HuiLucas/LugDesign/README.md

# LugDesign
Repository To Optimize a Lug Design

Readme is tbc
