HuiLucas/LugDesign/D03_WP4.pdf

# Cutting-Edge Solar Array

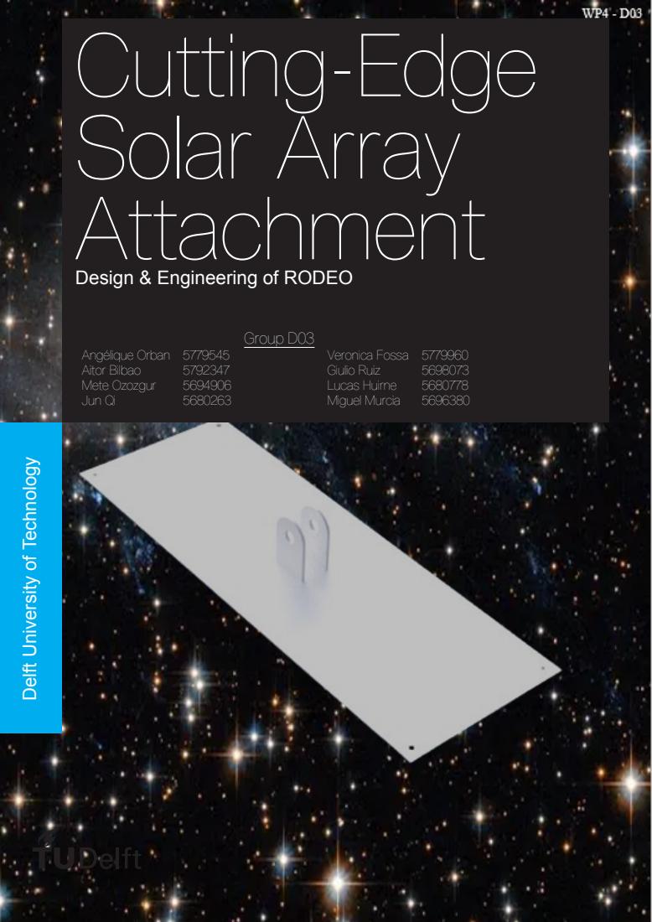
[picture p1: page 1]
Attachment; Group D03; Angélique Orban 5779545; Veronica Fossa 5779960; Aitor Bilbao; Giulio Ruiz; Mete Ozozgur; Lucas Huirne; Jun Qi; Miguel Murcia

Design & Engineering of RODEO

Delft University of Technology

This page is intentionally left blank.

# Cutting-Edge Solar Array

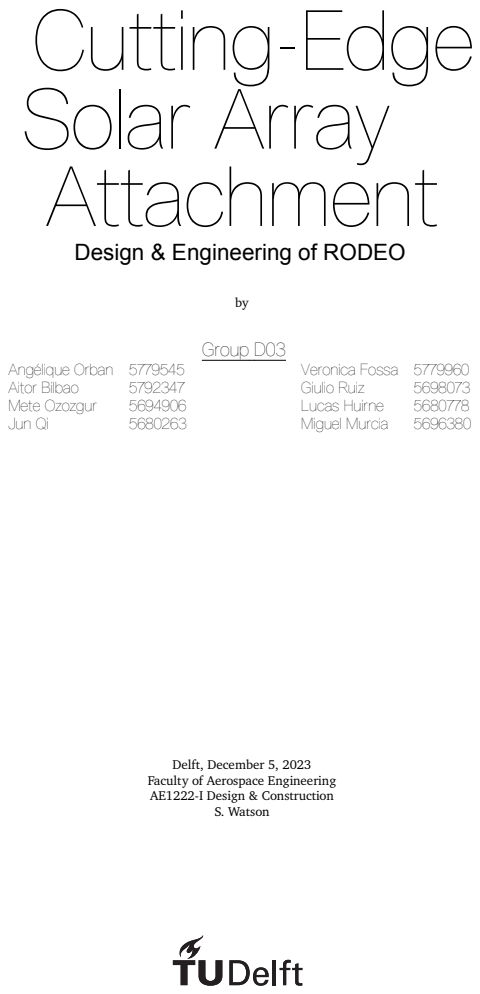
[picture p2: page 3]
Attachment; Group D03; Angélique Orban 5779545; Veronica Fossa 5779960; Aitor Bilbao; Giulio Ruiz; Mete Ozozgur; Lucas Huirne; Jun Qi; Miguel Murcia; S. Watson

Design & Engineering of RODEO

Delft, December 5, 2023
Faculty of Aerospace Engineering
AE1222-I Design & Construction

# Preface

## For tribal man space was the uncontrollable mystery. For technological

man it is time that occupies the same role.

## Marshall McLuhan

This report is the result of the collaborative efforts of eight second-year Aerospace Engineering students at Delft University of Technology. The aim of this report is to document and showcase the scientific rationale and design approach for an Earth-observing satellite under the name of RODEO. RODEO is short for Remote Observer of Data for an Earth Overview. This satellite will bridge a gap in the knowledge of mankind, in a world where precise modeling and prediction of natural phenomena remain elusive. The satellite, equipped with state-of-the-art instruments, will acquire data for weather models, climate models, and seismology.

## RODEO will carry various instruments, that will perform the following functions:

- High-resolution imaging of the Earth’s surface for various ends;
- Measuring of weather and climate variables, as well as volcanic activity with a multi-spectral scanner;
- Atmospheric sounding to measure weather and climate variables at multiple altitudes above land and water.
- Imaging of the earth surface with a radar, to observe the earth in high resolution in the night and

## during cloudy periods

Several constraints on the final design of RODEO have been set by the tender, such as mass, power, size, temperature, reliability, and cost constraints. The mission has to be operational in a Low Earth Orbit for a minimum of five years and needs to be launched in 2025.

The authors would like to thank their TA Calvin Grootenboer for his help during the design process.

## Delft, December 5, 2023 Faculty of Aerospace Engineering | AE2111-I Systems Design (Q2)

Sincerely,

## Miguel Murcia Lucas Huirne Veronica Fossa Angelique Orban Aitor Bilbao Giulio Ruiz de Cardenas Mete Özözgür Jun Qi

i

# Summary

This report analyses the attachment system of the solar panel for the RODEO spacecraft. It shows step by step the design of the lugs, the fasteners and flanges, together with the choice of materials. In the previous work package, the solar energy has been selected as the primary source of energy, with an area

## of 7.54 m²

in order to meet the power requirements and a mass of 17.68 kg. From these values the operational loads together with the launch loads have been studied in chapter 2, caused from the acceleration of the rocket in order to achieve the required orbit. The calculated launch loads can be found in table 2.1.

In chapter 3, the lug configuration have been discussed between one or two lugs and the final decision have been found once the optimization results have been obtained. Moreover, the constrains of the design parameters and the loads that could cause the failure of the lug have been found and put into code using Python, in section 3.2.

In chapter 4, constrains have been added to the fastener for the backup plate and the bearing check have been performed, from identifying the center of mass, to deriving the moment arm, the moment and finally finding the resultant force. The maximum stress has been then compared with the yield strength of the selected material for the back-plate of the lug. Subsequently, the force acting on each fastener has been found, as well as the shear stress caused by it and then compared with the shear yield strength of the material. In section 4.4 the selection of fasteners has been done, observing that the exact dimensions of the fastener depend on the diameter of the hole and the length of the fastener depends on the thickness of the back-plate of the lug.

In chapter 6, the optimization process is explained, which depends on the material, its yield strength and density. Once the optimization is run for each material, a trade-off is established in section 7.1to select the most appropriate one. The final design, described in section 7.3. Two lugs, two flanges and four fasteners have been found to be the best configuration; the material selected for the lug is 2024-T4 and Titanium for fasteners. The total mass is 79.05 kg. More specific information has been summarized in ??. It can be visualized in figure 6.1.

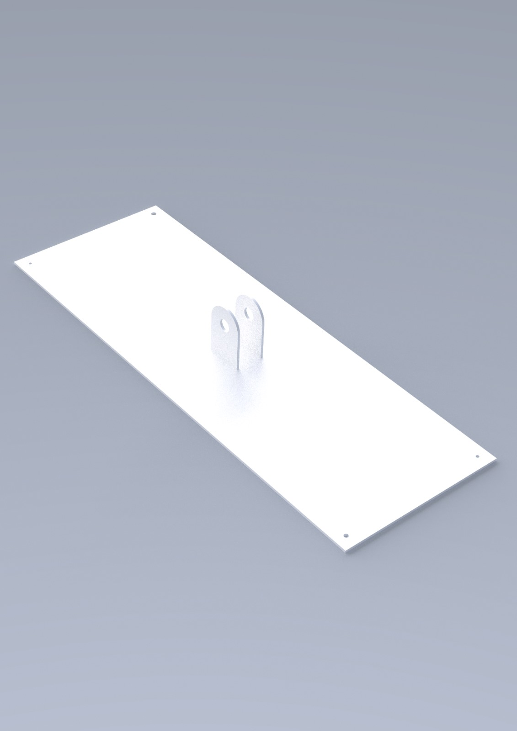
[picture p3: figure]

### Figure 1: Final attachment design

ii

# Contents

Preface | i
Summary | ii
List of Symbols | iv
List of Tables | vi
List of Figures | vi
1 Introduction | 1
2 Load Analysis | 2
3 Lug Configuration and Flange Design | 4
4 Fasteners Configuration | 9
5 Thermal Stresses | 15
6 Optimization Process | 16
7 Material Selection | 20
8 Post Processing and Visualization | 24
9 Conclusion | 25
References | 27
Appendices | 28
A Appendix Code | 29
B Appendix CAD Drawings | 56
C Appendix Task Distribution | 58

## iii

# List of Symbols

## Symbols

WSA | Weight solar array | N
Ra | Ratio of applied axial loads | -
Rtr | Ratio of applied transverse loads | -
M.S. | Margin of safety | W
Kt | Stress concentration factor | -
Ftu | Ultimate tensile force lug | N
At | Net tension area lug | mm²
Kbry | shear-bearing efficiency factor | -
Abr | Bearing area | mm²
FLy | Load along y-axis | N
xcg | x-coordinate of center of gravity | mm
zcg | z-coordinate of center of gravity | mm
Ai | Area of the i-th fastener hole | mm²
xi | x-coordinate of i-th fastener hole | mm
zi | z-coordinate of i-th fastener hole | mm
nf | Number of fasteners | -
Fcgx | Force acting at the center of gravity of the fasteners in the x-direction | N
Fcgz | Force acting at the center of gravity of the fasteners in the z-direction | N
ri | distance of the i-th fastener hole to the center of gravity of the holes | mm
t2 | Thickness of back-plate | mm
t3 | thickness of spacecraft wall | mm
Dfo | Outer fastener diameter | mm
Dfi | Inner fastener diameter | mm
E | Youlgs Modulus | GPa

## Greek Symbols

σ | Normal stress | MPa
σyield | Material yield stress | MPa
τ | Shear stress | MPa
π | Ratio of circumference and diameter | -
φ | Force ratio | -
δ | Compliance/material deflection | mm

## Lug Abbreviations

ℎ | Distance between flanges | mm
t1 | Thickness of flange | mm
w | Width of flange | mm
D2 | Diameter of fastener hole | mm
t2 | Thickness of the back-plate | mm
t3 | Thickness of the satellite skin | mm
D1 | Diameter of the flange hole | mm

iv

v

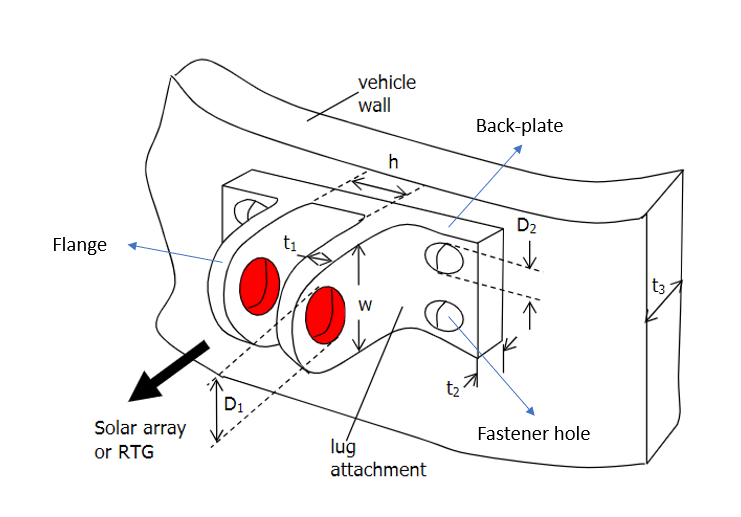
[picture p4: figure]

### Figure 2: Lug Abbreviation Modified [1]

# List of Tables

## 2.1 Summary of launch loads acting on the lug | 3

## 4.1 Fastener Final Choice | 14

## 7.1 Material options that can be used for the fasteners and their properties | 20 7.2 Trade-off table of the materials that can be used for the fasteners | 20

7.3 Properties of available materials for the lug design and resultant mass of chosen lug con-

## figuration | 21 7.4 Trade-off system displaying average weights | 21 7.5 Trade-off table displaying the score | 22 7.6 Final Configuration | 23

## C.1 Task Distribution | 58

# List of Figures

1 | Final attachment design | | ii
2 | Lug Abbreviation Modified [1] | | v
2.1 Launch loads experienced by the lug | | 3
3.1 Stress Concentration factor for axially loaded lug [3] | | 5
3.2 Materials corresponding to the graphs in figure 3.1 [3] | | 6
3.3 Values of shear-bearing factors for lugs [3] | | 7

## 4.1 Coordinate system to determine the centroid | 10 4.2 Stresses produced by the fastener [1] | 12 4.3 Typical fastener with a shank[5] | 14 4.4 Typical substitution length[5] | 14

## 6.1 Flowchart of the MainOptimizer | 19

## 7.1 Final Design | 23

## 9.1 Topology Optimization | 26

vi

1

# Introduction

The RODEO mission is an ambitious Earth Spectral Orbiter endeavor that revolves around a satellite located in a Sun-synchronous low Earth orbit, approximately 700 kilometers above Earth’s surface. The main objective of the mission is to gather information about the Earth’s surface for the purpose of mapping and studying the seismic activity of tectonic plates. Due to the orbit around Earth it is possible to use solar energy as the primary source of energy for the satellite. A fully operational and orientation of the solar array is of big importance in order to accomplish the mission. This includes a good attachment system of the solar array to the spacecraft, which is going to be designed in this report, including a fitting that connects the system to the vehicle and some fasteners.

The aim of this report is to design the attachment lug for the solar panel of the RODEO satellite. The detailed structural design of an attachment lug will initially be performed, by analysing the forces and stresses acting on it, and then the design will be iterated and a trade-off based on the outcomes is going to be necessary to identify the best configuration. Assumption will be done and explained throughout the report, and this will lead to a low-fidelity model.

The report will be presented in the following structure. In chapter 2 a detailed load analysis will be performed, including the operational loads and the launch loads. In chapter 3 different lug configurations will be investigated and successively, the flanges will be designed and analyzed in section 3.2. The fasteners are going to be discussed in chapter 4, with the final selection after checking the different forces acting on them, bearing and pull-through. The effect of thermal fluctuation will then be discussed in ?? and in chapter 6 the optimization process of all the previous analysis performed on Python will explained. The final material selection for the lugs and fasteners will be performed in section 7.1. Finally, insection 7.3 the final design of the attachment system will be presented and in chapter 8 visualisations and post processing will be discussed. The entire code in Python can be found in appendix A, together with the drawings of the final design, in appendix B.

During this project over almost 1750 lines of code were written. This code can be found in the repository ”HuiLucas/LugDesign” on GitHub ¹. To run the code it is possible to clone the code from there. It is also possible to pull a whole container of code from Docker Hub, in the repository ”lhuirne/lug_design3” ². The code was also uploaded to a Microsoft Azure Container Instance and to AWS EC2 using free computing/storage for students, but those are not publicly visible.

¹See: https://github.com/HuiLucas/LugDesign.git ²see: https://hub.docker.com/r/lhuirne/lug_design3

1

2

# Load Analysis

The design of a lug requires an exploration of the several loads and moments that the component will experience during its lifetime. This chapter contains a detailed load analysis describing the launch loads and the operational loads.

# 2.1. Launch Loads

Launch loads occur due to the acceleration of the rocket as it approaches the required orbit. The lug(s) must support the weight of the solar panel in the stowed configuration as it reaches these maximum loads. The stowed configuration assumes that panels are folded in the longitudinal direction of the spacecraft for it to fit inside the payload fairing.

The launch loads that will act on the spacecraft have been given by Space X when describing the Falcon 9 launch rocket. The axial load equals 6g, which is six times the gravitational constant, it is assumed that this constant takes into account 1g of the gravitational pull on the solar array. This acceleration has to be multiplied by the mass of the solar panel to find the force acting on the hinge, which will give a reaction force. The mass of the solar panel is 17.68 kg, thus the total axial force is 1040.64 N using equation 2.1. Knowing that the maximum lateral acceleration of the spacecraft during launch is 2g, the maximum lateral load required to be supported by the lug(s) can be calculated to be 346.88 N using equation 2.2. It can be assumed that this acceleration applies to both x- and y-direction, as the launch vehicle is free to rotate. These lateral accelerations during launch will also cause a moment about the y- and x-axes respectively. To calculate these moments, the distance between the centre of mass of the panel and the reference point of the lug, shown in figure 2.1, where all forces and moments are applied, must be multiplied by the force experienced laterally. Given that the panel has a length of 3.77 meters, and assuming an even distribution of mass along the panel, such a distance equals 1.85 meters, which leads to a maximal moment of 653 Nm about both the y- and x-axes. The moment around the z-axis would only be caused by a spinning of the rocket along its axis, which is negligible, as the Falcon 9 has a very slow spin rate. This moment direction will be non-negligible later on in the analysis, as the forces being introduced at the shaft location, will cause a moment in the z-direction for the back plate and fasteners, which will be discussed further on in the report.

FA = mSAaA | (2.1)
FL = mSAaL | (2.2)

Considering a safety factor of 1.25 [2], the loads summarised in table 2.1 can be obtained. The decomposition of forces and moments generated on the lug(s) due to the launch loads and their reaction can be observed in figure 2.1. The decomposition of forces and moments on the flange(s) and fasteners will be explained throughout the report.
Note that the forces and moments in blue are the reaction loads if the lug is set to be an isolated system.

# 2.2. Operational Loads

RODEO will also suffer external disturbances during its lifetime and will require internal torques to ensure its correct operation. Such internal torques will be generated by an electrical motor that will rotate the solar panel during operation. However, the structure containing the motor will not be load-carrying, instead, the lug will carry all loads and moments. As calculated in WP3, the internal torque required

2

2.2. Operational Loads | 3

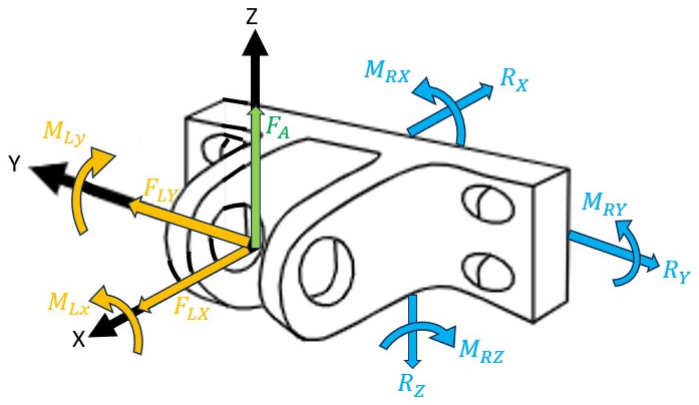
[picture p5: figure]

### Figure 2.1: Launch loads experienced by the lug

### Table 2.1: Summary of launch loads acting on the lug

Force | Value (Magnitude) [N] | Value (SF=1.25) [N]
FA | 1040.7 | 1300.8
FLx | 346.9 | 433.6
FLy | 346.9 | 433.6
Moment | Value (Magnitude) [Nm] | Value (SF=1.25) [Nm]
MLx | 653.9 | 817.4
MLy | 653.9 | 817.4

for changing the orientation of the spacecraft for Night Mode Operation, which is essentially rotating the spacecraft during the eclipse for imaging, equals 3.03 [Nm]. Also, during the eclipse, the spacecraft will suffer a sinusoidal torque of 9.38 [Nm] that will enable accurate imaging of the UMBRA-SAR. The first torque addressed will be applied twice in each orbit. It will be applied during 45 [s], which leads to a slow rotation. For the design of the lug, this torque can be considered negligible.

During Night Mode Operation, the sinusoidal torque will lead to fatigue. However, the value of such a torque leads to a smaller loading than the moments calculated in section 2.1, and will therefore not be considered during the design of the lug. It will be addressed in section 7.1 when selecting the final material.

The goal of determining the load is to obtain the limiting case. It can be observed that the resultant operational loads, derived from these torques, are negligible, or insignificant when compared to the launch loads. Thus, it can be assumed that the moments caused by the operation of the spacecraft won’t limit the design, and only the launch loads should be taken into account.

3

# Lug Configuration and Flange Design

In this chapter, the different lug configurations will be investigated and a choice will be made between the single or double lug setup based on the loading and solar panel attachment. The second part of this section consists of a description of the process behind the design of the flanges.

# 3.1. Selection of lug configuration

## 3.1.1. Comparison between single and double configuration

Two configurations that are investigated are single and double lug configurations. Such a design choice would influence the loading distribution described in figure 2.1, the forces would be halved making the overall dimensions smaller in a two-lugs configuration and the moment acting along the x-axis would be translated into two forces acting on each lug, and would be therefore dependent on the distance between the two lugs, limited to two meters, the width of the spacecraft. The choice of the configuration influences a lot of parameters besides the loading such as the attachment of the solar panel. In a single-lug configuration, the solar panel would have to be attached on the side of the lug resulting in a large moment along the x-axis whereas in a two-lug configuration the solar panel can be attached in between the two lugs, potentially reducing the amount of torque on each lug. One last parameter that the lug configuration would influence is the weight of each lug. Even though not limiting the design, the mass of the lugs should be taken into consideration since selecting a more lightweight design with comparable performances is preferred.
The choice of the final configuration has been taken once the optimization results were obtained in subsection 3.2.2.

## 3.1.2. Locking mechanism for the shaft

Regardless of the configuration chosen, the solar panel shall be attached to the spacecraft by the means of one/two shaft(s) going though the lug(s). The locking mechanism opted for that would stabilize or rotate the solar panel when deploying consists of one or two motors depending on the configuration. In the single-lug configuration, a single shaft connected to one motor would lock the solar panel in place. Whereas in a double lug configuration, given the distance between the lugs came out to be 1.4 meters as a result of the optimization in subsection 3.2.2, the solar panel would be attached with two shafts, each going through one lug. Therefore, each one of the two shafts would be connected to their own motor.

# 3.2. Design of the flanges

## 3.2.1. Constraints on the design parameters

## The design of the lug is based on three considerations:

- The lug shall withstand the limiting loads and moments applied to it, and described in figure 2.1;
- The mass of the lug shall be minimised.

The design of the flange will consider a list of parameters containing the width and thickness of the flange; the diameter of the hole in the flange; and the distance between the two flanges of each of the lugs. These will be determined based on the loading case described under chapter 2.
The calculations made to design the lugs take the limiting stress to be the yield stress with a safety factor of 1.1 [2], in order to prevent catastrophic events due to yielding. Efficiency factors for yield will indeed be used rather than for ultimate tension or stresses. No design constraints were imposed on the maximum deflection of the flange or other elastic behaviour.

4

3.2. Design of the flanges | 5

According to the method described in section D1 of the book ”the Analysis and Design of Flight Vehicle Structures” by Bruhn [3] the lug can fail due to different type of loading. The loading types investigated and analysed for the sizing of the flange are: failure due to tension across the net section, failure due to transverse loads and failure due to shear. To check that whether the lugs will break under the loads applied equation 3.1.
R

1.6

a + R¹.6
tr = 1 | (3.1)
In equation 3.1 the term Ra stands for the axial component of the applied ultimate load divided by the smaller of the two values obtained by calculating the tension across the net section and the shear-out bearing strength [3]. Rtr is the transverse component of the applied ultimate load divided by the yield strength [3].

However not considering a margin of safety would be equivalent to design for the lug to yield during launch, therefore equation 3.1 must be formulated to account for that margin of safety.

M.S. =

1
(R¹.3

a + R¹.6
tr )
0.625 − 1 | (3.2)

The margin of safety given by equation 3.2 can be estimated to be 0.375 and stems from the product of the safety factor of 1.1 on the material properties by the safety factor of 1.25 on the loads and moments.

Then, the allowable axial and transverse forces can be estimated by equation 3.3 and equation 3.4 from the same section D1 mentioned earlier [3].

## Pu = Kt

⋅ Ftu ⋅ At | (3.3)

The axial load Pu is therefore dependent on the ultimate tensile force Ftu or in this case the force FA

## as can be seen in figure 2.1, the net tension area At

## , which is dependent on the dimensions designed for, and the stress concentration factor Kt

## . The latter can be determined depending on the material in

figure 3.1 with the curves corresponding to the material given in figure 3.2.

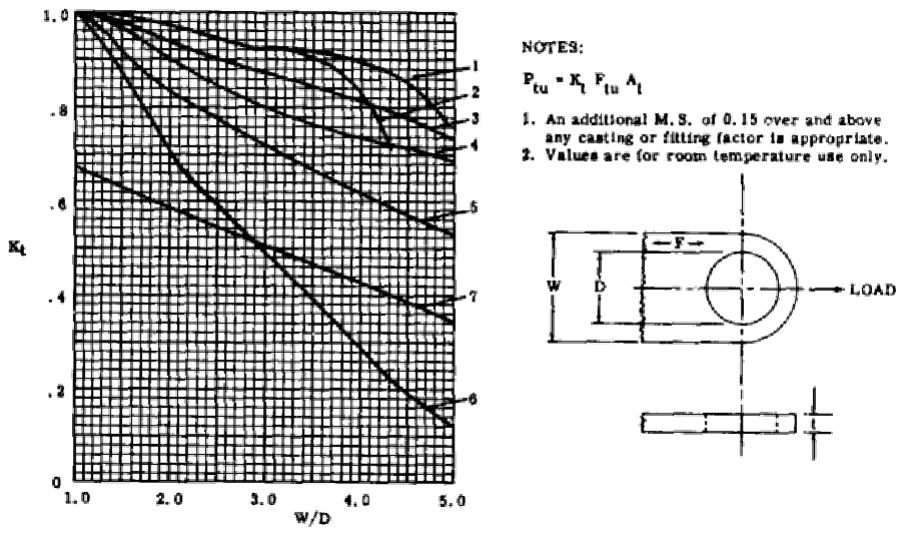
[picture p6: figure]

### Figure 3.1: Stress Concentration factor for axially loaded lug [3]

For the transverse loads, they consists of the forces along the y- and z-axis in figure 2.1 and they will cause the lug to shear if not accounted for. The transverse loads can be computed thanks to equation 3.4. They are therefore dependent on the bearing area, applied forces and shear-bearing yield efficiency factor Kbry, dependent on the thickness-to-diameter ratio (diameter or the hole) of the flange as can be seen in figure 3.3.
Pbr = Kbry ⋅ Ftu ⋅ Abr | (3.4)

In order to make use of Python to iterate through the different possible materials and dimensions, the graphs in figure 3.1 and figure 3.3 were digitized to extract a polynomial relation thanks to the online

3.2. Design of the flanges | 6

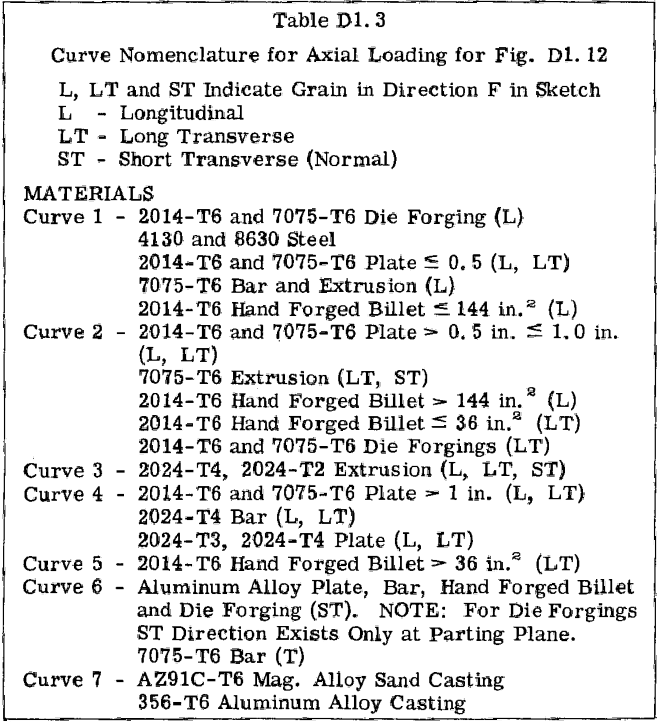
[picture p7: figure]

### Figure 3.2: Materials corresponding to the graphs in figure 3.1 [3]

software automeris.io ¹.

Beside the launch loads, moments are also acting on the lug in the x- and y-directions. As detailed in section 3.1, within a single lug configuration, the moment along the x-axis can be converted into two forces constituting a couple moment that acts on the flanges. Additionally, this force would be combined with the force along the z-axis. When opting for a two lug configuration, the moment along the x-axis creates two equal but opposite in direction forces (couple moment) on the two lugs and, considering the inter-flange distance negligible, the additional force acting on one flange due to this moment would be half the one acting on the lug.

The equation 3.2 can now be adapted given the loading and returns equation 3.5, with d being the distance between the lugs.

M.S. = ((

FLx
Kt

## ⋅ σ ⋅ 1.1 ⋅ At

)

1.6 + (

FA +

My

d⋅NFlanges

## Kty ⋅ Abr ⋅ σ ⋅ 1.1)

1.6)

−0.625 − 1 | (3.5)

Lastly, because of the offset of the load acting along the y-axis, FLy, an extra moment is applied and should also be taken into consideration. Such a moment causes pure bending of the lug and restrict the possible heights of the flange, denoted h. By solving equation 3.6 for the height of the flange, taking the moment of inertia along the z-axis, as it is the axis with smallest moment of inertia, it ensures that the lug will withstand the load.

σyield ⋅ 1.1 =

FLy ⋅ ℎeigℎtflange
I

(3.6)

## 3.2.2. Optimization of the design of the flange

Now that the design constraints regarding the loading have been established, the design process can start. All the lines of code regarding the flange design optimization, digitization of the graphs, etc. can be found in the appendices under Listing A.4.

The function used to generate an optimized lug design is part of the module scipy.optimize, and is called minimize. This function provides a common interface to unconstrained and constrained minimization algorithms for multi-variable functions. In this case, the objective function that is minimized for each material is the mass of a specific part of the flange while constraining the design variables to optimize: the outer radius of the flange e, the thickness t, the diameter of the inner hole to fit in the shaft D and

### ¹https://apps.automeris.io/wpd/

3.2. Design of the flanges | 7

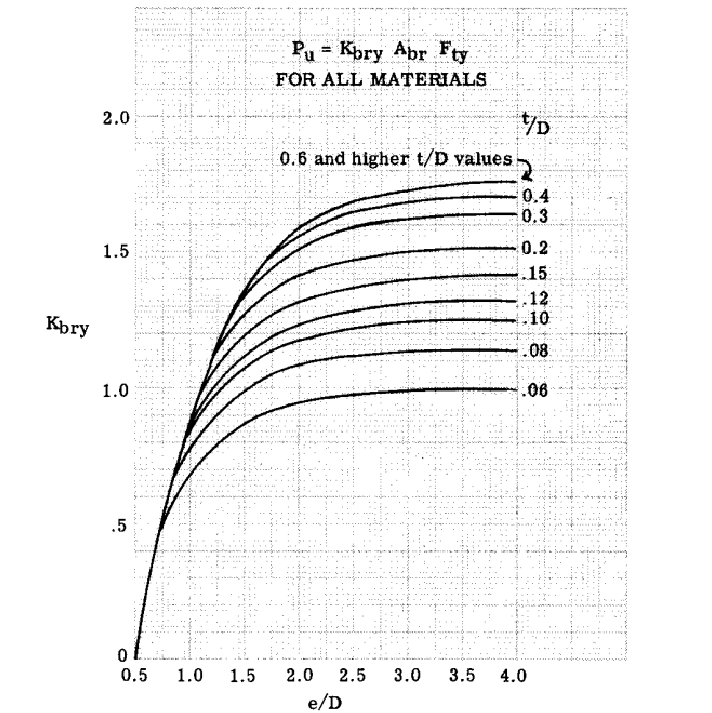
[picture p8: figure]

### Figure 3.3: Values of shear-bearing factors for lugs [3]

the inter-flange distance h.

As mentioned above, the function aims to minimized the the mass of a certain part of the flange, that is the hollow cylinder delimited by the hole and the outer-diameter of the flange. To do so, the algorithm chosen is SLSQP, it minimize a function of one or more variables using Sequential Least Squares Programming. That method was opted for as it allows to constraint the variables given a set of inequalities or equalities. For example, in order to not fail under the launch loads, the design variables should satisfy equation 3.5. Another relevant constraint that was added is that the volume, the design variables and the mass shall be positive. Sometimes to further limit the outcomes to plausible design, constraints such as the inner radius shall be at least 10 times bigger than the thickness are added. All of those constraints are listed in a dictionary, and passed as an argument in the minimized function.

The subtlety lies in the fact that the optimization takes as input initial guesses and, given their accuracy, the function might converge or not. However, from experience, the optimization is very sensible, therefore intricated for-loops are used to iterate through every possible initial e, t, D and h configuration and append every plausible outcomes in an array from which the best configuration was selected. But a major problem arises from this approach: the computation time. At first to overcome this problem, tolerance was introduced. Indeed by adding a tolerance, the optimization converges more easily and less initial guesses have to be provided, implying therefore to find a fine balance between a tolerance low enough to give accurate results and an acceptable amount of iterations. But since that was not enough to speeding up the computation time, Numba is used. It consists of a Just-In-Time (JIT) compiler for Python code which is meant to have it automatically optimized for execution speed.

As investigated in section 3.1, several lug configurations can be selected: a single or double lug configuration. The optimization was made with consideration for both scenarios, allowing for the evaluation of which configuration to choose. When comparing the 3D models automatically generated with numpy.stl, it appeared that when using a single lug, the thickness of the flanges is quite large and the inter-flange

3.2. Design of the flanges | 8

distance quite small whereas when opting for a two lugs at a distance from 50cm to 1m, the thickness of the flanges reduces drastically. Therefore, the two lugs configuration was selected not only for the reason mentioned above but also since it would allow the solar panel to be placed in between the lugs, reducing the moment acting along the x-axis and reducing the magnitude of the loads on the lugs by two.
As mentioned earlier, the optimization is dependent on the material, its yield strength and density. The list of materials considered was taken from the different materials referenced for the graphs under figure 3.2: 2014-T6(DF-L), 2014-T6(DF-LT), 2014-T6(P), 7075-T6(P), 7075-T6(DF-L), 7075-T6(DF-LT), 4130 Steel, 8630 Steel, 2024-T4, 356-T6 Aluminium and 2024-T3. Subsequently, once the optimization is run for each material, a trade-off is established in section 7.2 to select the most appropriate one.

4

# Fasteners Configuration

This chapter discusses the fastener configuration with a detail focus on bearing check and pull through check.

# 4.1. Select fastener pattern for the backup plate

For a given configuration of fastener positions and hole diameters, two constraints are given by the reader. Namely, the distance from the hole position should be at least 1.5 times the diameter of the hole itself. This constraint is chosen to ensure that the stress can distribute itself evenly around the hole preventing stress concentrations that could lead to premature failure. For the same reason, a lower limit is placed on the center-to-center distance between the holes. The magnitude of this distance depends on the material selection for the back plate. In case it was a composite the magnitude of a distance of 4 times the diameter of the hole was chosen.On the other hand it were a metal a distance of 3 times the diameter of the holes was chosen.

To implement these constraints in Python a function was created that takes a list of coordinates of the hole positions and a list of hole diameters to return True if the design complies with requirements. If the design does not comply the function returns False and specifies the index of which hole is causing the issue. This will be useful for the final optimization as it allows us to identify exactly what is wrong in the design such that it can be changed. All the code is present in Listing A.8.

# 4.2. Bearing check for fasteners in back-up plate

To inspect the bearings of the fasteners on the back-plate, start by identifying the center of mass for the fasteners within the back-plate. Utilize the coordinate system outlined in figure 4.1, where the x and z prime axes align with the forces projected onto the plate. This alignment proves particularly beneficial for subsequent analysis of in-plane forces. The centroid’s coordinates can be computed using

## equation 4.1 and equation 4.2, where Ai

## represents the area of the i-th fastener hole. It is noteworthy

that the chosen coordinate system ensures that both xi and zi are consistently positive.

xcg =

## ∑ Aixi

∑ Ai

(4.1)

zcg =

## ∑ Aizi

∑ Ai

(4.2)

Proceeding further, the in-plane forces can be calculated employing equation 4.3, equation 4.4, and

## equation 4.5. In these equations, nf denotes the total count of fasteners, Ai

## signifies the cross-sectional area of the i-th fastener, and ri

## represents the radial distance from the center of the i-th fastener to the

previously determined center of gravity of the fasteners.

Fin−plane−x =

Fcgx
nf

(4.3)

Fin−plane−z =

Fcgz
nf

(4.4)

Fin−plane−My =

## MyAiri ∑ Air

2
i

(4.5)

9

4.2. Bearing check for fasteners in back-up plate | 10

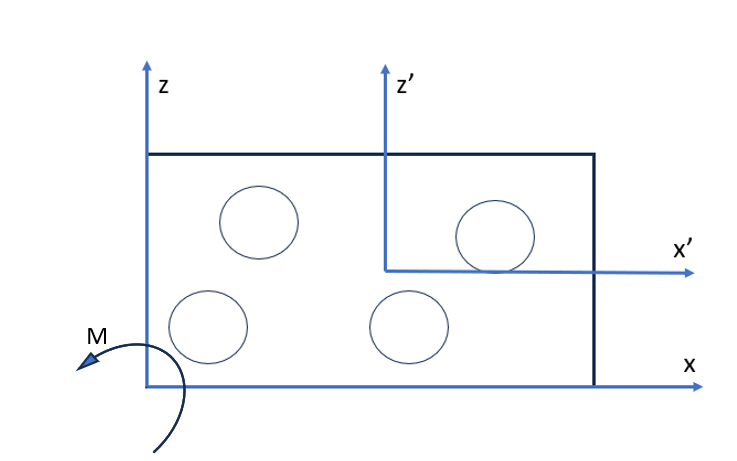
[picture p9: figure]

### Figure 4.1: Coordinate system to determine the centroid

Following that, it is crucial to shift the loads onto the back-plate of the lug. The forces involved are FL and FA − WSA, as indicated in figure 2.1 during the launch phase, acknowledged as the more demanding aspect of lug design. However, these forces will give rise to a moment on the back-plate, contingent upon the predetermined location of the centroid of the holes. In total, there are nine situations concerning the x’-z’ coordinate system, as illustrated in figure 4.1.

1. The centroid lies on the origin, then the resultant moment is zero.
2. The centroid lies on the positive x’ axis, then there is a negative resultant moment caused by Fz

3. The centroid lies on the negative x’ axis, then there is a positive resultant moment caused by Fz

4. The centroid lies on the negative z’ axis, then there is a positive resultant moment caused by Fx.
5. The centroid lies on the positive z’ axis, then there is a negative resultant moment caused by Fx.
6. The centroid lies on the first quadrant, then there is a negative resultant moment caused by Fx and Fz

7. The centroid lies on the second quadrant, then there is a negative resultant moment caused by Fx

## and a positive resultant moment caused by Fz

8. The centroid lies on the third quadrant, then there is a positive resultant moment caused by Fx and Fz

9. The centroid lies on the fourth quadrant, then there is a positive resultant moment caused by Fx

## and a negative resultant moment caused by Fz

The subsequent step involves determining the moment arm on which the resultant moments are generated. This entails calculating the perpendicular distance from the centroid of the holes to the forces acting on the origin of the x’-z’ coordinate system. Consequently, My is derived. Subsequently, it is necessary to determine the distance from each hole to the centroid of the holes, denoted as ri

## . Utiliz-

ing this information, the in-plane force caused by My can be readily computed. The resultant force is

4.3. Pull-through check | 11

then determined by considering only their magnitudes, as they do not act along the same axis, using equation 4.6.

Fresultant = √F
2

in−plane−x + F²

in−plane−z + F²
in−plane−My

(4.6)

It’s important to note that the thermal force can be incorporated into equation 4.6. This addition will lead to a larger resultant force, subsequently causing an increase in stress. To assess the potential yield of the material, a comparison is made between the stress and the yield stress of the selected material for the plate. The stress is determined using equation 4.7.

σ =

Fresultant
D ⋅ t2

(4.7)

Here, D represents the diameter of the holes, and t2 is the thickness of the back-plate of the lug. It’s crucial to recognize that if the holes have varying diameters, the stress on the holes will differ. In such instances, the maximum stress should be compared with the material yield stress, and this maximum stress occurs at the holes with the smallest diameter.

To translate the aforementioned theories into Python code, several functions have been defined. These functions calculate the centroid, the corresponding in-plane forces, and the stress induced by the resultant forces. In the final step, the maximum stress is compared with the yield strength of the selected material for the back-plate of the lug. The main loop returns one of two messages: either ”The bearing stress check passed” or ”The bearing stress check failed, increase the thickness of the back-plate.” It’s important to note that no recommendation is provided to alter the configuration of the fastener hole. This is because the size and configuration of the fastener holes significantly impact the final calculation, and adjusting these parameters for fine-tuning is not advisable.

# 4.3. Pull-through check

Once the force acting on each fastener has been determined, it is necessary to check that this force will not cause failure in the fasteners.

The axial force on each fastener, defined as Fyi, produces a normal stress on the area in between the outer diameter of the fastener and the hole, visible in figure 4.2, and a shear stress. The shear stress acts on the vertical plane of the plate at the outer diameter of the fastener, causing pull-through. It is necessary to compare the shear stress with the yield shear stress of the material of the lug and check that the yield shear stress is bigger.

In order to determine the stress on each fastener, the axial loading of each fastener must be known. This can be calculated by considering two components. Firstly, the normal force which they must bear, which is defined as Fpi, and is simply the total force in the y-direction Fy divided by the number of fasteners nf, as is seen in equation 4.9.

Fpi =

Fy
nf

(4.8)

There is another component that must be considered for the axial load on each fastener, which is the contribution from the moments. In this loading case, there will be a moment in the x-direction to be carried by the fasteners, which is the result of the Mx moment presented in chapter 2, added with the Fz multiplied by the height of the flange, as this will also create a moment in the x direction. In the z-direction, there will also be a moment, which is due only to the Fx force, multiplied by the flange height. These two moments will lead to each quadrant of the back plate being loaded differently. This means some of the fasteners will have much more force on them, and under certain loading cases, they might be loaded in compression instead of tension. The contribution to Fyi from the moments can be calculated using equation 4.9, where A represents the area of each fastener hole and r represents the distance from the hole center to the location of the load application, in the relevant direction.

Fp−M−i =

Mz

⋅ Ai

⋅ ri

## ΣAi

⋅ r²
i

(4.9)

4.4. Selection of fasteners | 12

Summing the total of Fpi and Fp−M−i gives the Fyi, or the axial force on each fastener. In the code, it was observed that the contribution from the moments to the load on each fastener was much larger than the Fy contribution, therefore, the most effective change to make would be to increase the distance from the fastener to the location of load application.
This check will lead to modification of the position of the fasteners. If the shear stress produced by the vertical force is bigger than the shear yield stress, failure would occur and this leads to the need for a modification. On the other hand, if failure does not occur, it is possible to still reduce the distance of the fasteners, saving mass. This optimization of the fastener locations is performed in chapter 6.

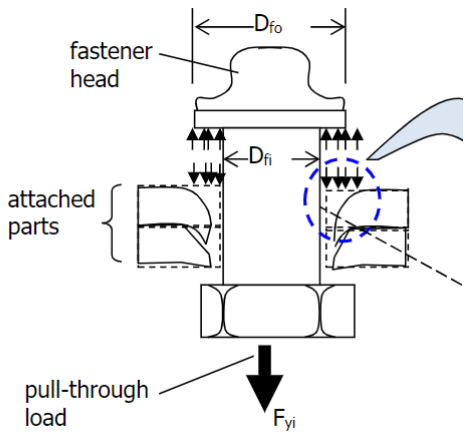
[picture p10: figure]

### Figure 4.2: Stresses produced by the fastener [1]

The calculation needs to be performed separately for each fastener since the force acting on it is different, as well as the inner diameter. Moreover, the material has not been selected yet so it going to be computed as a variable in the code, but the yield stress and the shear yield stress are going to be known parameters for each material. The shear yield stress of the materials is known and it is going to be compared with the shear stress produced by vertical force Fy.

The value of the normal stress σz can be calculated using equation 4.10, and it depends on the diameter of the fastener, called Dfi, previously calculated, and the outer diameter of the faster, Dfo, which has been assumed to be 1.8 times the inner diameter after analysing different bolts from [4]. This assumption was used just for the check function to simplify the calculation. In the final design, given the inner diameter already existing bolts with precise dimensions have been found and used.
The shear stress generated by the vertical force Fy can be found with equation 4.11 and it is the one to be compare with the shear yield stress of the material.

σ =

Fy

## π ∗ 1/4 ∗ (D²

fo − D²
fi)

(4.10)

τ =

Fy
π ∗ Dfo ∗ (t2 + t3)) | (4.11)

All of these equations have been put into a check function in Python, where the output is going to tell if it is necessary to increase the thickness or not. In the optimization code, explained in chapter 6, the thickness will be optimized using this function that checks if the lug can withstand the force without failure.

# 4.4. Selection of fasteners

The decision has been made to opt for an off-the-shelf fastener rather than designing a state-of-the-art fastener. This choice is based on two primary considerations. Firstly, off-the-shelf fasteners undergo rigorous testing and extensive applications, demonstrating reliability within certain limits. Secondly, the

4.4. Selection of fasteners | 13

customization and design of components, such as fasteners and bearings, tend to significantly extend both the development time and budget of the mission. Furthermore, the outcomes of such customization efforts may not consistently align with the expended effort. In the selection of the fastener, three key

## criteria are considered:

## 1. Material Distinction:

- Stakeholder Requirement: The material of the fastener must differ from the material of the back plate.

## 2. Shank Length Requirement:

- Design Constraint: The length of the shank of the fastener should equal the sum of the thickness of the lug plate and the satellite skin, with an appropriate margin.

## 3. Shank Diameter Requirement:

- Design Constraint: The diameter of the shank of the fastener is to be equal to the diameter of the respective holes, considering manufacturing margins.

A trade-off table is made as table 7.1. With the known material and section characteristics of the fastener, the force ratio could be determined as equation 4.12.

φ =

δa

## δa + δb

| (4.12)

Where δa is the compliance of the attached parts and δb is the compliance of the fastener. To find δa and δb, use equation 4.13 and equation 4.14.

δa =

4t

## Eaπ(D²

fo − D²
fi)
| (4.13)

Where t is the thickness of the back-plate or the vehicle wall, Ea is the young’s modulus of the back-plate or the vehicle wall, Dfo and Dfi are the outer and inner diameter of the fastener as defined in figure 4.2

δb =

1
Eb

∑

Li
Ai
| (4.14)

Where Eb is the Young’s modulus of the fastener material, Ai and Li are the local cross-section of the segment and the corresponding length.

The equation 4.13 illustrates the computation of two force ratios, crucial for thermal stress assessment, concerning the back-plate of the lug and the satellite’s skin. The smaller force ratio, identified as the more restrictive scenario, is denoted as δb. Determining δb necessitates pinpointing the fastener segment. figure 4.3 displays potential segments of a fastener. First, we identify substitution lengths (Lℎ,sub, Leng,sub, and Ln,sub) for deformations in the head, fastener’s engaged region, and nut’s engaged region, respectively (refer to figure 4.3). Statistical methods, as shown in figure 4.4, guide the dimension determination of these parameters.

When selecting the fastener/joint configuration, a preference for a smaller substitution length is advisable to enhance the force ratio and reduce thermal stress. However, choosing a nut-tightened engaged shank is favoured over a threaded hole due to the impracticality of threading the thin (3 mm) satellite skin. The dimensions of L1,2,3 are overlooked since fasteners are typically chosen off-the-shelf, and no evident constraints guide the selection of these dimensions. It is assumed that the shank has a constant diameter, covering the entire distance between the back-plate of the lug and the satellite skin.

In conclusion, the fastener’s exact dimensions depend on the hole diameter (equivalent to the shank diameter) and the back-plate thickness. Notably, if the fastener length exceeds the combined thickness of the back-plate and skin (denoted as ”t”), considerations arise regarding the threading location on the fastener. If threads are solely outside the shank, the shank length should be smaller than ”t” to ensure

4.4. Selection of fasteners | 14

secure tightening. Although an exact match is ideal, manufacturing variations are common. Alternatively, if the shank length surpasses ”t,” the entire bolt length must be threaded or at least until the nut contacts the satellite wall. This design choice relies on market availability, as precision machining may be impractical.

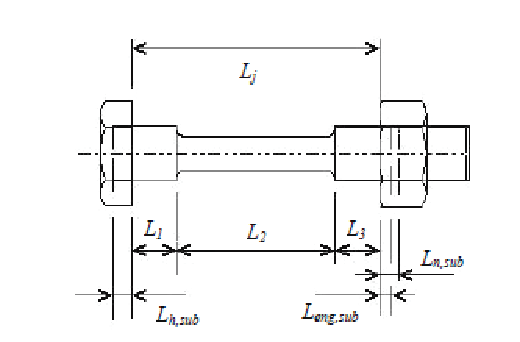
[picture p11: figure]

### Figure 4.3: Typical fastener with a shank[5]

### Figure 4.4: Typical substitution length[5]

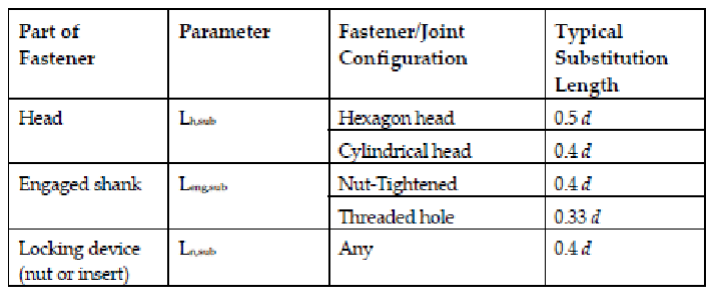
[picture p12: figure]

To implement the fastener type in the Python project a new class was created to combine all of the variables that need to be selected for the fastener like the material, its Young’s Modulus, and the type of bolt used. The creation of such a class is useful to keep the code organized and to facilitate the creation and readability of many functions that have to do with the fastener selection. For example, the force ratio calculations were performed often using this class. The functions follow mainly the equations equation 4.13 , equation 4.14 , equation 4.12. All the equations are to be applied iteratively on all of the holes present in the back plate. For equation 4.13 in particular, two sets of values for compliance can be calculated because both the back-plate and the vehicle will have to be considered. The code calculates both and then checks which set is limiting to find the smallest possible force ratios. All of the code is found in Listing A.9.

### Table 4.1: Fastener Final Choice

Nr. | Diameter [mm] | Insert Length [mm] | Chosen fastener diameter [mm] | Chosen fastener length [mm] | Material | Manufacturer
1 | 1.3 | 3 | 1.2 | 8 (Margin + Nut) | Titanium Ti-6AI-4V | Extreme Bolt & Fastener
2 | 1.7 | 3 | 1.6 | 8 | Titanium Ti-6AI-4V | Extreme Bolt & Fastener
3 | 2.2 | 3 | 2 | 8 | Titanium Ti-6AI-4V | Extreme Bolt & Fastener
4 | 1.3 | 3 | 1.2 | 8 | Titanium Ti-6AI-4V | Extreme Bolt & Fastener

The table 4.1 lists the final design of the fasteners and the corresponding selected market-available fasteners. Note that 8 mm is chosen as the length to allow for a margin (threaded length) and nut. The inserted length 3 mm on the other hand is the summation of the optimised thickness for the back-plate and the satellite skin, see chapter 6. For material, see table 7.1.

5

# Thermal Stresses

In this chapter, the analysis of thermal stresses will be performed, by checking if the current design will withstand the thermal fluctuations, in section 5.1.

# 5.1. Thermal stress check

The RODEO satellite will experience a wide range of temperatures. The solar panel of RODEO will experience temperatures up to 83 degrees when facing the Sun and temperatures as low as -70 degrees when in eclipse, which are values calculated in WP2. The temperature of the lug is assumed to vary in the same way as the solar panels as it is essentially an unshielded attachment of the solar panel. These thermal fluctuations cause thermal stresses, assumed to be constrained to each hole in the back plate. The induced loads due to thermal fluctuations can be calculated through the following formula from the reader [6].

FT = (αb − αp)(1 − φ)EbArefΔT | (5.1)

Here α refers to the thermal expansion coefficient, φ refers to the force ratio calculated in ??, Aref is the cross-sectional area of fastener which will be assumed to be equal to the area of the hole and Eb which is the material stiffness of the bolt.

This formula starts to break down for low-temperature ranges, this is because for lower temperatures metals often start becoming brittle, and the behavior of deformations can no longer be modeled through the linear expansion coefficient. However, for all aerospace applications, metals with specific crystal structures are selected to limit the ductile to brittle transition [7]. Therefore for this mission, it will be assumed that the expansion coefficient will remain constant even at low temperature ranges. Another assumption is that the temperature differences are to be calculated from a reference temperature of 15° [6] denoted as ΔT+ and ΔT− for an increase and decrease in temperature respectively. To make the calculations as limiting as possible the maximal temperatures mentioned earlier were used to calculate the temperature differentials. Once this force is calculated the in-plane forces defined for the bearing check must be summed to see whether the design can withstand such a thermal load. This calculation also depends on the magnitude of the expansion coefficients α. For example, assume that αb > αp for a temperature contraction ΔT− equation 5.2 will yield a positive value of force. This however makes no physical sense since the bolt is shrinking at a faster rate than the plate there is no contact between the two surfaces and therefore no force can be applied. To deal with this problem equation 5.2 can be split into two different calculations.

FT = (αb − αp)(1 − φ)EbArefΔT+ | (5.2)

## and

FT = −(αb − αp)(1 − φ)EbArefΔT− | (5.3)

For the same example now equation 5.3 can be used now yielding a negative value of force which can be properly disregarded.

These equations were implemented in Python for each hole from a list to return individual forces that will vary due to the dependence of equation 5.2 on the area of the hole.

15

6

# Optimization Process

As can be seen in the flowchart in figure 6.1, the optimization process is very long and complicated. The process is controlled by MainOptimizer.py. The file starts with an initial guess, which acts as a base design, from which things are changed to make the variables converge to an optimal design. The parameters from this initial design can be found in Listing A.3 in appendix A. The program can run in a High_Accuracy mode with small step sizes, and a Low_Accuracy mode with large step sizes. The default is to run in Low_Accuracy mode. Generally speaking, the starts with a list of materials, and for every material it makes a ’best’ design using the optimizer with low accuracy. Then, the best designs of all the materials are compared with each other, and the lightest ’best’ design is chosen. This design is put into the optimization algorithm again, this time with high accuracy. The resulting optimal design is the output of the program.

# 6.1. Optimization: Flanges

Within the LocalLoadCalculatorAndLugDesignerAndLugConfigurator.py file, the first parameters that are optimized for each material are w (defined as 2e from [1]), t1, D1, and ℎ. These meaning of these variables can be found in figure 2. This optimization happens with the Minimize function from the Python package SciPy, using the ’SLSQP’ optimization algorithm. The goals for this optimization is to reduce mass, so there is function that can calculate the mass given a combination of parameters. There are also constraints, to make sure the optimizer does not produce unreasonable designs. More about this process can be found in subsection 3.2.2.

Once the w, t1, D1 and ℎ parameters were chosen, a flange length needed to be calculated. The calculation for this can be found in subsection 3.2.2.

The result from the LocalLoadCalculatorAndLugDesignerAndLugConfigurator.py file is an array of designs. Every entry in this array is an object from the class DesignInstance (see Listing A.1 in appendix A). These objects are called ’Designs’, and every Design object contains its parameters. Every entry in the aforementioned array contains the Design Object that is optimal for the given material. So if the program starts with 6 different materials under consideration, then the LocalLoadCalculatorAndLugDesignerAnd-LugConfigurator.py generates an array with 6 different Designs. The first design will be optimal for the first material under consideration, the second design will be optimal for the second material under consideration, etc.

# 6.2. Optimization : Back-plate and fasteners

The second optimization happens in the MainOptimizer.py file itself. The following text will describe the optimization process starting with a design object for one material. This process will happen multiple times, once for every material, so the output will again be an array of design objects.

The optimization first applies the bearing check as described in section 4.2, and if the design fails this check, that means that the thickness of the backplate needs to increase. If it passes this check, it can go on to the next check, which is the Pull Through Check, as described in section 4.3. If it fails this check it changes the coordinates of the holes as described in section 4.3, or it can also increase the thicknesses of the backplate and the vehicle wall. If it does pass the Pull Through Check, then goes into a new loop. This loop repeats the following cycle: Calculating the fastener size, calculating the thermal loads, using the thermal loads to redo the Bearing Check, and finally redo the Pull Through check. The loop stops once both the Bearing Check and the Pull Through Check are passed with the thermal loads taken into

16

6.2. Optimization : Back-plate and fasteners | 17

account. The selection of the fasteners is explained in section 4.4. Once the fasteners are selected, the bolt sizes are used to calculate the thermal loads as described in section 5.1. The resulting Thermal Loads are then used by the Bearing Check function to see whether the designs also passes the Bearing Check with the Thermal Loads applied. This is also explained in section 4.2. If the Bearing Check with the thermal loads fails, then the thickness of the backplate neecs to increase, and if it passes, the Pull Through Check is applied again. The Pull Through Check changes the hole coordinates again, if necessary.

Once both the Bearing Check with thermal loads and the Pull Through Check are passed, the thicknesses of the backplate, the vehicle wall, and the coordinates of the holes are known. It should be noted that the t3 cannot be changed in the design of the RODEO spacecraft, because that design is already done. However, the optimizer will still recommend increasing t3 anyway, if it is certain that t3 will fail because of Pull Through Failure.

Because the hole coordinates are chosen by the Pull Through Check function in such a way that the fastener under the most stringent loads does not fail, that means that the other holes are under a lower load than their limiting failure load. This also means that these fasteners could become smaller. This is done by the function SelectFastener.check_size_red uction_possibility.

At this point in the process, the coordinates and sizes of the holes are known, but the size of the bottomplate is not known. Therefore, the function SelectFastenerConfiguration.O ptimize_holes calculates the required length and width for the bottomplate such that the holes have enough clearance from the edge as explained in section 4.1.

The next step would be to calculate the Margins of Safety as required in WP4.12. This was not done, because nowhere in the process it is known what the maximum allowable loads would be. This does not mean that our Margin of Safety is zero: safety factors of 1.1 were applied for all material properties, and safety factors of 1.25 were applied for all forces and moments.

Now, the Post Processor calculates the volume of the design with a package called CadQuery, as explained in chapter 8. This volume is multiplied by the density of the material to calculate the mass. The Post Processor also provides a visualization of the design in MatPlotLib, and exports the design to stl, step, and dxf files.

After this whole process, the array with design objects is the result. These objects are compared on the basis of there mass. All properties of all designs are printed to the console. The design with the lowest mass will be optimized again in higher accuracy. Finally, the the parameters of this high accuracy design are printed, and the design is exported to stl, step and dxf files. When this is done, the program stops.

6.2. Optimization : Back-plate and fasteners | 18

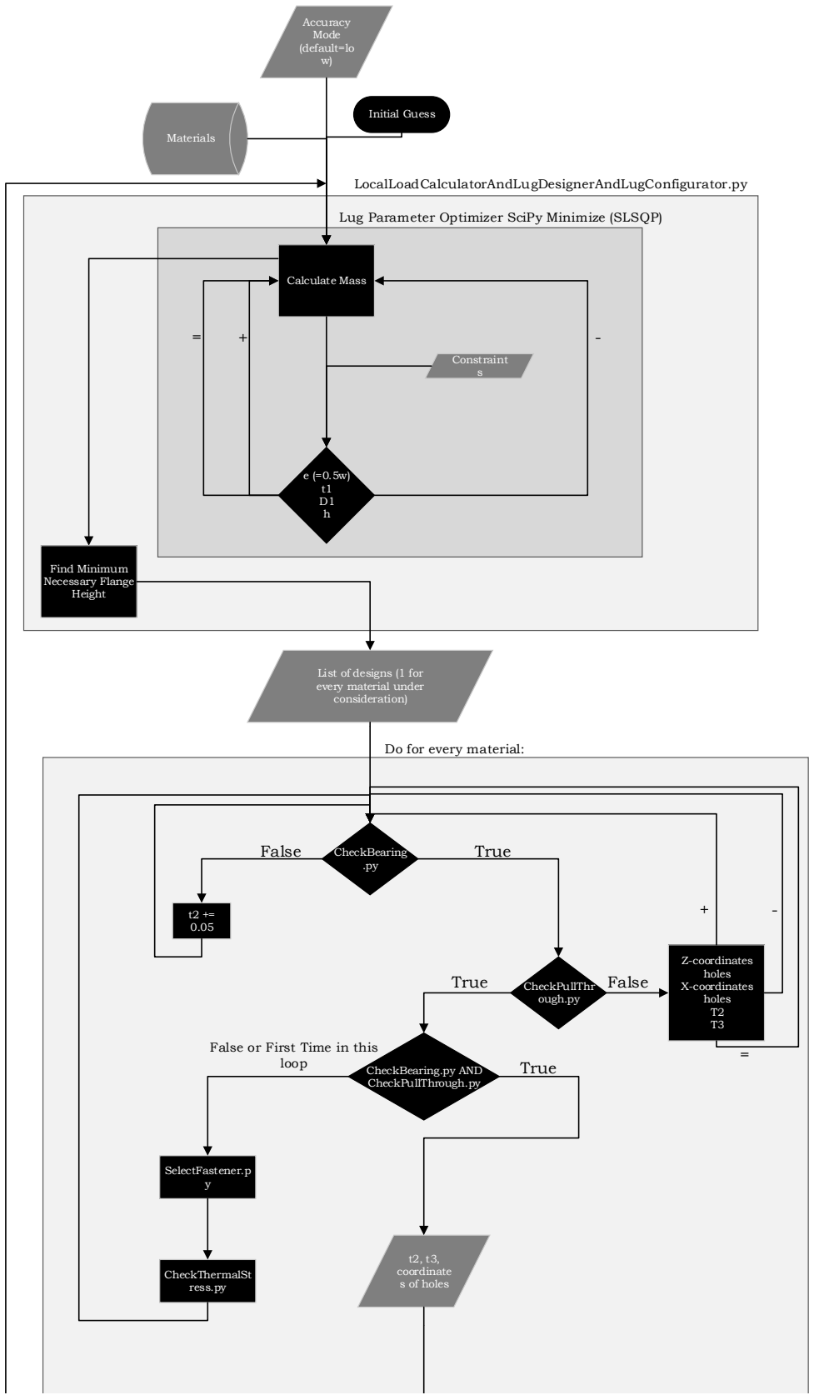
[picture p13: figure]
Initial Guess; Materials; Calculate Mass; Constraint s; Find Minimum Necessary Flange Height; List of designs (1 for every material under consideration); LocalLoadCalculatorAndLugDesignerAndLugConfigurator.py; CheckBearing .py; Do for every material:; False; CheckPullThr ough.py; True; Z-coordinates holes X-coordinates holes T2 T3; CheckBearing.py AND CheckPullThrough.py; SelectFastener.p y; CheckThermalSt ress.py; False or First Time in this loop; t2, t3, coordinate s of holes; Accuracy Mode (default=lo w)

Lug Parameter Optimizer SciPy Minimize (SLSQP)

6.2. Optimization : Back-plate and fasteners | 19

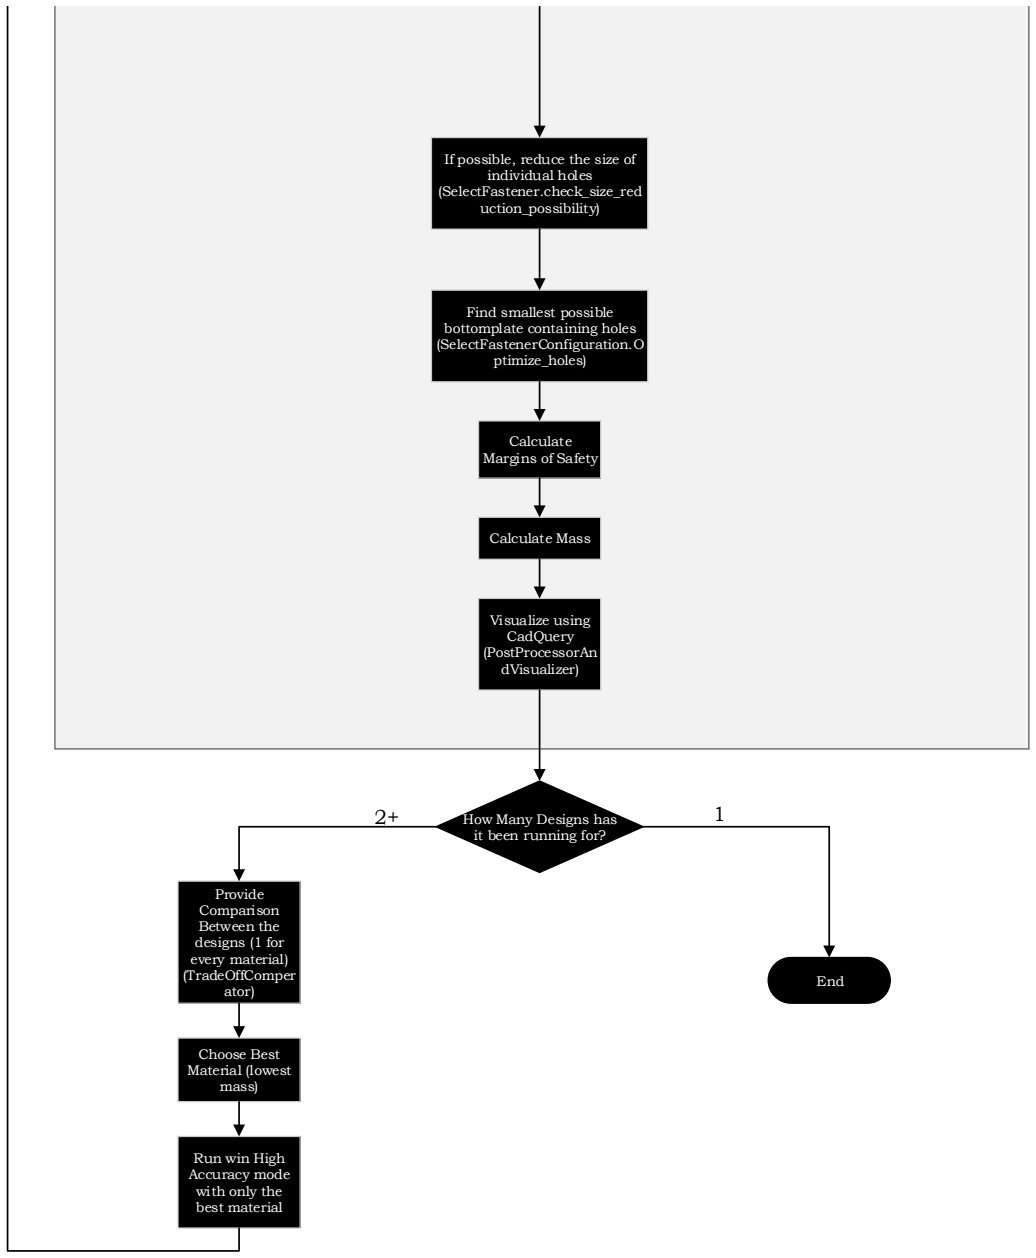
[picture p14: figure]
If possible, reduce the size of individual holes (SelectFastener.check_size_red uction_possibility); Find smallest possible bottomplate containing holes (SelectFastenerConfiguration.O ptimize_holes); Calculate Margins of Safety; Calculate Mass; Visualize using CadQuery (PostProcessorAn dVisualizer); Provide Comparison Between the designs (1 for every material) (TradeOffComper ator); Choose Best Material (lowest mass); Run win High Accuracy mode with only the best material; How Many Designs has it been running for?; End

### Figure 6.1: Flowchart of the MainOptimizer

7

# Material Selection

The material for the fastener and the lugs will be selected after a comparison between all the suitable

## materials found, in section 7.1

# 7.1. Material Selection: Fasteners

The list of materials suitable to be used in the fasteners is generated by an inspection process. Initially, the companies manufacturing aerospace-grade fasteners are sourced using the industrial sourcing platform Thomasnet.com (‘https://www.thomasnet.com/catalogs/keyword/aerospace-fasteners/‘). Then, the list of the materials that these companies use for producing fasteners is noted and a trade-off is conducted. This method is used because, essentially, an off-the-shelf fastener is decided to be used and these materials are restricting. An off-the-shelf fastener is decided to be used instead of going through a detailed design process of the fasteners. This decision is made due to time constraints and because there are many proven and documented fasteners with different configurations in the market that can be chosen. The selected materials for the fasteners are 18-8 Stainless Steel, 316 Stainless Steel, Yellow Brass, Grade 5 Titanium , and Aluminum 7075. The properties of the selected materials can be seen in table 7.1.

Table 7.1: Material options that can be used for the fasteners and their properties.

Material | Youngs Modulus (GPa) | Density (kg/m³) | Thermal Expansion Coefficient (10⁻⁶/K) | Ultimate Tensile Strength (MPa) | Elastic Limit (Mpa) | Resistance Factors
316 Stainless Steel[8] | 190-205 | 7870-8070 | 15-18 | 480-620 | 170-310 | Excellent
18-8 SS [9] | 193 | 7930 | 17.2-17.8 | 515-620 | 205-310 | Respectable but not for salty environments
Carbon Steel[10] | 200 | 7870 | 11.5 at 20 °C /12.2 at 250 °C | 540 | 415 | Excellent
Titanium (Grade 5) [11] | 113.8 | 4430 | 8.6 at 20 °C/ 9.2 at 250 °C | 950 | 880 | Excellent for corrosion but poor with wear
Brass (Yellow) [12] | 76 | 8470 | 21 in the 20-100 °C range | 260 | 90 | Good corrosion resistance
Aluminium 7075 [13] | 71.7 | 2810 | 25.2 in the 20-300 °C range | 572 | 503 | Moderate

Table 7.2: Trade-off table of the materials that can be used for the fasteners.

Material | Youngs Modulus | Density, (Weightage 2) | Thermal Expansion (Weightage 2) | Ultimate Tensile Strength | Elastic Limit | Resistance Factors | SCORE
316 Stainless Steel | 1 | 10 | 6 | 3 | 5 | 1 | 26
18-8 SS | 3 | 8 | 8 | 2 | 4 | 2 | 27
Carbon Steel | 2 | 6 | 4 | 5 | 3 | 1 | 21
Titanium (Grade 5) | 4 | 4 | 2 | 1 | 1 | 3 | 15
Brass (Yellow) | 5 | 12 | 10 | 6 | 6 | 3 | 42
Aluminium 7075 | 6 | 2 | 12 | 4 | 2 | 4 | 30

The trade-off is performed in table 7.2. In the trade-off a score from one to six is given to each material depending on how good are the material‘s properties with respect to the other materials‘ in that class. A score of 1 is the best score a material can get for a property and 6 is the worst. This means that ultimately, the material with the lowest score is going to be selected. Regarding density and the thermal expansion coefficient, a weightage of two is used after the scoring was done, and the final score for that category is shown in the table. A different weightage was used because weight and the thermal expansion coefficient are more critical aspects of the design due to the design objectives. Regarding the density, low density scores lower as lightweight structure is desired to reduce cost. High Young’s modulus scores lower as this will result in lower compliance in the parts. High elastic limit scores lower

20

7.2. Material Selection: Lug | 21

as high elastic limit means the material will deform elastically under a greater range of stresses. High ultimate tensile stress will score lower because higher the ultimate tensile stress higher the required stress for fracture. Therefore, even if the elastic limit is surpassed, the fastener will need to be subjected to greater stresses to fracture with a higher ultimate tensile stress. Lower thermal expansion coefficient scores lower. The operational temperature range is given in section 5.1 as -70 to 83°C. If the fasteners are assumed to be attached in standard temperature of 25 °C. The thermal stresses created will be higher with a high thermal expansion coefficient when the temperature of the fastener increases to 83°C. This is to be avoided so a material with a lower thermal expansion coefficient is desired.

For the resistance aspects; Stainless steel 316 and carbon steel have excellent corrosion and wear resistance; 18-8 SS has excellent wear resistance but corrodes in saline environments, but for space missions, the lug will not be in a saline environment except for possibly a very short period during the launch phase so it scores almost excellent. Brass has lower resistance to corrosion than titanium but better wear resistance. Titanium scores excellent with corrosion but poor with wear so it requires treatment to increase resistance to wear. In order to increase the wear resistance of titanium, the naturally occurring thin oxide layer of the metal will be enhanced by anodising in acid electrolyte[14]. This technique will be used as it is relatively cheap to apply, it is carried out at room temperature and so does not result in any distortion of the component being treated, and it does not have any adverse effect on the fatigue resistance of the titanium [14].

# 7.2. Material Selection: Lug

The selection of the material for the lug depends on the procedure described in chapter 3 and chapter 4. Here, the flanges and backplate were designed based on the limiting loads and resulted in a set of configurations for the different materials. Based on the mass of each configuration and the characteristics of the material extracted from Ansys Granta [15], the optimal material(s) can be selected through a trade-off analysis.

As specified during chapter 6, the optimizer aims to find a design that fits the requirements while minimizing mass. Table 7.3 contains the material properties and the total mass of the lug configuration calculated in low accuracy. As explained in previous chapters, using low accuracy restricts the optimizer and reduces the time required to obtain results.

Table 7.3: Properties of available materials for the lug design and resultant mass of chosen lug configuration.

Material | Mass [g] | Density [kg/m³] | Young’s Modulus [GPa] | Ultimate Tensile Strength [MPa] | Tensile Yield Strength [MPa] | Thermal Expansion Coefficient [10⁻⁶/K]
2014-T6 | 99.29 | 2800 | 73 | 483 | 414 | 24.4
7075-T6 | 96.17 | 2810 | 71.7 | 572 | 503 | 25.2
4130 Steel | 139.78 | 7850 | 200-215 | 670 | 435 | 13.7
8630 Steel | 165.72 | 7850 | 190-210 | 620 | 550 | 11.2
2024-T4 | 85.20 | 2780 | 73 | 469 | 324 | 24.7
2024-T3 | 91.33 | 2780 | 73.1 | 483 | 345 | 24.7
356-T6 Aluminium | 197.32 | 2670 | 72.4 | 234 | 165 | 23.2

From table 7.3, several designs are obtained. Taking into account the safety factors, it can be safely assumed that these meet the requirements. The trade-off shall be performed based primarily on the mass of the component, so only the aluminium alloys of series 2000 and 7000 will be assessed, since the remaining exhibit high masses. Table 7.4 displays the trade-off system that will be followed.

### Table 7.4: Trade-off system displaying average weights

Material | Mass [3] | Specific Stiffness [3] | Thermal Expansion Coefficient [1] | Fatigue Strength (10⁷ Cycles) [2] | Cost [1]
2014-T6 | 99.29 | 25.7-27.5 | 24.4 | 119-133 | 2.98-4
7075-T6 | 96.17 | 24.6-27.2 | 25.2 | 152-168 | 5.54-7.48
2024-T4 | 85.20 | 26-27.8 | 24.7 | 133-147 | 3.01-4.03
2024-T3 | 91.33 | 26-27.4 | 24.7 | 118-168 | 3.01-4.03

The average weights have been decided based on the importance of each of the parameters. The mass of the component and specific stiffness of the material, which equals the ratio of Young’s Modulus and

7.3. Final Design | 22

density, shall have an average weight of 3. Also, the lug is to withstand loads for the entirety of the mission duration and will be affected by fatigue due to thermal and mechanical stress, therefore the
fatigue strength after 10⁷ | cycles will be considered with an average weight of 2. Thermal expansion has
already been considered for the design and therefore poses the lowest priority for the trade-off. Table 7.5 contains the score system.

### Table 7.5: Trade-off table displaying the score

Material | Mass [3] | Specific Stiffness [3] | Thermal Expansion Coefficient [1] | Fatigue Strength (10^7 Cycles) [2] | Cost [1] Total
2014-T6 | 4 | 4 | 1 | 4 | 1 | 34
7075-T6 | 3 | 3 | 4 | 1 | 4 | 28
2024-T4 | 1 | 1 | 3 | 3 | 3 | 18
2024-T3 | 2 | 2 | 3 | 2 | 3 | 22

The trade-off table in table 7.5 displays the amount of points scored by each material for the different features. The scoring system works as in section 7.1, the material with the best performance for the given property scores the lowest, a one, while the one performing poorly scores a four. The total amount of points is calculated by summing up the amount of points multiplied by a factor representing the importance of the feature compared to the others. The material scoring the lowest is the aluminium alloy 2024-T4. Therefore, this material is selected to manufacture the lug.

# 7.3. Final Design

Having chosen the material for the lug, the mass and configuration can be recalculated in high accuracy mode, which produces more detailed parameters and mass. The parameters for the final configuration are shown in table 7.6.

7.3. Final Design | 23

### Table 7.6: Final Configuration

Material | 2024-T4
Mass [g] | 79.050
Number of Lug(s) | 2
Number of Flange(s) | 2
Number of Fasteners | 4
h [mm] | 10.000
t1 [mm] | 1.001
t2 [mm] | 1.050
t3 [mm] | 2.000
D1 [mm] | 5.000
w [mm] | 15.000
Flange Height [mm] | 22.500
Plate Length [mm] | 68.000
Plate Width [mm] | 191.000
Distance between lugs [mm] | 1400.000
Hole Coordinates [mm] | (4.443, 4.570)
(4.443, 186.430)
(63.557, 4.570)
(63.557, 186.430)

## D2 (holes) [mm]

1.300
1.700
2.200
1.300
Nut type | Hexagonal
Hole Type | Nut-Tightened
Material | Titanium (Grade 5)
Bolt Length [mm] | 8
Bolt Manufacturer | Extreme B&F
Bolt Type | M1.2
M1.6
M2
M1.2

### Figure 7.1: Final Design

The high-accuracy optimisation leads to a lightweight component that should withstand the loads. It is important to consider that some of the parameters look unreasonable. The distance between flanges or their width could be considered too low, which should be assessed in future iterations.

Despite having considered several safety factors, the design is based on yield. This means that the lug will not break during its lifetime, but it is very inclined to deform or bend as design parameters such as maximum deformation angles were not considered. To obtain an optimal design, it is recommended to subject the component to testing and further iterate the design if required. Including more design parameters into the constraints of the optimiser would improve the design.

8

# Post Processing and Visualization

When a new configuration was outputted by the optimization software, a 3D model of this configuration was generated by the CadQuery package. This package also exported the 3D model to stl, which could be opened in visualization software such as STL viewer. The necessity of this software was threefold:

- Firstly due to the large amount of parameters a visual representation of the lug was more useful than the value of the geometric parameters. This was especially useful in the debugging of the optimizer as a ”sanity” check for the lug’s calculated parameters.
- The software allows the calculation of the volume of the part which can then be used to calculate its mass very quickly, and nonsensical values for the mass also aided the debugging of the optimizer.
- The CadQuery package also exports the 3D model as a step file, which was imported into CATIA to make the technical drawings.

The CadQuery package provides a way to turn the parameters into a 3D model. CadQuery works a bit different than an normal parametric modelling CAD program, because all 3D modelling steps (such as extrude, make a hole, etc.) were done by code. The advantage of this is that this code can automatically use the parameters as outputted from the optimization process, and it would not be necessary to manually make a 3D model in a normal CAD program each time a new design is made. The code that generates the 3D model can be found in Listing A.10 in appendix A.

24

9

# Conclusion

This project aimed to determine the design for the attachment of the solar panels for the RODEO mission to the main spacecraft body. To understand the problem better the limiting load cases that the attachment should withstand were first analyzed in chapter 2. It was concluded that the loads experienced due to the launch phase of the mission were limiting and this load case would drive the design. Next in chapter 3, the configuration and the design of the lugs were selected through the optimization of the dimensions to withstand the loads whilst minimizing the mass. The next chapter focuses on the design of the fasteners and the dimensions of the back plate of the lug. Functions in Python were created to verify each of the individual constraints, ensuring a comprehensive assessment of the bearing stress, pull-through forces, and stress concentrations. An iterative process of updating an initial design based on the output of these functions is described in chapter 6. After this initial optimization, the thermal effects of the temperature changes experienced by RODEO were also added to the fastener checks. The same optimization was then performed again to identify the optimal material for the back plate and the fasteners. This eventually led to the final design described in section 7.2 that involved Titanium fasteners and bolts and an aluminum 2024-T4 lug.

Several steps that could be taken to improve the code. One of these is to use the Python package NUMBA, which would convert the slow Python code to a faster species of code. NUMBA also has the possibility to use CUDA technology, which would run the code on the GPU instead of the CPU, which would be faster for some kinds of calculations. This would not improve the speed of the code on our laptops, as our laptops are not compatible with CUDA, but it would massively reduce the time needed to run the code on a Microsoft Azure server or AWS EC2 server. Another way that the code could be improved would be to provide more data during the optimization process, rather then only after. This way you can diagnose problems, and stop the optimization process earlier to change things. An example of data that could be shared during the process could be margins of safety, which could be tracked over time.

Besides using packages to speed up running the code, the code itself could also be improved to make it more efficient. In the LocalLoadCalculatorAndLugDesignerAndLugConfigurator.py there are many for-loops that go through every possibility to find the best combination of variables. The range of possibilities it goes through can be reduced in size, because it also includes some combinations of variables that are obviously not optimal (very large lengths/widths, very small lengths/widths, etc.). Another way to make the code more efficient would be to use dynamic step sizes, that first optimizes the variables roughly (with large step sizes), and then the best combination of variables is used to run the optimizer again, with a finer step size. This way it would not be necessary to go through all possibilities with the fine step size, and would speed up the code.

25

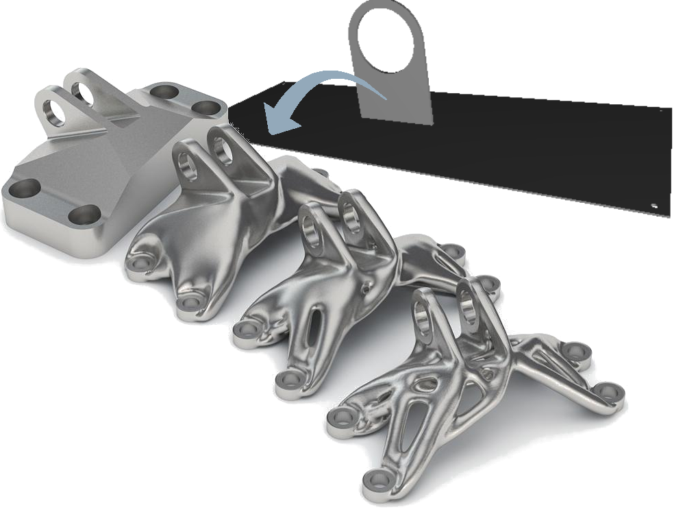
[picture p15: figure]

### Figure 9.1: Topology Optimization

One whole other way to do the optimization would be to use the technology Topology Optimization. This technology strategically adds and removes material in certain places, as to reduce the mass as much as possible, given the loads. The results from Topology Optimization look very different than what is normally designed by engineers: the designs are very organic. This can be seen in figure 9.1.

# References

[1] Kassapoglou, C., “AE2111-I Aerospace System Design Spacecraft WP4: A solar array or an RTG attachment”, Delft University of Technology, Faculty of Aerospace Engineering, 2023.
[2] European Cooperation for Space Standardization, “ECSS-E-ST-32-10C Rev.2 Corr.1 – Structural factors of safety for spaceflight hardware”, European Cooperation for Space Standardization, 2019.

### https://ecss.nl/standard/ecss-e-st-32-10c-rev-2-corr-1-structural-fac

tors-of-safety-for-spaceflight-hardware-1-august-2019/. (https://ecss.nl/standard/ecss-e-st-32-10c-rev-2-corr-1-structural-factors-of-safety-for-spaceflight-hardware-1-august-2019/)

[3] “Analysis and Design of Flight Vehicle Structures by E F Bruhn PDF | PDF”,

### https://www.scribd.com/doc/220947115/Analysis-and-Design-of-Flight-Veh

icle-Structures-by-E-F-Bruhn-pdf. (https://www.scribd.com/doc/220947115/Analysis-and-Design-of-Flight-Vehicle-Structures-by-E-F-Bruhn-pdf)

[4] “Hex Bolt Dimensions”, Corp., B. S. . B.
https://www.badensteel.com/bolt-dimensions.
[5] ECSS-E-HB-32-23A: Threaded fasteners handbook (16 April 2010), .
https://ecss.nl/hbstms/ecss-e-hb-32-23a-threaded-fasteners-handbook/.
[6] Akay, I., and Vanhamel, J., “AE2111-I Aerospace System Design Spacecraft WP1-3”, Delft University of Technology, Faculty of Aerospace Engineering, 2023.
[7] Ashby, M. F., and Jones, D. R. H., Materials: Engineering, Science, Processing, and Design, Butterworth-Heinemann, 2019.
[8] “Stainless Steel - Grade 316 (UNS S31600)”, Azomaterials.
https://www.azom.com/article.aspx?ArticleID=863.
[9] “18/8 Stainless Steel, Grade 18-8 SS Properties & Meaning”,
18/8StainlessSteel,Grade18-8SSProperties&Meaning.
[10] “Carbon Steel Mechanical Properties”, Ezlokltd.
https://www.ezlok.com/carbon-steel-properties.
[11] Boyer, R., Welsch, G., and Collings, E. W., Materials Properties Handbook: Titanium Alloys, ASM International, 1994.
[12] “Yellow Brass (UNS C26800)”, Azonetwork.
https://www.azom.com/article.aspx?ArticleID=6360.
[13] ASMInternational, Metals Handbook, Vol.2 - Properties and Selection: Nonferrous Alloys and Special-Purpose Materials, 10th ed., 1990.
https://asm.matweb.com/search/SpecificMaterial.asp?bassnum=ma7075t6.
[14] “Titanium Alloys - Wear Resistance”, Azomaterials.
https://www.azom.com/article.aspx?ArticleID=1219.
[15] “Ansys Granta EduPack software”, ANSYS, Inc., www.ansys.com/materials.

27

# Appendices

28

A

# Code

The code used in the project is listed below in multiple code blocks. To run the code, execute MainOptimzer.py after installing all the packages in Requirements.txt. The code can also be cloned from the GitHub Repo ”HuiLucas/LugDesign” ¹. If you just want to run the code without an IDE, you can pull the Docker Repo ”lhuirne/lug_design3” ².

1 | from InputVariables import materials_fasteners
2 | class DesignInstance:
3 | def __init__(self, h, t1, t2, t3, D1, w, material, n_fast, length, offset, flange_height,
| hole_coordinate_list, \
4 | D2_list, yieldstrength, N_lugs, N_Flanges, Dist_between_lugs=0,
| bottomplatewidth=100, shearstrength=550):
5 | self.h = h
6 | self.t1 = t1
7 | self.t2 = t2
8 | self.t3 = t3
9 | self.D1 = D1
10 | #self.l = l #length of backplate
11 | self.w = w
12 | self.material = material
13 | self.n_fast = n_fast
14 | self.length = length
15 | self.offset = offset
16 | self.flange_height = flange_height
17 | self.hole_coordinate_list = hole_coordinate_list
18 | self.n_fast = len(hole_coordinate_list)
19 | self.D2_list=D2_list
20 | self.yieldstrength=yieldstrength
21 | self.N_lugs = N_lugs
22 | self.N_Flanges = N_Flanges
23 | self.Dist_between_lugs = Dist_between_lugs
24 | self.bottomplatewidth = bottomplatewidth
25 | self.shearstrength = shearstrength
26 | self.MS = None
27 | class Load:
28 | def __init__(self, F_x, F_y, F_z, M_x, M_y, M_z):
29 | self.F_x = F_x
30 | self.F_y = F_y
31 | self.F_z = F_z
32 | self.M_x = M_x
33 | self.M_y = M_y
34 | self.M_z = M_z

35
36 Launch_loads = Load(346.9,346.9,1040.7,653.9,653.9,0)

37
38 # Your main file

39
40 | # Nut type can either be ”Hexagonal” , ”Cylindrical” and hole type can either be ”Nut-
| Tightened” or ”Threaded hole”

41
42 | class FastenerType:
43 | def __init__(self, material_name, nut_type=None, hole_type=None):
44 | self.material = None
45 | self.youngs_modulus = None
46 | self.thermal_coeff = None
47 | self.yield_stress = None
| ¹https://github.com/HuiLucas/LugDesign.git
| ²https://hub.docker.com/repository/docker/lhuirne/lug_design3/general

29

48 | self.nut_type = nut_type
49 | self.hole_type = hole_type
50 | self.type_bolt = ”unknown”

51
52 | if nut_type not in [”Hexagonal”, ”Cylindrical”]:
53 | print(”Nut type can either be 'Hexagonal' or 'Cylindrical'”)
54 | else:
55 | self.nut_type = nut_type

56
57 | if hole_type not in [”Nut-Tightened”, ”Threaded hole”]:
58 | print(”Hole type can either be 'Nut-Tightened' or 'Threaded hole'”)
59 | else:
60 | self.hole_type = hole_type

61
62 | if material_name:
63 | self.set_material(material_name)

64
65 | def set_material(self, material_name):
66 | for material in materials_fasteners:
67 | if material[”Material”] == material_name:
68 | self.material = material_name
69 | self.youngs_modulus = material[”Youngs Modulus (GPa)”]
70 | self.thermal_coeff = material[”Thermal Expansion (10^-6)/K”]
71 | self.yield_stress = material[”Ultimate Tensile Strength (MPa)”]
72 | return
73 | print(”Material is not in InputVariables/materials_fastener”)

### Listing A.1: DesignClass.py code

1 # This File is going to contain the input variables for the whole program, like material properties of the material
2 | # under consideration.
3 | #hello

4
5 Material = ['2014-T6(DF-L)', '2014-T6(DF-LT)', '2014-T6(P)', '7075-T6(P)', '7075-T6(DF-L)', ' 7075-T6(DF-LT)',
6 | '4130 Steel', '8630 Steel', '2024-T4', '356-T6 Aluminium', '2024-T3']
7 | sigma_yield = [414, 414, 414, 503, 503, 503, 435, 550, 324, 165, 345]
8 | shear_strength = [290, 290, 290, 331, 331,331, 345, 345, 283, 143, 283] #MPa
9 | Density = [2800, 2800, 2800, 2810, 2810, 2810, 7850, 7850, 2780, 2670, 2780]

10
11 | materials_fasteners = [
12 | {”Material”: ”316 Stainless Steel”, ”Youngs Modulus (GPa)”: 190, ”Density (kg/m^3)”:
8070,
13 | ”Thermal Expansion (10^-6)/K”: 18, ”Ultimate Tensile Strength (MPa)”: 620,
14 | ”Elastic Limit(Mpa)”: 170, ”Resistance Factors”: ”Excellent”},

15
16 | {”Material”: ”18-8 SS”, ”Youngs Modulus (GPa)”: 193, ”Density (kg/m^3)”: 7930,
17 | ”Thermal Expansion (10^-6)/K”: 17.8, ”Ultimate Tensile Strength (MPa)”: | 620,
18 | ”Elastic Limit(Mpa)”: | 310, ”Resistance Factors”: ”Respectable but not for salty
environments”},

19
20 | {”Material”: ”Carbon Steel”, ”Youngs Modulus (GPa)”: 200, ”Density (kg/m^3)”: 7870,
21 | ”Thermal Expansion (10^-6)/K”: 11.5, ”Ultimate Tensile Strength (MPa)”: 540, ”Elastic
Limit(Mpa)”: 415,
22 | ”Resistance Factors”: ”Excellent”},

23
24 | {”Material”: ”Titanium (Grade 5)”, ”Youngs Modulus (GPa)”: 113.8, ”Density (kg/m^3)”:
4430,
25 | ”Thermal Expansion (10^-6)/K”: 8.6, ”Ultimate Tensile Strength (MPa)”: 950, ”Elastic
Limit(Mpa)”: 880,
26 | ”Resistance Factors”: ”Excellent for corrosion but poor with wear”},

27
28 | {”Material”: ”Brass (Yellow)”, ”Youngs Modulus (GPa)”: 76, ”Density (kg/m^3)”: 8740,
29 | ”Thermal Expansion (10^-6)/K”: 21, ”Ultimate Tensile Strength (MPa)”: 260, ”Elastic
Limit(Mpa)”: 90,
30 | ”Resistance Factors”: ”Good corrosion resistance”},

31
32 | {”Material”: ”Aluminium 7075”, ”Youngs Modulus (GPa)”: 71.7, ”Density (kg/m^3)”: 2810,
33 | ”Thermal Expansion (10^-6)/K”: 25.2, ”Ultimate Tensile Strength (MPa)”: 572, ”Elastic
Limit(Mpa)”: 503,

34 | ”Resistance Factors”: ”Moderate”}
35 | ]

36
37 | materials_lug = [
38 | {'material': '2014-T6(DF-L)', 'thermal_expansion_coefficient': 23 ,'elastic module': 73.1
| },
39 | {'material': '2014-T6(DF-LT)', 'thermal_expansion_coefficient': 23,'elastic module':
| 73.1},
40 | {'material': '2014-T6(P)', 'thermal_expansion_coefficient': 23,'elastic module': 73.1},
41 | {'material': '7075-T6(P)', 'thermal_expansion_coefficient': 23.4,'elastic module': 71.7},
42 | {'material': '7075-T6(DF-L)', 'thermal_expansion_coefficient': 23.4,'elastic module':
| 71.7},
43 | {'material': '7075-T6(DF-LT)', 'thermal_expansion_coefficient': 23.4,'elastic module':
| 71.7},
44 | {'material': '4130 Steel', 'thermal_expansion_coefficient': 11.1,'elastic module': 205},
45 | {'material': '8630 Steel', 'thermal_expansion_coefficient': 11.3,'elastic module': 200},
46 | {'material': '2024-T4', 'thermal_expansion_coefficient': 23.2,'elastic module': 73.1},
47 | {'material': '356-T6 Aluminium', 'thermal_expansion_coefficient': 23.8,'elastic module':
| 72.4},
48 | {'material': '2024-T3', 'thermal_expansion_coefficient': 21.6,'elastic module': 73.1}
49 | ]

### Listing A.2: InputVariables.py code

1 # This file will change the design based on the part checks. It will start from an initial design, then perform all
2 # the checks as written in the other software components, and improve the design if possible with iterations.
3 import copy

4
5 | import CheckBearing, CheckThermalStress, CheckPullThrough, GlobalLoadsCalculator,
| InputVariables, \
6 | PostProcessorAndVisualizer, SelectFastener, TradeOffComperator, \
7 | DesignClass, LocalLoadCalculatorAndLugDesignerAndLugConfigurator
8 | import numpy as np
9 | import SelectFastenerConfiguration

10
11 | # !!!!!!!!!!!! TBD:
12 | # Done !!!!!!!!!!!! For CheckPullThrough: shearstrength is now set for one material, but
needs to be done for other materials as well
13 # Done !!!!!!!!!!!! optimize/calculate dist_between_lugs (is now set at the beginning, and never changed). Maybe set equal to upper limit of what fits on the satellite?
14 # Done !!!!!!!!!!!! Optimize (?) D2_holes. Is now set at the beginning, and does not change troughout the process. However, it was
15 # chosen to change the thickness t2 instead of the diameters of the holes, but maybe it is still possible to do both? I was thinking, maybe we could make a function that looks whether it is possible to reduce the size of a given hole (in
16 | # discrete steps that correspond to | bolt diameters), given an existing design. Then this
function could be applied all the way at the end
17 # to reduce the size of the the holes that are not limiting. Such a function would need to find out if the design with a smaller reduced hole
18 # would still pass the Bearing Check (incl. updated fastener design & thermal loads) and Pull Through Check, and if that is the case, then the size of that hole would actually be
| decreased.
19 | # !!!!!!!!!!!! Check EVERYTHING, make sure no mistakes in calculations. Look for mistakes in
the code. Confirm results by performing checks on the resulting designs by hand.
20 | # !!!!!!!!!!!! Run with high_accuracy = True (once) to find out if there's strange behaviour
21 | # !!!!!!!!!!!! Finish comparison between materials (WP4.13)
22 | # Done !!!!!!!!!!!! Set constraint that h >= 0 if N_lugs == 2
23 | # Done !!!!!!!!!!!! Provide list of Margins of Safety, as in WP4.11

24

25
26 #
27 | # Do not change:
28 | initial_design = DesignClass.DesignInstance(h=30, t1=5, t2=0.05, t3=2, D1=10, w=80, material=
| ”metal”, n_fast=4, \
29 | | length=10, offset=20,flange_height=80, \
30 | | hole_coordinate_list=[(3, 35), (3, 65), (7, 35),
| (7, 65)], \

31 | D2_list=[2.2, 2.2, 2.2, 2.2], yieldstrength=83,
| N_lugs=2,N_Flanges=2, bottomplatewidth=100)
32 | if initial_design.N_lugs ==1:
33 | initial_design.D2_list = [2.2,2.2,2.2,2.2]
34 | #

35
36 | if initial_design.N_Flanges ==2:
37 | initial_design.offset = (initial_design.length - initial_design.t1 - initial_design.h)/2
38 | else:
39 | initial_design.offset = (initial_design.length - initial_design.t1)/2
40 | loads_with_SF = DesignClass.Load(433.6,433.6,1300.81,817.34,817.34,0)

41
42 | fastener_array =[]
43 | design_array2 = []
44 | design_array = LocalLoadCalculatorAndLugDesignerAndLugConfigurator.Optimize_Lug(
| InputVariables.Material, \
45 | InputVariables.sigma_yield,
| InputVariables.Density,\
46 | initial_design,
| loads_with_SF, False)

47
48 | for designindex in range(len(design_array)):
49 | out1 = copy.deepcopy(design_array[designindex])
50 | print(out1.h, out1.t1, out1.t2, out1.t3, out1.D1, out1.w, out1.length, out1.offset, out1.
| flange_height, out1.yieldstrength, out1.material, out1.Dist_between_lugs, out1.N_lugs)

51

52
53 | #check1 = checkbearing without thermal loads, follow advice from result

54
55 | check1 = False
56 | if not CheckBearing.check_bearing_stress(out1, loads_with_SF, [0, 0, 0,
57 | 0]) == ”Bearing Stress
| Check Failed, increase the thickness of the backplate ”:
58 | check1 = True
59 | counter1 = 0
60 | print(check1, counter1, out1.t2)
61 | while check1 == False and counter1 < 1000:
62 | out1.t2 += 0.05
63 | if not CheckBearing.check_bearing_stress(out1, loads_with_SF,[0,0,0,0]) == ”Bearing
| Stress Check Failed, increase the thickness of the backplate ”:
64 | check1=True
65 | counter1 +=1
66 | print(check1, counter1, out1.t2)
67 | #check2 = checkpullthrough, follow advice from result

68
69 | check2 = False
70 | counter2 = 0
71 | print(check2, counter2, out1.t2)
72 | if CheckPullThrough.check_pullthrough(out1, loads_with_SF)[0] == True:
73 | check2 = True
74 | print(check2, counter2, out1.t2)
75 | print(”here2”, out1.hole_coordinate_list)
76 | while check2 == False and counter2 < 1000:
77 | #print(out1.hole_coordinate_list)
78 | print(CheckPullThrough.check_pullthrough(out1, loads_with_SF)[1])
79 | if CheckPullThrough.check_pullthrough(out1, loads_with_SF)[1] == ”decrease z”:
80 | for ix in range(len(out1.hole_coordinate_list)):
81 | out1.hole_coordinate_list[ix] = (
82 | out1.hole_coordinate_list[ix][0],
83 | 0.5 * out1.bottomplatewidth + (out1.hole_coordinate_list[ix][1] - 0.5 *
| out1.bottomplatewidth) * 0.98)
84 | elif CheckPullThrough.check_pullthrough(out1, loads_with_SF)[1] == ”increase z”:
85 | for ix in range(len(out1.hole_coordinate_list)):
86 | out1.hole_coordinate_list[ix] = (
87 | out1.hole_coordinate_list[ix][0],
88 | 0.5 * out1.bottomplatewidth + (out1.hole_coordinate_list[ix][1] - 0.5 *
| out1.bottomplatewidth) * 1.02)
89 | elif CheckPullThrough.check_pullthrough(out1, loads_with_SF)[1] == ”increase x”:
90 | for ix in range(len(out1.hole_coordinate_list)):

91 | out1.hole_coordinate_list[ix] = (
92 | 0.5 * out1.length + (out1.hole_coordinate_list[ix][0] - 0.5 * out1.length
| ) * 1.02,
93 | out1.hole_coordinate_list[ix][1])
94 | elif CheckPullThrough.check_pullthrough(out1, loads_with_SF)[1] == ”decrease x”:
95 | for ix in range(len(out1.hole_coordinate_list)):
96 | out1.hole_coordinate_list[ix] = (
97 | 0.5 * out1.length + (out1.hole_coordinate_list[ix][0] - 0.5 * out1.length
| ) * 0.98,
98 | out1.hole_coordinate_list[ix][1])
99 | elif CheckPullThrough.check_pullthrough(out1, loads_with_SF)[1] == ”increase t2”:
100 | out1.t2 += 0.05
101 | elif CheckPullThrough.check_pullthrough(out1, loads_with_SF)[1] == ”increase t3”:
102 | out1.t3 += 0.1
103 | else:
104 | check2 = True

105
106 | counter2 += 1
107 | print(check2, counter2, out1.t2)

108

109

110

111
112 | checklist = [False, False]

113
114 | # checklist = [check1, check2]
115 | counter3 = 0
116 | firsttime = True
117 | while not checklist == [True, True] and counter3<100:
118 | out1.fasteners = DesignClass.FastenerType(”Titanium (Grade 5)”,”Hexagonal”,”Nut-
| Tightened”)
119 | philist = SelectFastener.calculate_force_ratio(out1.fasteners, out1,out1.material,”
| 7075-T6(DF-LT)”)[0]
120 | thermal_loads = CheckThermalStress.thermal_stress_calculation(out1, 150, -90, 15,
| philist
121 | ,material_fastener=out1
| .fasteners.material,
122 | material_plate=out1.
| material)[0]
123 | check1 = False
124 | if not CheckBearing.check_bearing_stress(out1, loads_with_SF, thermal_loads) == ”
| Bearing Stress Check Failed, increase the thickness of the backplate ”:
125 | check1 = True
126 | counter1 = 0
127 | counter4 = 0
128 | print(check1, counter1, out1.t2)
129 | while check1 == False and counter1 < 1000:
130 | if firsttime == False:
131 | out1.t2 += 0.05
132 | print(”please work”,out1.t2)
133 | counter4 +=1
134 | if not CheckBearing.check_bearing_stress(out1, loads_with_SF, thermal_loads) == ”
| Bearing Stress Check Failed, increase the thickness of the backplate ”:
135 | check1 = True
136 | counter1 += 1
137 | print(check1, counter1, out1.t2)
138 | print(”here”, out1.hole_coordinate_list)

139
140 | firsttime=False
141 | # check2 = checkpullthrough, follow advice from result
142 | check2 = False
143 | counter2 = 0
144 | counter5 = 0
145 | print(”point1”,check2, counter2, out1.t2, out1.hole_coordinate_list)
146 | if CheckPullThrough.check_pullthrough(out1, loads_with_SF)[0] == True:
147 | check2 = True
148 | print(”point2”,check2, counter2, out1.t2, out1.hole_coordinate_list)
149 | while check2 == False and counter2 < 1000:
150 | if CheckPullThrough.check_pullthrough(out1, loads_with_SF)[1] == ”decrease z”:
151 | counter5 +=1
152 | for ix in range(len(out1.hole_coordinate_list)):

153 | out1.hole_coordinate_list[ix] = (
154 | out1.hole_coordinate_list[ix][0], 0.5*out1.bottomplatewidth+(out1.
hole_coordinate_list[ix][1] -0.5*out1.bottomplatewidth)* 0.98)
155 | elif CheckPullThrough.check_pullthrough(out1, loads_with_SF)[1] == ”increase z”:
156 | counter5 +=1
157 | for ix in range(len(out1.hole_coordinate_list)):
158 | out1.hole_coordinate_list[ix] = (
159 | out1.hole_coordinate_list[ix][0],0.5*out1.bottomplatewidth+(out1.
hole_coordinate_list[ix][1] -0.5*out1.bottomplatewidth)* 1.02)
160 | elif CheckPullThrough.check_pullthrough(out1, loads_with_SF)[1] == ”increase x”:
161 | counter5 += 1
162 | for ix in range(len(out1.hole_coordinate_list)):
163 | out1.hole_coordinate_list[ix] = (
164 | 0.5*out1.length + (out1.hole_coordinate_list[ix][0]-0.5*out1.length) *
| 1.02, out1.hole_coordinate_list[ix][1])
165 | elif CheckPullThrough.check_pullthrough(out1, loads_with_SF)[1] == ”decrease x”:
166 | counter5 += 1
167 | for ix in range(len(out1.hole_coordinate_list)):
168 | out1.hole_coordinate_list[ix] = (
169 | 0.5*out1.length + (out1.hole_coordinate_list[ix][0]-0.5*out1.length) *
| 0.98, out1.hole_coordinate_list[ix][1])
170 | elif CheckPullThrough.check_pullthrough(out1, loads_with_SF)[1] == ”increase t2”:
171 | counter5 += 1
172 | out1.t2 += 0.05
173 | elif CheckPullThrough.check_pullthrough(out1, loads_with_SF)[1] == ”increase t3”:
174 | counter5 += 1
175 | out1.t3 += 0.1
176 | else:
177 | check2 = True

178
179 | counter2 += 1
180 | print(check2, counter2, out1.t2)
181 | checklist = [check1, check2]
182 | counter3 += 1
183 | print(”counters”, counter1, counter2,counter3, | counter4, counter5)

184

185

186
187 | print(out1.h, out1.t1, out1.t2, out1.t3, out1.D1, out1.w, out1.length, out1.offset, out1.
flange_height, out1.yieldstrength, out1.material, out1.Dist_between_lugs, out1.N_lugs,
| out1.bottomplatewidth)
188 | print(out1.hole_coordinate_list)
189 | #PostProcessorAndVisualizer.Visualize2(out1)
190 | if out1.h > out1.length and out1.N_Flanges == 2:
191 | changex = out1.h - out1.length
192 | out1.length = out1.h
193 | for j in range(len(out1.hole_coordinate_list)):
194 | deltaX = changex*0.5
195 | out1.hole_coordinate_list[j] = (out1.hole_coordinate_list[j][0] + deltaX, out1.
| hole_coordinate_list[j][1])
196 | changez = out1.bottomplatewidth - out1.w
197 | out1.bottomplatewidth = out1.w
198 | for j in range(len(out1.hole_coordinate_list)):
199 | deltaZ = changez*0.5
200 | out1.hole_coordinate_list[j] = (out1.hole_coordinate_list[j][0], out1.
| hole_coordinate_list[j][1]-deltaZ)
201 | #PostProcessorAndVisualizer.Visualize2(out1)
202 | print(out1.h, out1.t1, out1.t2, out1.t3, out1.D1, out1.w, out1.length, out1.offset, out1.
flange_height, out1.yieldstrength, out1.material, out1.Dist_between_lugs, out1.N_lugs,
| out1.bottomplatewidth)
203 | print(”this”, out1.hole_coordinate_list)

204
205 | for m in range(len(out1.D2_list)):
206 | SelectFastener.check_size_reduction_possibility(out1,m,loads_with_SF)
207 | print(”why is this:”, CheckPullThrough.check_pullthrough(out1,loads_with_SF))

208
209 | out1 = SelectFastenerConfiguration.Optimize_holes(out1, False)

210
211 | MS_lug_Appendix_A = LocalLoadCalculatorAndLugDesignerAndLugConfigurator.M_S
212 | MS_lug_breaking_flange = 0
213 | MS_backupwallbearing = ”allowable stress is unknown because different method is used”

214 | MS_backupwallbearinginclthermal = ”allowable stress is unknown because different method
| is used”
215 | MS_backupwallpullthrough = ”allowable stress is unknown because different method is used”
216 | MS_VehicleWallBearinginclThermal = ”allowable stress is unknown because different method
| is used”
217 | MS_VehicleWallPullthrough = ”allowable stress is unknown because different method is used
| ”

218
219 | out1.MS =[]
220 | out1.MS.append(MS_lug_Appendix_A)
221 | out1.MS.append(MS_lug_breaking_flange)
222 | out1.MS.append(MS_backupwallbearing)
223 | out1.MS.append(MS_backupwallbearinginclthermal)
224 | out1.MS.append(MS_backupwallpullthrough)
225 | out1.MS.append(MS_VehicleWallBearinginclThermal)
226 | out1.MS.append(MS_VehicleWallPullthrough)

227
228 | #PostProcessorAndVisualizer.Visualize(initial_design)
229 | print(out1.hole_coordinate_list)
230 | #PostProcessorAndVisualizer.Visualize2(out1, designindex)

231
232 | print(out1.h, out1.t1, out1.t2, out1.t3, out1.D1, out1.w, out1.length, out1.offset, out1.
| flange_height, out1.yieldstrength, out1.material, out1.Dist_between_lugs, out1.N_lugs)
233 | out1.checklist = checklist
234 | print(checklist)
235 | design_array2.append(out1)
236 | print(designindex)
237 | print(out1.hole_coordinate_list)

238

239
240 | for designindex in range(len(design_array2)):
241 | design_array2[designindex].volume = 0
242 | PostProcessorAndVisualizer.Visualize2(design_array2[designindex], designindex)
243 | # print(design_array2[designindex].material)
244 | # print(InputVariables.Material.index(design_array2[designindex].material))
245 | # print(InputVariables.Density[InputVariables.Material.index(design_array2[designindex].
| material)], design_array2[designindex].volume)
246 | # print(InputVariables.Density[InputVariables.Material.index(design_array2[designindex].
| material)]*design_array2[designindex].volume)
247 | design_array2[designindex].mass = InputVariables.Density[InputVariables.Material.index(
| design_array2[designindex].material)]*design_array2[designindex].volume
248 | # trade-off stuff
249 | TradeOffComperator.TradeOff(design_array2)

### Listing A.3: MainOptimizer.py code

1
2 | # This software component will calculate the local loads on a parametric model of the lug
| based on the given global
3 | # loads, and then choose values for the variables of the lug such that the lug can sustain
| these loads (see WP4.3).
4 | # This Software Component will also decide between a 1-lug or 2-lug configuration.

5
6 | import numpy as np
7 | from scipy.optimize import minimize
8 | import math
9 | import DesignClass
10 | import InputVariables
11 | from numba import jit

12
13 | debug_design3 = DesignClass.DesignInstance(h=30, t1=5, t2=10, t3=2, D1=10, w=80, material=”
| metal”, n_fast=4, \
14 | length=200, offset=20,flange_height=80, \
15 | hole_coordinate_list=[(20, 10), (180, 30), (160,
| 20), (30, 30)], \
16 | D2_list=[10, 5, 9, 8], yieldstrength=83,N_lugs=1,
| N_Flanges=2)

17
18 | debug_loads = DesignClass.Load(433.6,433.6,1300.81,817.34,817.34,0)
19 | @jit(nopython=True)
20 | def calculate_ci(i, x):

21 | if i ==1:
22 | return 0.8534 + 0.2891 * x - 0.1511 * x ** 2 - 0.0035 * x ** 3 + 0.0174 * x ** 4 -
| 0.0038 * x ** 5 + 0.0002 * x ** 6
23 | elif i==2:
24 | return 1.5030 - 1.5054 * x + 1.7453 * x ** 2 - 0.9890 * x ** 3 + 0.2838 * x ** 4 -
| 0.0390 * x ** 5 + 0.0020 * x ** 6
25 | elif i ==3:
26 | return 0.6270 + 0.9428 * x - 0.8837 * x ** 2 + 0.3900 * x ** 3 - 0.0928 * x ** 4 +
| 0.0115 * x ** 5 - 0.0005 * x ** 6
27 | elif i ==4:
28 | return 0.9083 + 0.3195 * x - 0.2985 * x ** 2 + 0.0912 * x ** 3 - 0.0121 * x ** 4 +
| 0.0006 * x ** 5
29 | elif i==5:
30 | return 0.6115 + 1.4003 * x - 1.6563 * x ** 2 + 0.8517 * x ** 3 - 0.2273 * x ** 4 +
| 0.0306 * x ** 5 - 0.0016 * x ** 6
31 | elif i==6:
32 | return 0.7625 + 1.1900 * x - 1.5365 * x ** 2 + 0.7699 * x ** 3 - 0.1987 * x ** 4 +
| 0.0258 * x ** 5 - 0.0013 * x ** 6
33 | elif i ==7:
34 | return 1.0065 - 0.7188 * x + 0.6110 * x ** 2 - 0.3044 * x ** 3 + 0.0813 * x ** 4 -
| 0.0109 * x ** 5 + 0.0006 * x ** 6
35 | else:
36 | return 0

37
38 | # Material Functions Lists (Kt)
39 | def calculate_kt(e, D, M, t, Material_In):
40 | W = 2 * e
41 | x = W / D
42 | Mat = M
43 | #c1 = 0.8534 + 0.2891 * x - 0.1511 * x ** 2 - 0.0035 * x ** 3 + 0.0174 * x ** 4 - 0.0038
| * x ** 5 + 0.0002 * x ** 6
44 | #c2 = 1.5030 - 1.5054 * x + 1.7453 * x ** 2 - 0.9890 * x ** 3 + 0.2838 * x ** 4 - 0.0390
| * x ** 5 + 0.0020 * x ** 6
45 | #c3 = 0.6270 + 0.9428 * x - 0.8837 * x ** 2 + 0.3900 * x ** 3 - 0.0928 * x ** 4 + 0.0115
| * x ** 5 - 0.0005 * x ** 6
46 | #c4 = 0.9083 + 0.3195 * x - 0.2985 * x ** 2 + 0.0912 * x ** 3 - 0.0121 * x ** 4 + 0.0006
| * x ** 5
47 | #c5 = 0.6115 + 1.4003 * x - 1.6563 * x ** 2 + 0.8517 * x ** 3 - 0.2273 * x ** 4 + 0.0306
| * x ** 5 - 0.0016 * x ** 6
48 | #c6 = 0.7625 + 1.1900 * x - 1.5365 * x ** 2 + 0.7699 * x ** 3 - 0.1987 * x ** 4 + 0.0258
| * x ** 5 - 0.0013 * x ** 6
49 | #c7 = 1.0065 - 0.7188 * x + 0.6110 * x ** 2 - 0.3044 * x ** 3 + 0.0813 * x ** 4 - 0.0109
| * x ** 5 + 0.0006 * x ** 6

50
51 | if Mat == Material_In[0] or Mat == Material_In[4] or Mat == Material_In[6] or Mat ==
| Material_In[7]:
52 | kt = calculate_ci(1,x)
53 | elif (Mat == Material_In[2] or Mat == Material_In[3]) and t <= 1.27:
54 | kt = calculate_ci(2,x)
55 | elif Mat == Material_In[1] or Mat == Material_In[5]:
56 | kt = calculate_ci(2,x)
57 | elif (Mat == Material_In[2] or Mat == Material_In[3]) and t >= 1.27:
58 | kt = calculate_ci(4,x)
59 | elif Mat == Material_In[8] or Mat == Material_In[10]:
60 | kt = calculate_ci(4,x)
61 | elif Mat == Material_In[9]:
62 | kt = calculate_ci(7,x)
63 | else:
64 | kt = 0
65 | pass
66 | return kt

67
68 | @jit(nopython=True)
69 | def calculate_kty(w, D, t):
70 | x = (6 / ((4 / (0.5 * (w - D) + D / (2 * 2 ** 0.5))*t) + 2 / (0.5 * (w - D))*t)) / (D * t
| )
71 | curve = -0.0074 + 1.384 * x - 0.5613 * x ** 2 + 1.46159 * x ** 3 - 2.6979 * x ** 4 +
| 1.912 * x ** 5 - 0.4626 * x ** 6
72 | return curve

73
74 @jit(nopython=True)

75 | def calculate_vol(t, e, D):
76 | volume = math.pi * (e** 2 - (D / 2) ** 2) * t
77 | return volume

78
79 | @jit(nopython=True)
80 | def calculate_tension_area(t, e, D):
81 | W = 2 * e
82 | A_t = t * (W - D)
83 | return A_t

84
85 | @jit(nopython=True)
86 | def calculate_bearing_area(t, D):
87 | A_br = D * t
88 | return A_br

89
90 | @jit(nopython=True)
91 | def choose_kby(t, D, e):
92 | x = e / D
93 | if t / D > 0.4:
94 | kby = -1.4512 + 4.006 * x - 2.4375 * (x ** 2) + 1.04689 * (x ** 3) - 0.3279 * (x **
4) + 0.0612 * (
95 | x ** 5) - 0.0047 * (x ** 6)
96 | if 0.3 < t / D <= 0.4:
97 | kby = -1.4512 + 4.006 * x - 2.4375 * (x ** 2) + 1.04689 * (x ** 3) - 0.32799 * (x **
4) + 0.0612 * (
98 | x ** 5) - 0.0047 * (x ** 6)
99 | if 0.2 < t / D <= 0.3:
100 | kby = -1.0836 + 2.43934 * x + 0.09407 * (x ** 2) - 0.9348 * (x ** 3) + 0.45635 * (x
| ** 4) - 0.0908 * (
101 | x ** 5) + 0.00671 * (x ** 6)
102 | if 0.15 < t / D <= 0.2:
103 | kby = -1.4092 + 3.62945 * x - 1.3188 * (x ** 2) - 0.219 * (x ** 3) + 0.27892 * (x **
4) - 0.07 * (
104 | x ** 5) + 0.00582 * (x ** 6)
105 | if 0.12 < t / D <= 0.15:
106 | kby = -1.7669 + 5.01225 * x - 3.2457 * (x ** 2) + 0.9993 * (x ** 3) - 0.119 * (x **
4) - 0.0044 * (
107 | x ** 5) + 0.00149 * (x ** 6)
108 | if 0.1 < t / D <= 0.12:
109 | kby = -3.0275 + 9.93272 * x - 10.321 * (x ** 2) + 5.8327 * (x ** 3) - 1.8303 * (x **
4) + 0.29884 * (
110 | x ** 5) - 0.0197 * (x ** 6)
111 | if 0.08 < t / D <= 0.1:
112 | kby = -2.7484 + 8.61564 * x - 8.1903 * (x ** 2) + 4.174 * (x ** 3) - 1.1742 * (x **
4) + 0.17149 * (
113 | x ** 5) - 0.0101 * (x ** 6)
114 | if 0.06 < t / D <= 0.08:
115 | kby = -2.4114 + 7.7648 * x - 7.6285 * (x ** 2) + 4.0767 * (x ** 3) - 1.2130 * (x **
4) + 0.1882 * (
116 | x ** 5) - 0.0118 * (x ** 6)
117 | if 0 < t / D <= 0.06:
118 | kby = -2.6227 + 8.91273 * x - 0.8543 * (x ** 2) + 5.8749 * (x ** 3) - 1.9336 * (x **
4) + 0.3295 * (
119 | x ** 5) - 0.0226 * (x ** 6)

120
121 | return kby
122 | M_S =0 # 1.25 * 1.1 - 1 | The safety factors are already applied at the locations where the
material properties are used (x1.1) and for the forces (x1.25)
123 | def Optimize_Lug(Material_In2,Sigma_In,Density_In,design_object, design_loads, high_accuracy)
| :
124 | # to be changed

125
126 | N_lugs = design_object.N_lugs
127 | N_Flanges = design_object.N_Flanges
128 | if high_accuracy == True:
129 | [i_step, j_step, k_step,l_step, Material_List, tolerance] = [20, 5, 20, 50,
| Material_In2, 0.001]
130 | else:
131 | [i_step, j_step, k_step, l_step, Material_List, tolerance] = [40, 10, 40, 100,
| Material_In2,0.01]
132 | # calculate Dist_between_lugs here:

133 | design_object.Dist_between_lugs = 1.4
134 | # design_object.Dist_between_lugs = calculated_Dist_between_lugs
135 | if design_object.Dist_between_lugs == 0:
136 | design_object.Dist_between_lugs = 0.8
137 | distance = design_object.Dist_between_lugs
138 | else:
139 | distance = design_object.Dist_between_lugs
140 | # FORCES with safety factor of 1.25
141 | Fx = design_loads.F_x / (N_Flanges * N_lugs)
142 | Fy = design_loads.F_y / (N_Flanges * N_lugs)
143 | Fz = design_loads.F_z / (N_Flanges * N_lugs)
144 | Mx = design_loads.M_x
145 | My = design_loads.M_y
146 | Mz = design_loads.M_z | # to be changed
147 | material_best_configuration_dictionnary = []
148 | design_array = []
149 | # Optimisation for each material and compare the options
150 | # intial guesses for '2014-T6(DF-L)':
151 | dictionnary = []
152 | for material in Material_List:
153 | for i in Material_In2:
154 | if i == material:
155 | sigma_y = Sigma_In[Material_In2.index(i)]
156 | for i in range(10, 500, i_step):
157 | e = i * 10 ** (-3)
158 | for j in range(1, 50, j_step):
159 | t = j * 10 ** (-3)
160 | print(f”Progress: {round((i/500+j/(50*j_step))*100/1.062,1)}% of Material: {
material}”, flush=True)
161 | for k in range(10, 500, k_step):
162 | D = k * 10 ** (-3)
163 | for l in range(10, 900, l_step):
164 | h = l * 10 ** (-3)
165 | initial_guess = [e, t, D, h]
166 | # e=radius outer flange, t=thickness, D=diameter of the inner circle,
| material

167
168 | K_t = calculate_kt(initial_guess[0], initial_guess[1], material,
initial_guess[2], Material_In2)
169 | K_ty = choose_kby(initial_guess[2], initial_guess[1], initial_guess
| [0])
170 | def objective_function(variables, material=material):
171 | | e, t, D, h= variables
172 | | volume = calculate_vol(t, e, D)
173 | | for i in Material_In2:
174 | | if i == material:
175 | | rho = Density_In[Material_In2.index(i)]
176 | | m = rho * volume
177 | | return m

178
179 | def volume_constraint(variables):
180 | | e, t, D, h = variables
181 | | return calculate_vol(t, e, D)

182
183 | def principal_constraint(variables):
184 | | e, t, D, h = variables
185 | | # K_t = calculate_kt(e,D,material,t)
186 | | # K_ty = choose_kby(t,D,e)
187 | | A_t = calculate_tension_area(t, e, D)
188 | | A_br = calculate_bearing_area(t, D)
189 | | for i in Material_In2:
190 | | if i == material:
191 | | sigma_y = Sigma_In[Material_In2.index(i)]*1.1 #SF for
| material porperties
192 | | if N_lugs == 2:
193 | | force_couple_y = My/(distance*N_Flanges)
194 | | else:
195 | | force_couple_y = My/h
196 | | return ((Fx / (K_t * sigma_y* A_t)) ** 1.6 + ((Fz +
force_couple_y)/ (K_ty * A_br * sigma_y)) ** 1.6)**(-0.625) - 1 - M_S
197 | def constraint_thickness(variables):

198 | e,t,D,h =variables
199 | return -t + 0.05
200 | def constraint_thickness_bigger_zero(variables):
201 | e,t,D,h =variables
202 | return t-0.0001
203 | def constraint_outer_radius(variables):
204 | e,t,D,h=variables
205 | return -e+0.2
206 | def constraint_outer_radius_bigger_zero(variables):
207 | e,t,D,h =variables
208 | return e-0.0001
209 | def constraint_inner_diameter(variables):
210 | e,t,D,h= variables
211 | return | -D+0.39
212 | def constraint_inner_diameter_bigger_zero(variables):
213 | e,t,D,h= variables
214 | return | D-0.005
215 | def constraint_dimension(variables):
216 | e, t, D, h = variables
217 | return e-D/2 -0.005

218
219 | def constraint_inter_flange_distance(variables):
220 | e, t, D, h = variables
221 | return h-0.0001

222
223 | def constraint_inter_flange_distance_max(variables):
224 | e, t, D, h = variables
225 | return -h+1
226 | if N_Flanges == 2:
227 | def constraint_zero_h(variables):
228 | e, t, D, h = variables
229 | return h
230 | def moment_x_constraint(variables):
231 | e,t,D,h = variables
232 | sigma = (Mx*e)/((t*(2*e)**3)/12)-sigma_y*1.1
233 | return sigma

234
235 | def thickness_over_diameter_lower_limit(variables):
236 | e,t,D,h = variables
237 | return - e/t + 10
238 | if design_object.N_Flanges ==2:
239 | constraints = [
240 | {'type': 'ineq', 'fun': volume_constraint},
241 | {'type': 'eq', 'fun': principal_constraint},
242 | {'type': 'ineq', 'fun': constraint_thickness},
243 | {'type': 'ineq', 'fun': constraint_thickness_bigger_zero},
244 | {'type': 'ineq', 'fun': constraint_outer_radius},
245 | {'type': 'ineq', 'fun': constraint_outer_radius_bigger_zero},
246 | {'type': 'ineq', 'fun': constraint_inner_diameter},
247 | {'type': 'ineq', 'fun': constraint_inner_diameter_bigger_zero
},
248 | {'type': 'ineq', 'fun': constraint_dimension},
249 | {'type': 'ineq', 'fun': constraint_inter_flange_distance},
250 | {'type': 'ineq', 'fun': constraint_inter_flange_distance_max
},
251 | {'type': 'ineq', 'fun': moment_x_constraint},
252 | {'type': 'ineq', 'fun': thickness_over_diameter_lower_limit},
253 | {'type': 'ineq', 'fun': constraint_zero_h}
254 | ]
255 | else:
256 | constraints = [
257 | {'type': 'ineq', 'fun': volume_constraint},
258 | {'type': 'eq', 'fun': principal_constraint},
259 | {'type': 'ineq', 'fun': constraint_thickness},
260 | {'type': 'ineq', 'fun': constraint_thickness_bigger_zero},
261 | {'type': 'ineq', 'fun': constraint_outer_radius},
262 | {'type': 'ineq', 'fun': constraint_outer_radius_bigger_zero},
263 | {'type': 'ineq', 'fun': constraint_inner_diameter},
264 | {'type': 'ineq', 'fun': constraint_inner_diameter_bigger_zero
},
265 | {'type': 'ineq', 'fun': constraint_dimension},

266 | {'type': 'ineq', 'fun': constraint_inter_flange_distance},
267 | {'type': 'ineq', 'fun': constraint_inter_flange_distance_max
| },
268 | {'type': 'ineq', 'fun': moment_x_constraint},
269 | {'type': 'ineq', 'fun': thickness_over_diameter_lower_limit},
270 | #{'type': 'ineq', 'fun': constraint_zero_h}
271 | ]

272
273 | # Choose an optimization method
274 | method = 'SLSQP'
275 | # Call the minimize function (Turning of display makes it WAY faster
| as printing takes a lot of memory)
276 | result = minimize(objective_function, initial_guess, method=method,
| constraints=constraints,
277 | options={'disp': False}, tol=tolerance)

278
279 | if result.success == True and 0.01 <= result.fun <= 0.9:
280 | dictionnary.append([result.x, result.fun])
281 | else:
282 | pass
283 | best_configuration = None
284 | min_mass = float('inf')
285 | # Iterate through the configurations
286 | for config in dictionnary:
287 | dimensions, mass = config
288 | if mass < min_mass:
289 | min_mass = mass
290 | best_configuration = config
291 | material_best_configuration_dictionnary.append((material,best_configuration))

292
293 | #Check of the height of the flange limited by the Fy = 433:
294 | # if stress is exceeding the yield stress = fail
295 | MMOI = ((2*best_configuration[0][0]) *(best_configuration[0][1])**3)/12
296 | if MMOI == 0:
297 | MMOI = 0.0001

298
299 | height_flange = best_configuration[0][0] + 2*sigma_y*MMOI/(best_configuration[0][1]*
| Fy) #np.sqrt((MMOI*sigma_y*1.1)/Fy)
300 | if height_flange <= 3*best_configuration[0][0]:
301 | height_flange = 3*best_configuration[0][0]
302 | #required_MMOI = (Fy * (height_flange - best_configuration[0][0])**2)/(sigma_y
| *1.1)
303 | #best_configuration[0][1] = required_MMOI*12/(2*(best_configuration[0][0])**(1/3)
| )
304 | best_configuration[0][1] = np.sqrt(3*Fx/(sigma_y * 10**6))
305 | design_array.append(DesignClass.DesignInstance(h=1000*best_configuration[0][3], t1
| =1000*best_configuration[0][1], t2=design_object.t2, t3=design_object.t3, D1=1000*
| best_configuration[0][2], \
306 | w=2*1000*best_configuration[0][0],
| material=material, n_fast=design_object.n_fast, length=design_object.length, \
307 | offset=0.5*(design_object.length
| -1000*best_configuration[0][1]-1000*best_configuration[0][3]*(design_object.N_Flanges-1))
| ,flange_height=1000*height_flange,hole_coordinate_list=design_object.hole_coordinate_list
| , \
308 | D2_list=design_object.D2_list,
| yieldstrength=sigma_y,N_lugs=design_object.N_lugs,N_Flanges=design_object.N_Flanges,
| Dist_between_lugs=design_object.Dist_between_lugs*1000)) #convert meters to millimeters

309
310 | print(material_best_configuration_dictionnary)
311 | return design_array

### Listing A.4: LocalLoadCalculatorAndLugDesignerAndLugConfigurator.py code

1
2 | # Please add the following: as output return True/False for whether the input design passes
| the bearingcheck, and if it does not, add an additional output
3 | # that says one of the following: ”x needs to increase”, ”y needs to increase”, ”x needs to
| decrease”, ”y needs to decrease”, ”Diameter needs to increase”, ”Diameter can decrease”
4 | # as well as the index i that corresponds to the hole that this advice applies to. Only one
| advice about one hole needs to be returned
5 | # at a time; the function can be run again to get advices for the other holes.

6

7
8 | import DesignClass as dc
9 | import numpy as np
10 | debug_design_2 = dc.DesignInstance(h=10, t1=0.8862884667966812, t2=2.6499999999999986, t3=2,
D1=5, w=19.580136993010818, material=”metal”, n_fast=4, \
11 | length=47, offset=-0.44314423339834086,
flange_height=29.370205489516227, \
12 | hole_coordinate_list=[(4.756555492274806,
4.626310958321483), (4.756555492274806, 119.95382603468913), (42.24344450772523, 4.626310958321483), (42.24344450772523, 119.95382603468913)], \
13 | D2_list=[2.4,2.4,2.4, 2.4], yieldstrength=414,
N_lugs=2,N_Flanges=2, Dist_between_lugs=1400, bottomplatewidth=124.58013699301083)
14 | # debug_design_2.minimum_diameter = 3
15 | # debug_design_2.maximum_diameter = 5
16 | # debug_design_2.fastener_rows = 2
17 | # debug_design_2.n_fast = 4
18 | #debug_design_2.l = 6
19 | #hole_coordinate_list = [(-30, -80), (20, 80), (-20, 60), (20, -70)]
20 | #D2_list = [10, 5, 9, 8]
21 | # Fx = 400
22 | # Fz = 1200

23
24 debug_loads = dc.Load(433.6,433.6,1300.81,817.34,817.34,0)

25
26 | def calculate_centroid(design_object):
27 | holes_area = np.pi * np.array(design_object.D2_list) ** 2 / 4
28 | weighted_sum_z = np.sum(np.array(design_object.hole_coordinate_list)[:, 1] * holes_area)
29 | weighted_sum_x = np.sum(np.array(design_object.hole_coordinate_list)[:, 0] * holes_area)
30 | centroid_x = weighted_sum_x / np.sum(holes_area)
31 | centroid_z = weighted_sum_z / np.sum(holes_area)

32
33 | return (centroid_x,centroid_z)

34
35 | centroid_x, centroid_z = calculate_centroid(debug_design_2)
36 | def get_in_plane_loads(design_object, load_object):
37 | f_in_planex = load_object.F_x / len(design_object.D2_list)
38 | f_in_planez = load_object.F_z / len(design_object.D2_list)
39 | r_to_cg = np.sqrt((centroid_x - design_object.length/2)**2 + (centroid_z - design_object.
bottomplatewidth/2)**2)/1000

40
41 | M_y=0
42 | if centroid_x == design_object.length/2 and centroid_z == design_object.bottomplatewidth
/2:
43 | M_y = 0
44 | elif centroid_x == design_object.length/2 and centroid_z > design_object.bottomplatewidth
/2:
45 | M_y = - load_object.F_x * r_to_cg
46 | elif centroid_x == design_object.length/2 and centroid_z < design_object.bottomplatewidth
/2:
47 | M_y = | load_object.F_x * r_to_cg
48 | elif centroid_x > design_object.length / 2 and centroid_z == design_object.
bottomplatewidth / 2:
49 | M_y = - load_object.F_z * r_to_cg
50 | elif centroid_x < design_object.length / 2 and centroid_z == design_object.
bottomplatewidth / 2:
51 | M_y = | load_object.F_z * r_to_cg
52 | elif centroid_x < design_object.length / 2 and centroid_z < design_object.
bottomplatewidth / 2:
53 | theta = np.arctan(np.absolute((centroid_z - design_object.bottomplatewidth / 2) / (
centroid_x - design_object.length / 2)))
54 | M_y = | (load_object.F_z * np.cos(theta) + load_object.F_x * np.sin(theta)) * r_to_cg

55
56 | elif centroid_x < design_object.length / 2 and centroid_z > design_object.
bottomplatewidth / 2:
57 | theta = np.arctan(np.absolute((centroid_z - design_object.bottomplatewidth / 2) / (
centroid_x - design_object.length / 2)))
58 | M_y = | (load_object.F_z * np.cos(theta) | - load_object.F_x * np.sin(theta)) * r_to_cg

59
60 | elif centroid_x > design_object.length / 2 and centroid_z > design_object.
bottomplatewidth / 2:

61 | theta = np.arctan(np.absolute((centroid_z - design_object.bottomplatewidth / 2) / (
centroid_x - design_object.length / 2)))
62 | M_y = | - (load_object.F_z * np.cos(theta) | + load_object.F_x * np.sin(theta)) *
| r_to_cg

63
64 | elif centroid_x > design_object.length / 2 and centroid_z < design_object.
bottomplatewidth / 2:
65 | theta = np.arctan(np.absolute((centroid_z - design_object.bottomplatewidth / 2) / (
centroid_x - design_object.length / 2)))
66 | M_y = | (-load_object.F_z * np.cos(theta) | + load_object.F_x * np.sin(theta)) *
| r_to_cg

67
68 | return f_in_planex , f_in_planez, M_y

69
70 | def get_F_in_plane_My(design_object, load_object3):
71 | S = np.sum(((np.array(design_object.hole_coordinate_list)[:, 0] - centroid_x) ** 2 + (np.
array(design_object.hole_coordinate_list)[:, 1] - centroid_z) ** 2) *np.pi * np.array( design_object.D2_list) ** 2 / 4) / (1000 ** 2)
72 | M_y = get_in_plane_loads(design_object, load_object3)[2]

73
74 | F_in_plane_My = []

75
76 | for i in range(len(design_object.D2_list)):
77 | distance_x_1 = design_object.hole_coordinate_list[i][0] - centroid_x
78 | distance_z_1 = design_object.hole_coordinate_list[i][1] - centroid_z
79 | r = np.sqrt(distance_x_1 ** 2 + distance_z_1 ** 2)/1000
80 | A = (np.pi * design_object.D2_list[i] ** 2 / 4)
81 | F_in_plane_My_value = M_y * A * r / S
82 | F_in_plane_My.append(F_in_plane_My_value)
83 | return F_in_plane_My

84

85

86

87

88
89 | #print(get_in_plane_loads(debug_design_2, debug_loads))
90 | #print(calculate_centroid(debug_design_2))
91 | #print(get_F_in_plane_My(debug_design_2, debug_loads))

92
93 def check_bearing_stress(design_object, load_object2,thermal_force):

94
95 | M_y = get_in_plane_loads(design_object, load_object2)[2]
96 | S = np.sum(((np.array(design_object.hole_coordinate_list)[:, 0] - centroid_x) ** 2 + (np.
array(design_object.hole_coordinate_list)[:, 1] - centroid_z) ** 2) * np.pi * np.array( design_object.D2_list) ** 2 / 4) / (1000 ** 4)

97
98 | sigma0 = []
99 | for i in range(len(design_object.D2_list)):
100 | distance_x_1 = design_object.hole_coordinate_list[i][0] - centroid_x
101 | distance_z_1 = design_object.hole_coordinate_list[i][1] - centroid_z
102 | r = np.sqrt(distance_x_1 ** 2 + distance_z_1 ** 2)/1000
103 | A = (np.pi * design_object.D2_list[i] ** 2 / 4)/(1000**2)
104 | P = np.sqrt(get_in_plane_loads(design_object, load_object2)[0]**2 +
get_in_plane_loads(design_object, load_object2)[1]**2 + (M_y * A * r / S)**2 + thermal_force[i]**2)
105 | sigma = (P / (design_object.D2_list[i] * design_object.t2))
106 | sigma0.append(sigma)

107
108 | if np.max(sigma0) < design_object.yieldstrength:
109 | return ”Bearing Stress Check Pass”
110 | else:
111 | return ”Bearing Stress Check Failed, increase the thickness of the backplate ”

112
113 | print(check_bearing_stress(debug_design_2, debug_loads,[1533.2328, | 383.3082,
1241.918568, | 981.268992]))
114 | #
115 | # print(debug_design_2.t2)
116 | # check1 = False
117 | # print(check_bearing_stress(debug_design_2, debug_loads, [0, 0, 0,
118 | # | 0]))
119 | # if not check_bearing_stress(debug_design_2, debug_loads, [0, 0, 0,

120 | # | 0]) == ”Bearing Stress Check
| | Failed, increase the thickness of the backplate ”:
121 | # | check1 = True
122 | # counter1 = 0
123 | # print(check1)
124 | # while check1 == False and counter1 < 50:
125 | # | debug_design_2.t2 += 0.2
126 | # | if not check_bearing_stress(debug_design_2, debug_loads,[0,0,0,0]) == ”Bearing Stress
| | Check Failed, increase the thickness of the backplate ”:
127 | # | check1=True
128 | # | else:
129 | # | print(”gonna increase”)
130 | # | counter1 += 1
131 | #
132 | # print(debug_design_2.t2, counter1)
133 | #
134 | #

### Listing A.5: CheckBearing.py code

1 # Please add the following: as output return True/False for whether the input design passes the pull through check, and if it does not, add an additional output
2 # that says one of the following: ”x needs to increase”, ”y needs to increase”, ”x needs to decrease”, ”y needs to decrease”, ”Diameter needs to increase”, ”Diameter can decrease” 3 # as well as the index i that corresponds to the hole that this advice applies to. Only one advice about one hole needs to be returned
4 # at a time; the function can be run again to get advices for the other holes.

5
6 | # This software component will check the given input design for Pull Through Failure.
7 | import DesignClass
8 | import numpy as np

9
10 import InputVariables

11
12 debug_design_2 = DesignClass.DesignInstance(h=30, t1=5, t2=0.1, t3=2, D1=10, w=80, material=” 2014-T6(P)”, n_fast=4, \
13 | length=10, offset=20,flange_height=80, \
14 | hole_coordinate_list=[(3, 35), (3, 65), (7, 35),
| (7, 65)], \
15 | D2_list=[10.5, 10.5, 10.5, 10.5], yieldstrength
=83,N_lugs=2,N_Flanges=2, bottomplatewidth=100)
16 debug_design_1 = DesignClass.DesignInstance(h=30, t1=5, t2=0.2, t3=0.2, D1=10, w=50, material =”2014-T6(P)”, n_fast=4,
17 | length=100, offset=20, flange_height=60,
| bottomplatewidth=100,
18 | hole_coordinate_list=[(10, 10), (10, 90), (90,
| 10), (90, 90)],
19 | D2_list=[5, 5, 5, 5], yieldstrength=83,
shearstrength=550,N_lugs=1,N_Flanges=2)
20 debug_loads = DesignClass.Load(433.6,433.6,1300.81,817.34,817.34,0)

21

22
23 def check_pullthrough(design_object, load_object): #checks pullout shear, if smaller than max we can decrease thickness,
24 | index = InputVariables.Material.index(design_object.material)
25 | design_object.shearstrength = InputVariables.shear_strength[index]
26 | n_fast = len(design_object.D2_list)
27 | F_x = load_object.F_x
28 | F_y = load_object.F_y | # 433.60
29 | F_z = load_object.F_z
30 | M_x = load_object.M_x + F_z * 0.001 * (design_object.flange_height - design_object.w / 2)
# M_x(817.34) plus moment from F_z

31 | M_z = F_x * 0.001 * (design_object.flange_height - design_object.w / 2)
32 | Sum_A_rz2 = 0
33 | Sum_A_rx2 = 0
34 | F_yi = []
35 | F_y_Mx = []
36 | F_y_Mz = []
37 | F_y_load = F_y / n_fast
38 | # just direct load F_y:
39 | for i in range(len(design_object.D2_list)):

40 | F_yi.append(F_y_load)
41 | # contribution from M_x:
42 | for i in range(len(design_object.D2_list)):
43 | rz_i = design_object.hole_coordinate_list[i][1] - design_object.bottomplatewidth/2
44 | Sum_A_rz2 += (np.pi * 0.25 * design_object.D2_list[i] ** 2) * (rz_i ** 2) | # in mm^4
45 | for i in range(len(design_object.D2_list)):
46 | rz_i = design_object.hole_coordinate_list[i][1] - design_object.bottomplatewidth/2
47 | F_y_Mx.append((M_x * 1000 * rz_i * np.pi * 0.25 * design_object.D2_list[i] ** 2) /
Sum_A_rz2)
48 | # contribution from M_z:
49 | for i in range(len(design_object.D2_list)):
50 | rx_i = design_object.hole_coordinate_list[i][0] - design_object.length/2
51 | Sum_A_rx2 += (np.pi * 0.25 * design_object.D2_list[i] ** 2) * (rx_i ** 2) | # in mm^4
52 | for i in range(len(design_object.D2_list)):
53 | rx_i = design_object.hole_coordinate_list[i][0] - design_object.length/2
54 | F_y_Mz.append((M_z * 1000 * rx_i * np.pi * 0.25 * design_object.D2_list[i] ** 2) /
Sum_A_rx2)
55 | # adding all three components:
56 | for i in range(len(design_object.D2_list)):
57 | F_yi[i] += F_y_Mx[i] + F_y_Mz[i]

58
59 | # checking for failure:
60 | for i in range(len(design_object.D2_list)):
61 | Dfi = design_object.D2_list[i]
62 | Dfo = 1.8 * Dfi
63 | #print(”Dfo”,Dfo)
64 | shear = F_yi[i] / (np.pi * (Dfo/1000) * (design_object.t2/1000))
65 | shear2 = F_yi[i] / (np.pi * (Dfo / 1000) * (design_object.t3 / 1000))
66 | print(”shears”,shear2, shear)
67 | sigma_y = F_yi[i]/(np.pi / 4 * ((Dfo/1000)**2-(Dfi/1000)**2))
68 | shearmax = design_object.shearstrength*10**6 #np.sqrt((design_object.yieldstrength**2
- sigma_y**2)/3)
69 | print(”shearmax”, shearmax)

70
71 | if not abs(shear) < abs(shearmax):
72 | xmax = 0
73 | xmin = design_object.length
74 | for hole in design_object.hole_coordinate_list:
75 | if hole[0] > xmax:
76 | xmax = hole[0]
77 | if hole[0] < xmin:
78 | xmin = hole[0]
79 | DeltaX = xmax-xmin
80 | zmax = 0
81 | zmin = design_object.bottomplatewidth
82 | for hole in design_object.hole_coordinate_list:
83 | if hole[1] > zmax:
84 | zmax = hole[1]
85 | if hole[1] < zmin:
86 | zmin = hole[1]
87 | DeltaZ = zmax - zmin
88 | if abs(design_object.hole_coordinate_list[i][0]-0.5*design_object.length) < 0.5*
design_object.h*(design_object.N_Flanges-1) * design_object.t1*design_object.N_Flanges *0.5:
89 | return [False, ”increase x”, i]
90 | if (F_x*design_object.flange_height/(M_x+F_z*design_object.flange_height)) <
| DeltaX/DeltaZ:
91 | # if design_object.hole_coordinate_list[i][0] < design_object.
bottomplatewidth/2:
92 | # | if | design_object.hole_coordinate_list[i][1] - 2 * design_object.
| D2_list[i] > 0:
93 | # | | return [False, ”decrease x”, i]
94 | # if design_object.hole_coordinate_list[i][1] > design_object.
bottomplatewidth/2:
95 | return [False, ”increase z”, i]
96 | else:
97 | return [False, ”increase x”, i]
98 | # elif abs(F_y_Mx[i]) < abs(F_y_Mz[i]):
99 | # | return [False, ”increase t2”]
100 | # else:
101 | # | if design_object.hole_coordinate_list[i][0] > design_object.length / 2:

102 | # | return [False, ”increase x”, i]
103 | # | if design_object.hole_coordinate_list[i][0] < design_object.length / 2:
104 | # | if (design_object.hole_coordinate_list[i][0] + design_object.D2_list[i]
/ 2) < design_object.length/2 - design_object.h/2:
105 | # | if design_object.hole_coordinate_list[i][0] - 2 * design_object.
D2_list[i] > 0:
106 | # | return [False, ”decrease x”, i]
107 | if not shear2 < shearmax:
108 | return [False, ”increase t3”]
109 | return [True, ”do nothing”]

110
111 print(check_pullthrough(debug_design_1, debug_loads))

112
113 | # diameter head and shank diameter ratio is 1.8
114 | #print(calculate_centroid(debug_design_1),check_pull_through(debug_design_1) )
115 | print(”here”,check_pullthrough(debug_design_2,debug_loads))
116 | print(debug_design_2.shearstrength)

### Listing A.6: CheckPullThrough.py code

1 | # This software component will check the given input design for Thermal Stress Failure.
2 | import numpy as np
3 | import InputVariables
4 | import DesignClass

5
6 | # assumption is that for the temperature the coefficient remains linear . mention limitation
7 | # aluminum https://ntrs.nasa.gov/api/citations/19720023885/downloads/19720023885.pdf
8 | # 7075-T6 https://www.matweb.com/search/datasheet_print.aspx?matguid=4
| f19a42be94546b686bbf43f79c51b7d
9 | # 4130 steel https://industeel.arcelormittal.com/fichier/ds-mold-4130/
10 | #8630 steel https://dl.asminternational.org/handbooks/edited-volume/9/chapter/113443/Thermal-
| Properties-of-Carbon-and-Low-Alloy-Steels
11 | # 2024-T4 https://www.gabrian.com/2024-aluminum-properties/
12 | # 356-T6 Aluminium https://metalitec.zriha.com/eng/raw-materials/a356-t6
13 | # 2024-T3 2024-T3 https://www.gabrian.com/2024-aluminum-properties

14
15 | #sources for elastic module
16 | # aluminum 2014-T6 https://asm.matweb.com/search/SpecificMaterial.asp?bassnum=MA2014T6
17 | # 7075-T6 https://asm.matweb.com/search/SpecificMaterial.asp?bassnum=ma7075t6
18 | # 4130 steel https://asm.matweb.com/search/SpecificMaterial.asp?bassnum=m4130r
19 | #8630 steel https://www.efunda.com/materials/alloys/alloy_steels/show_alloy.cfm?ID=AISI_8630&
| show_prop=all&Page_Title=AISI%208630
20 | # 2024-T4 https://asm.matweb.com/search/SpecificMaterial.asp?bassnum=ma2024t4
21 | # 356-T6 Aluminium https://www.matweb.com/search/datasheet_print.aspx?matguid=
| d524d6bf305c4ce99414cabd1c7ed070
22 | # 2024-T3 https://asm.matweb.com/search/SpecificMaterial.asp?bassnum=ma2024t3

23
24 | debug_design_2 = DesignClass.DesignInstance(h=30, t1=5, t2=10, t3=2, D1=10, w=40, material=”
| metal”, n_fast=4, \
25 | length=80, offset=20,flange_height=80, \
26 | hole_coordinate_list=[(20, 10), (20, 30), (60,
| 10), (60, 30)], \
27 | D2_list=[6, 6, 6, 6], yieldstrength=83,N_lugs=1,
| N_Flanges=2)

28
29 | def thermal_stress_calculation(design_object, upper_temp , lower_temp, ref_temp , phi_list ,
| material_fastener , material_plate):
30 | temp_diff_upper = upper_temp - ref_temp
31 | temp_diff_lower = ref_temp - lower_temp
32 | np_d2_list = np.array(design_object.D2_list)
33 | np_phi_list = np.array(phi_list)
34 | for materials in InputVariables.materials_lug:
35 | if materials.get(”material”) == material_plate:
36 | material_wall_coeff = materials.get('thermal_expansion_coefficient')
37 | for materials in InputVariables.materials_fasteners:
38 | if materials.get(”Material”) == material_fastener:
39 | material_fastener_stiffness = float(materials.get(”Youngs Modulus (GPa)”))
40 | material_fastener_coeff = float(materials.get(”Thermal Expansion (10^-6)/K”))
41 | # units of thermal coefficient should be in micro(10^-6) and elasitic modulus in mega
| (10^9)
42 | print(material_fastener_coeff , ”fast”),print(material_wall_coeff , ”wall”)

43 | thermal_force_upper = (np_d2_list/1000) ** 2 / 4 * 3 * temp_diff_upper * (
| material_fastener_coeff - material_wall_coeff) * (1-np_phi_list) *
| material_fastener_stiffness * 1000
44 | thermal_force_lower = (np_d2_list/1000) ** 2 / 4 * 3 * temp_diff_lower * (
| material_fastener_coeff - material_wall_coeff) * (1-np_phi_list) *
| material_fastener_stiffness * 1000 * -1
45 | if np.min(thermal_force_lower) > 0:
46 | return thermal_force_lower , ”temperature decrease”
47 | else:
48 | return thermal_force_upper , ”temperature increase”

49
50 | print(”this”, thermal_stress_calculation(debug_design_2,150,-90,15,[0.04,0.04,0.04,0.04] ,”
| Titanium (Grade 5)”,'2014-T6(DF-L)'))

### Listing A.7: CheckThermalStress.py code

1 | # This software component will select the fastener configuration according to WP4.4.
2 | # this checks if given w allows for the number and size of fastners given constraints
3 | import copy

4
5 | import DesignClass
6 | import math
7 | import numpy as np

8

9
10 | debug_design = DesignClass.DesignInstance(h=30, t1=5, t2=10, t3=2, D1=10, w=80, material=”
| metal”, n_fast=4, \
11 | | length=200, offset=20,flange_height=80, \
12 | | hole_coordinate_list=[(22, 20), (180, 30), (160,
| 20), (25, 25)], \
13 | | D2_list=[10, 5, 9, 8], yieldstrength=83,N_lugs=1,
| N_Flanges=2)

14
15 | #check wether spacing constraints detailed in 4.4 are met, inp
16 | # buts are list of coordinates and list of diameter sizes
17 | def fastener_spacing_check(design_object):
18 | np_D2_list = np.array(design_object.D2_list)
19 | np_hole_coordinate_list = np.array(design_object.hole_coordinate_list)
20 | # these
21 | if True == True: #design_object.material == ”metal”: # for now we only consider metals
22 | lower_limit = 2 * np.max(np_D2_list)
23 | upper_limit = 3 * np.max(np_D2_list)

24
25 | elif design_object.material == ”composite”:
26 | lower_limit = 4 * np.max(np_D2_list)
27 | upper_limit = 5 * np.max(np_D2_list)

28
29 | #for loop checks wether the holes are within the margin of 2 * D2 from edges. For every
| hole
30 | for i in range(len(np_D2_list)):
31 | if np_hole_coordinate_list[i,0] <= 2 * np_D2_list[i] or design_object.length -
np_hole_coordinate_list[i,0] <= 2 * np_D2_list[i]:
32 | #print(”LengthMarginErr”)
33 | if np_hole_coordinate_list[i,0] - 2 * np_D2_list[i] <= 0:
34 | #print(np_hole_coordinate_list[i,0], np_D2_list[i])
35 | #print(”LengthMarginErr1”)
36 | return False , i , np_hole_coordinate_list[i,0] - 2 * np_D2_list[i], ”
| LengthMarginError”
37 | elif design_object.length - np_hole_coordinate_list[i,0] - 2 * np_D2_list[i] <=0:
38 | #print(”LengthMarginErr2”)
39 | return False , i , design_object.length - np_hole_coordinate_list[i,0]- 2 *
| np_D2_list[i] , ”LengthMarginError”
40 | if np_hole_coordinate_list[i,1] | < 2 * np_D2_list[i] or design_object.
bottomplatewidth - np_hole_coordinate_list[i,1] < 2 * np_D2_list[i]:
41 | if np_hole_coordinate_list[i,1] - 2 * np_D2_list[i] <= 0:
42 | return False , i , np_hole_coordinate_list[i,1] - 2 * np_D2_list[i] , ”
| WidthMarginError”
43 | elif design_object.bottomplatewidth - np_hole_coordinate_list[i,1] - 2 *
| np_D2_list[i] <=0:
44 | return False , i , design_object.bottomplatewidth - np_hole_coordinate_list[i
,1] - 2 * np_D2_list[i] , ”WidthMarginError”

45 | #lower limit and upper limit are calculated based on the material and the for loop checks
wether the center to
46 | #center constraint complies...
47 | for i in range(len(np_D2_list)):
48 | for k in range(i + 1, len(np_D2_list)):
49 | distance_x = np_hole_coordinate_list[i][0] - np_hole_coordinate_list[k][0]
50 | distance_y = np_hole_coordinate_list[i][1] - np_hole_coordinate_list[k][1]
51 | distance = math.sqrt(distance_x ** 2 + distance_y ** 2)
52 | if i != k and not distance >= lower_limit:
53 | | # returns the indexs of the hole_list that are causing an issue and wether
the distance betweeen them
54 | | # should be increased or decreased
55 | | return False, i, k, ”HoleDistanceTooSmall”
56 | # elif i != k and not distance <= upper_limit:
57 | # | return False, i , k , ”HoleDistanceTooLarge”
58 | return [True]

59

60
61 | def Optimize_holes(design_object, recursive):
62 | new_object = copy.deepcopy(design_object)
63 | if fastener_spacing_check(new_object)[0] == True:
64 | return new_object
65 | if fastener_spacing_check(new_object)[3] == ”LengthMarginError” and new_object.length <
500:
66 | #print(”LengthMarginError”)
67 | new_object.length += 1
68 | for i in range(len(new_object.hole_coordinate_list)):
69 | new_object.hole_coordinate_list[i] = (new_object.hole_coordinate_list[i][0]+0.5,
new_object.hole_coordinate_list[i][1])
70 | #print(new_object.length)
71 | return Optimize_holes(new_object, True)
72 | elif fastener_spacing_check(new_object)[3] == ”WidthMarginError” and new_object.
bottomplatewidth < 400:
73 | #print(”WidthMarginError”)
74 | new_object.bottomplatewidth += 1
75 | for i in range(len(new_object.hole_coordinate_list)):
76 | new_object.hole_coordinate_list[i] = (new_object.hole_coordinate_list[i][0],
new_object.hole_coordinate_list[i][1]+0.5)
77 | #print(new_object.bottomplatewidth, new_object.hole_coordinate_list[0])
78 | #print(fastener_spacing_check(new_object))
79 | return Optimize_holes(new_object, True)
80 | elif fastener_spacing_check(new_object)[3] == ”HoleDistanceTooSmall”:
81 | index1 = fastener_spacing_check(new_object)[1]
82 | index2 = fastener_spacing_check(new_object)[2]
83 | if abs(new_object.hole_coordinate_list[index1][0] - new_object.hole_coordinate_list[
index2][0]) >= abs(new_object.hole_coordinate_list[index1][1] - new_object. hole_coordinate_list[index2][1]):
84 | if new_object.hole_coordinate_list[index1][0] - new_object.hole_coordinate_list[
index2][0] <= 0:
85 | | new_object.hole_coordinate_list[index1] = (new_object.hole_coordinate_list[
index1][0]-1, new_object.hole_coordinate_list[index1][1])
86 | | new_object.hole_coordinate_list[index2] = (
87 | | new_object.hole_coordinate_list[index2][0] + 1,
88 | | new_object.hole_coordinate_list[index2][1])
89 | if new_object.hole_coordinate_list[index1][0] - new_object.hole_coordinate_list[
index2][0] >= 0:
90 | | new_object.hole_coordinate_list[index1] = (new_object.hole_coordinate_list[
index1][0]+1, new_object.hole_coordinate_list[index1][1])
91 | | new_object.hole_coordinate_list[index2] = (
92 | | new_object.hole_coordinate_list[index2][0] - 1,
93 | | new_object.hole_coordinate_list[index2][1])
94 | else:
95 | if new_object.hole_coordinate_list[index1][1] - new_object.hole_coordinate_list[
index2][1] <= 0:
96 | | new_object.hole_coordinate_list[index1] = (new_object.hole_coordinate_list[
index1][0], new_object.hole_coordinate_list[index1][1]-1)
97 | | new_object.hole_coordinate_list[index2] = (
98 | | new_object.hole_coordinate_list[index2][0],
99 | | new_object.hole_coordinate_list[index2][1]+1)
100 | if new_object.hole_coordinate_list[index1][1] - new_object.hole_coordinate_list[
index2][1] >= 0:

101 | new_object.hole_coordinate_list[index1] = (new_object.hole_coordinate_list[
| index1][0], new_object.hole_coordinate_list[index1][1]+1)
102 | new_object.hole_coordinate_list[index2] = (
103 | new_object.hole_coordinate_list[index2][0],
104 | new_object.hole_coordinate_list[index2][1]-1)
105 | return Optimize_holes(new_object, True)
106 | else:
107 | #print(new_object.length, new_object.bottomplatewidth, ”dit”)
108 | return new_object

### Listing A.8: SelectFastenerConfiguration.py code

1 | # This software component will select the fastener based on WP4.10.
2 | import copy

3
4 | import numpy as np
5 | import DesignClass
6 | debug_design = DesignClass.DesignInstance(h=30, t1=5, t2=2, t3=4, D1=10, w=80, material=”
metal”, n_fast=4,length=200, offset=20, flange_height=80, hole_coordinate_list=[(20, 10), (180, 60), (160, 20), (30, 60)], D2_list=[9, 4, 6, 8], yieldstrength=83, N_lugs=1,
| N_Flanges=1)
7 | import InputVariables
8 | import CheckThermalStress
9 | import CheckBearing
10 | import CheckPullThrough

11

12

13
14 | def get_youngs_modulus_lug(material_name):
15 | for material in InputVariables.materials_lug:
16 | if material[”material”] == material_name:
17 | if isinstance(material[”elastic module”], tuple):
18 | # If the Young's Modulus is given as a range, you can return the average
19 | return sum(material[”elastic module”]) / len(material[”Youngs Modulus (GPa)”
| ])
20 | else:
21 | return material[”elastic module”]
22 | # If the material name is not found
23 | return None

24

25

26

27
28 | # debug_design.Ea = get_youngs_modulus(”Aluminium 7075”) * 10 ** 9
29 | # debug_design.L_h_sub_type = ”Hexagonal”
30 | # debug_design.L_eng_sub_type = ”Nut-Tightened”
31 | # debug_design.Eb = get_youngs_modulus(selected_material_fastener) * 10 ** 9
32 | # debug_design.En = get_youngs_modulus(selected_material_fastener) * 10 ** 9
33 | # debug_design.L = [1, 2,2, 1] | # shank length
34 | # debug_design.D = [10, 5, 9, 8] | # shank diamete

35
36 | ### Im gonna try to redo a bit of the code.
37 | fastener_debug = DesignClass.FastenerType(”Titanium (Grade 5)”,”Hexagonal”,”Nut-Tightened”)

38
39 | def get_fastener_dimensions(FastenerType,DesignInstance):
40 | np_D2list = np.array(DesignInstance.D2_list)
41 | if FastenerType.nut_type == ”Hexagonal”:
42 | height_head = (np_D2list * 0.5)
43 | elif FastenerType.nut_type == ”Cylindrical”:
44 | height_head = (np_D2list * 0.4)

45
46 | if FastenerType.hole_type == ”Threaded hole”:
47 | engaged_shank_length = (np_D2list * 0.33)
48 | elif FastenerType.hole_type == ”Nut-Tightened”:
49 | engaged_shank_length = (np_D2list * 0.4)
50 | #this could be the height of the nut or of the threaded insert thus the general name
| locking device height
51 | locking_device_height = (np_D2list * 0.4)
52 | return [height_head , engaged_shank_length , locking_device_height]

53
54 def calculate_delta_a(DesignInstance, plate_material , wall_material):

55 | Df_I = np.array(DesignInstance.D2_list)
56 | Df_O = 1.8 * Df_I
57 | thickness = [DesignInstance.t2,DesignInstance.t3]
58 | E = [get_youngs_modulus_lug(plate_material), get_youngs_modulus_lug(wall_material)]
59 | delta_a = []
60 | for i in range(2):
61 | delta_a_new = (4 * thickness[i]) / (E[i] * 10 ** 9 * np.pi * (Df_O ** 2 - Df_I ** 2))
62 | delta_a.append(delta_a_new)

63
64 | ”””delta_a_max = []

65
66 | for i in range(len(Df_O)):
67 | if delta_a[0][i] > delta_a[1][i]:
68 | delta_a_max.append(delta_a[0][i])
69 | else:
70 | delta_a_max.append(delta_a[1][i])”””

71
72 | return delta_a

73
74 print(calculate_delta_a(debug_design, ”7075-T6(DF-LT)”,”7075-T6(DF-LT)”))

75
76 | def calculate_deta_b(FastenerType,DesignInstance):
77 | np_D2_list = np.array(DesignInstance.D2_list)
78 | nominal_area = (1.8 * np_D2_list) ** 2 / 4 # maximal area of the fastener (bolt and head
| area --> assumption)
79 | shank_area = (np_D2_list - 1) ** 2 / 4 # minimum area of fastener
80 | head_height = get_fastener_dimensions(FastenerType,DesignInstance)[0]
81 | engaged_shank_length = get_fastener_dimensions(FastenerType, DesignInstance)[1]
82 | bolt_height = get_fastener_dimensions(FastenerType, DesignInstance)[2]
83 | shank_length = DesignInstance.t2 + DesignInstance.t3
84 | E_b = FastenerType.youngs_modulus * 10 ** 9
85 | delta_b = (1/E_b)*((head_height/nominal_area)+((shank_length + engaged_shank_length)/
| shank_area) + bolt_height/nominal_area)
86 | return delta_b

87

88
89 print(calculate_deta_b(fastener_debug,debug_design))

90

91
92 | def calculate_force_ratio(FastenerType, DesignInstance , plate_material , wall_material):
93 | force_ratio = []
94 | delta_a = calculate_delta_a(DesignInstance,plate_material,wall_material)
95 | delta_b = calculate_deta_b(FastenerType, DesignInstance)
96 | for i in range(2):
97 | force_ratio_element = list(delta_a[i]/(delta_a[i]+delta_b))
98 | force_ratio.append(force_ratio_element)
99 | #check which compliance is limiting
100 | if force_ratio[0] > force_ratio[1]:
101 | return force_ratio[1] , ”vehicle wall/fastener compliance is limiting”
102 | else:
103 | return force_ratio[0] , ”back plate/fastener compliance is limiting”

104
105 | return force_ratio[0]

106
107 | print(calculate_force_ratio(fastener_debug,debug_design,”7075-T6(DF-LT)”,”7075-T6(DF-LT)”)
| [0])

108
109 | def print_material_info(material_name):
110 | for material in InputVariables.materials_fasteners:
111 | if material[”Material”] == material_name:
112 | print(f”Material: {material['Material']}”)
113 | print(f”Young's Modulus (GPa): {material['Youngs Modulus (GPa)']}”)
114 | print(f”Density (kg/m^3): {material['Density (kg/m^3)']}”)
115 | print(f”Thermal Expansion (10^-6)/K: {material['Thermal Expansion (10^-6)/K']}”)
116 | print(f”Ultimate Tensile Strength (MPa): {material['Ultimate Tensile Strength (
| MPa)']}”)
117 | print(f”Elastic Limit(Mpa): {material['Elastic Limit(Mpa)']}”)
118 | print(f”Resistance Factors: {material['Resistance Factors']}”)
119 | return
120 | # If the material name is not found
121 | print(f”Material '{material_name}' not found.”)

122 print_material_info(material_name=”Titanium (Grade 5)”)

123
124 | def check_size_reduction_possibility(design_object, i, design_loads):
125 | design_object2 = copy.deepcopy(design_object)
126 | loads2 = copy.deepcopy(design_loads)
127 | loads2.F_y = 3.97 * design_loads.F_y
128 | if design_object2.D2_list[i] == 10.5: #https://amesweb.info/screws/Metric-Clearance-Hole-
| Chart.aspx
129 | design_object2.D2_list[i] = 8.4 | #https://fractory.com/metric-bolt-clearance-hole-
| size-chart/
130 | typer = ”M8”
131 | elif design_object2.D2_list[i] == 8.4:
132 | design_object2.D2_list[i] = 6.4
133 | typer = ”M6”
134 | elif design_object2.D2_list[i] == 6.4:
135 | design_object2.D2_list[i] = 5.3
136 | typer = ”M5”
137 | elif design_object2.D2_list[i] == 5.3:
138 | design_object2.D2_list[i] = 4.3
139 | typer = ”M4”
140 | elif design_object2.D2_list[i] ==4.3:
141 | design_object2.D2_list[i] = 3.2
142 | typer = ”M3”
143 | elif design_object2.D2_list[i] == 3.2:
144 | design_object2.D2_list[i] = 2.2
145 | typer = ”M2”
146 | elif design_object2.D2_list[i] == 2.2:
147 | design_object2.D2_list[i] = 1.7
148 | typer = ”M1.6”
149 | elif design_object2.D2_list[i] == 1.7:
150 | design_object2.D2_list[i] = 1.5
151 | typer = ”M1.4”
152 | elif design_object2.D2_list[i] == 1.5:
153 | design_object2.D2_list[i] = 1.3
154 | typer = ”M1.2”
155 | elif design_object2.D2_list[i] == 1.3:
156 | design_object2.D2_list[i] = 1.1
157 | typer = ”M1”
158 | else:
159 | return
160 | design_object2.fasteners = DesignClass.FastenerType(”Titanium (Grade 5)”,”Hexagonal”,”Nut
| -Tightened”)
161 | design_object2.fasteners.type_bolt = typer
162 | philist = calculate_force_ratio(design_object2.fasteners, design_object2, design_object2.
| material, ”7075-T6(DF-LT)”)[0]
163 | thermal_loads = CheckThermalStress.thermal_stress_calculation(design_object2, 150, -90,
| 15, philist
164 | | , material_fastener=
| design_object2.fasteners.material,
165 | | material_plate=
| design_object2.material)[0]
166 | check1a = False
167 | if CheckBearing.check_bearing_stress(design_object2, loads2,
168 | | thermal_loads) == ”Bearing Stress Check Pass”:
169 | print(”reduce hole acc to check1a, this one SHOULD be limiting”)
170 | check1a = True
171 | check2a = False
172 | if CheckPullThrough.check_pullthrough(design_object2, loads2)[0] == True:
173 | print(”reduce hole acc to check2a”)
174 | check2a = True
175 | if check2a == True and check1a == True:
176 | print(”decrease hole size”)
177 | design_object.D2_list[i] = design_object2.D2_list[i]
178 | design_object.fasteners = design_object2.fasteners
179 | check_size_reduction_possibility(design_object,i,design_loads)

### Listing A.9: SelectFastener.py code

1 | # This software component will return the results and provide a visualization in a graph. (
| maybe use the Inkscape
2 | # package to make a 3-view)

3 | import cadquery as cq
4 | import DesignClass
5 | #import cadquery.cqgi as cqgi

6

7
8 | from stl import mesh
9 | from mpl_toolkits import mplot3d
10 | from matplotlib import pyplot
11 | import copy

12
13 | def Visualize(design_object, index, move_y=0):
14 | design_object.hole_coordinate_list2=copy.deepcopy(design_object.hole_coordinate_list)
15 | for i in range(len(design_object.hole_coordinate_list2)):
16 | | a = design_object.hole_coordinate_list2[i][0]
17 | | design_object.hole_coordinate_list2[i] = (
18 | | design_object.hole_coordinate_list2[i][1] - design_object.bottomplatewidth / 2, a -
design_object.length / 2)
19 | | # make the base
20 | result = (
21 | | cq.Workplane(”XY”)
22 | | .box(design_object.bottomplatewidth, design_object.length, design_object.t2).faces(”>
Z”).workplane().tag(”noholes”)
23 | )

24
25 | for i in range(len(design_object.D2_list)):
26 | | result = result.workplaneFromTagged(”noholes”).pushPoints(design_object.
hole_coordinate_list2[i:i + 1]).hole(
27 | | design_object.D2_list[i])

28
29 | if design_object.w <= design_object.flange_height:
30 | | filletrad = design_object.w / 2
31 | else:
32 | | filletrad = design_object.flange_height / 2
33 | print(filletrad)
34 | result = result.faces(”<Y”).workplane(
35 | | offset=-design_object.offset
36 | ) | # workplane is offset from the object surface
37 | result = result.union(
38 | | cq.Workplane(”XZ”).box(design_object.w, design_object.flange_height + filletrad,
design_object.t1,
39 | | centered=[True, False, True]).edges(
40 | | ”|Y”).fillet(filletrad - 0.01).translate((0, 0, +design_object.t2 / 2 - filletrad
)).center(0,

41
| | -filletrad + design_object.t2 / 2).rect(
42 | | design_object.w, 2 * filletrad).cutThruAll().center(0, design_object.
flange_height).circle(
43 | | design_object.D1/2).cutThruAll().translate(
44 | | (0, (design_object.t1/2+design_object.h/2)*(design_object.N_Flanges-1), 0)))
45 | if design_object.N_Flanges == 2:
46 | | result = result.union(
47 | | cq.Workplane(”XZ”).box(design_object.w, design_object.flange_height + filletrad,
design_object.t1,
48 | | centered=[True, False, True]).edges(
49 | | ”|Y”).fillet(filletrad - 0.01).translate((0, 0, +design_object.t2 / 2 -
filletrad)).center(0,

50
| | -filletrad + design_object.t2 / 2).rect(
51 | | design_object.w, 2 * filletrad).cutThruAll().center(0, design_object.
flange_height).circle(
52 | | design_object.D1/2).cutThruAll().translate(
53 | | (0, -design_object.t1/2-design_object.h/2, 0)))
54 | if design_object.N_lugs == 2:
55 | | result = result.union(result.translate((0,move_y, 0)))
56 | design_object.volume = result.val().Volume()
57 | # Export
58 | if design_object.N_lugs == 2 and design_object.N_Flanges == 2:
59 | | cq.exporters.export(result, f”result{index}.stl”)
60 | | cq.exporters.export(result.section(), f”result{index}.dxf”)
61 | | cq.exporters.export(result, f”result{index}.step”)
62 | elif design_object.N_lugs == 2 and design_object.N_Flanges == 1:

63 | | cq.exporters.export(result, f”result{index}with2lugs1flange.stl”)
64 | | cq.exporters.export(result.section(), f”result{index}with2lugs1flange.dxf”)
65 | | cq.exporters.export(result, f”result{index}with2lugs1flange.step”)
66 | | elif design_object.N_lugs == 1 and design_object.N_Flanges == 2:
67 | | cq.exporters.export(result, f”result{index}with1lug2flanges.stl”)
68 | | cq.exporters.export(result.section(), f”result{index}with1lug2flanges.dxf”)
69 | | cq.exporters.export(result, f”result{index}with1lug2flanges.step”)
70 | | elif design_object.N_lugs == 1 and design_object.N_Flanges == 1:
71 | | cq.exporters.export(result, f”result{index}with1lug1flange.stl”)
72 | | cq.exporters.export(result.section(), f”result{index}with1lug1flange.dxf”)
73 | | cq.exporters.export(result, f”result{index}with1lug1flange.step”)

74
75 | # Create a new plot
76 | figure = pyplot.figure()
77 | | axes = figure.add_subplot(131, projection='3d')
78 | axes.view_init(elev=0, azim=0, roll=0)
79 | | axes2 = figure.add_subplot(132, projection='3d')
80 | axes2.view_init(elev=90, azim=0, roll=0)
81 | | pyplot.title(”A 3D STL file is generated in the main directory which \n can be viewed in
other software”)
82 | | axes3 = figure.add_subplot(133, projection='3d')
83 | axes3.view_init(elev=0, azim=90, roll=0)

84
85 | | # Load the STL files and add the vectors to the plot
86 | | your_mesh = mesh.Mesh.from_file('result.stl')
87 | | axes.add_collection3d(mplot3d.art3d.Poly3DCollection(your_mesh.vectors))
88 | | axes2.add_collection3d(mplot3d.art3d.Poly3DCollection(your_mesh.vectors))
89 | | axes3.add_collection3d(mplot3d.art3d.Poly3DCollection(your_mesh.vectors))

90
91 | # Auto scale to the mesh size
92 | scale = your_mesh.points.flatten()
93 | axes.auto_scale_xyz(scale, scale, scale)
94 | axes2.auto_scale_xyz(scale, scale, scale)
95 | axes3.auto_scale_xyz(scale, scale, scale)
96 | # Show the plot to the screen
97 | pyplot.show()

98
99 | def Visualize2(design_object, index):
100 | #Visualize(design_object)
101 | if design_object.N_lugs == 2:
102 | | Visualize(design_object,index=index, move_y=design_object.Dist_between_lugs)
103 | else:
104 | | Visualize(design_object, index=index ,move_y=0)

105
106 # debug_design4 = DesignClass.DesignInstance(h=30, t1=5, t2=10, t3=2, D1=10, w=80, material=” metal”, n_fast=4, \
107 | # | length=200, offset=20,flange_height=80, \
108 | # | hole_coordinate_list=[(20, 10), (180, 30),
(160, 20), (30, 30)], \
109 | # | D2_list=[10, 5, 9, 8], yieldstrength=83,N_lugs
=2,N_Flanges=1)
110 | # debug_design4.Dist_between_lugs = 300
111 | # Visualize2(debug_design4)

112
113 # #debug_design4 = DesignClass.DesignInstance(h=30, t1=5, t2=0.1, t3=2, D1=10, w=40, material =”metal”, n_fast=4, \
114 | # | length=80, offset=20,flange_height=80, \
115 | # | hole_coordinate_list=[(21, 20.5), (81, 20.5),
(41, 20.5), (61, 20.5)], \
116 | # | D2_list=[6, 6, 6, 6], yieldstrength=83,N_lugs=2,
N_Flanges=2, Dist_between_lugs=300)
117 # #Visualize2(debug_design4)

### Listing A.10: PostProcessorAndVisualizer.py code

1 # This software component will do the whole analysis for two different materials, and then compare them.
2 | def TradeOff(design_array2):
3 | for design in design_array2:
4 | print(f”{design.material}”)
5 | | print(f”checklist: {design.checklist}, h: {design.h}, t1: {design.t1}, t2: {design.t2
| | }, t3: {design.t3}, D1: {design.D1}, w: {design.w}, length: {design.length}, offset: {

design.offset}, flange height: {design.flange_height}, yieldstrength: {design. yieldstrength}, material: {design.material}, Dist_between_lugs: {design.Dist_between_lugs }, N_lugs: {design.N_lugs}, N_Flanges: {design.N_Flanges}, hole coords: {design. hole_coordinate_list}, n_fast: {design.n_fast}, D2holes: {design.D2_list}, bottomplatewidth: {design.bottomplatewidth}, shearstrength: {design.shearstrength}”)
6 | print(f”nut type: {design.fasteners.nut_type}, hole type: {design.fasteners.hole_type
| }, material: {design.fasteners.material}, bolt type: {design.fasteners.type_bolt}”)
7 | print(f”mass: {design.mass}”)
8 | print(f”MS: {design.MS}”)
9 | print(””)

10
11 | # add comparison/trade-off here

### Listing A.11: TradeOffComperator.py code

1 | # Use the official Python image from the Docker Hub
2 | FROM python:3.9

3
4 | # Set the working directory in the container to /app
5 | WORKDIR /app

6
7 | # Copy all contents from the current directory to /app in the container
8 | COPY . /app

9
10 | # Install any dependencies your Python application needs
11 | RUN pip install -r requirements.txt | # If you have a requirements.txt file

12
13 | # Set the entry point to your main Python file
14 | CMD [”python”, ”MainOptimizer.py”]

### Listing A.12: Dockerfile code

1 | # Byte-compiled / optimized / DLL files
2 | __pycache__/
3 | *.py[cod]
4 | *$py.class
5 | *.pyc
6 | *dxf
7 | *.step
8 | *.stl

9
10 | # C extensions
11 | *.so

12
13 | # Distribution / packaging
14 | .Python
15 | build/
16 | develop-eggs/
17 | dist/
18 | downloads/
19 | eggs/
20 | .eggs/
21 | lib/
22 | lib64/
23 | parts/
24 | sdist/
25 | var/
26 | wheels/
27 | share/python-wheels/
28 | *.egg-info/
29 | .installed.cfg
30 | *.egg
31 | MANIFEST

32
33 | # PyInstaller
34 | # | Usually these files are written by a python script from a template
35 | # | before PyInstaller builds the exe, so as to inject date/other infos into it.
36 | *.manifest
37 | *.spec

38
39 # Installer logs

40 | pip-log.txt
41 | pip-delete-this-directory.txt

42
43 | # Unit test / coverage reports
44 | htmlcov/
45 | .tox/
46 | .nox/
47 | .coverage
48 | .coverage.*
49 | .cache
50 | nosetests.xml
51 | coverage.xml
52 | *.cover
53 | *.py,cover
54 | .hypothesis/
55 | .pytest_cache/
56 | cover/

57
58 | # Translations
59 | *.mo
60 | *.pot

61
62 | # Django stuff:
63 | *.log
64 | local_settings.py
65 | db.sqlite3
66 | db.sqlite3-journal

67
68 | # Flask stuff:
69 | instance/
70 | .webassets-cache

71
72 | # Scrapy stuff:
73 | .scrapy

74
75 | # Sphinx documentation
76 | docs/_build/

77
78 | # PyBuilder
79 | .pybuilder/
80 | target/

81
82 | # Jupyter Notebook
83 | .ipynb_checkpoints

84
85 | # IPython
86 | profile_default/
87 | ipython_config.py

88
89 | # pyenv
90 | # | For a library or package, you might want to ignore these files since the code is
91 | # | intended to run in multiple environments; otherwise, check them in:
92 | # .python-version

93
94 | # pipenv
95 | # | According to pypa/pipenv#598, it is recommended to include Pipfile.lock in version
| | control.
96 | # | However, in case of collaboration, if having platform-specific dependencies or
| | dependencies
97 | # | having no cross-platform support, pipenv may install dependencies that don't work, or not
98 | # | install all needed dependencies.
99 | #Pipfile.lock

100
101 | # poetry
102 | # | Similar to Pipfile.lock, it is generally recommended to include poetry.lock in version
| | control.
103 | # | This is especially recommended for binary packages to ensure reproducibility, and is more
104 | # | commonly ignored for libraries.
105 | # | https://python-poetry.org/docs/basic-usage/#commit-your-poetrylock-file-to-version-
| | control
106 | #poetry.lock

107
108 | # pdm
109 | # | Similar to Pipfile.lock, it is generally recommended to include pdm.lock in version
control.
110 | #pdm.lock
111 | # | pdm stores project-wide configurations in .pdm.toml, but it is recommended to not include
it
112 | # | in version control.
113 | # | https://pdm.fming.dev/#use-with-ide
114 | .pdm.toml

115
116 | # PEP 582; used by e.g. github.com/David-OConnor/pyflow and github.com/pdm-project/pdm
117 | __pypackages__/

118
119 | # Celery stuff
120 | celerybeat-schedule
121 | celerybeat.pid

122
123 | # SageMath parsed files
124 | *.sage.py

125
126 | # Environments
127 | .env
128 | .venv
129 | env/
130 | venv/
131 | ENV/
132 | env.bak/
133 | venv.bak/

134
135 | # Spyder project settings
136 | .spyderproject
137 | .spyproject

138
139 | # Rope project settings
140 | .ropeproject

141
142 | # mkdocs documentation
143 | /site

144
145 | # mypy
146 | .mypy_cache/
147 | .dmypy.json
148 | dmypy.json

149
150 | # Pyre type checker
151 | .pyre/

152
153 | # pytype static type analyzer
154 | .pytype/

155
156 | # Cython debug symbols
157 | cython_debug/

158
159 | # PyCharm
160 | # | JetBrains specific template is maintained in a separate JetBrains.gitignore that can
161 | # | be found at https://github.com/github/gitignore/blob/main/Global/JetBrains.gitignore
162 | # | and can be added to the global gitignore or merged into this file. | For a more nuclear
163 | # | option (not recommended) you can uncomment the following to ignore the entire idea folder.
164 | #.idea/

### Listing A.13: Python.gitignore code

1 | numpy==1.24.3
2 | matplotlib==3.7.1
3 | scipy==1.10.1
4 | cadquery==2.3.1
5 | numba == 0.58.1
6 | numpy-stl == 3.1.1

### Listing A.14: Requirements.txt code

B

# CAD Drawings

The CAD Drawing can be found on the next page.

This page was intentionally left blank.

56

4

⌀ 2.2

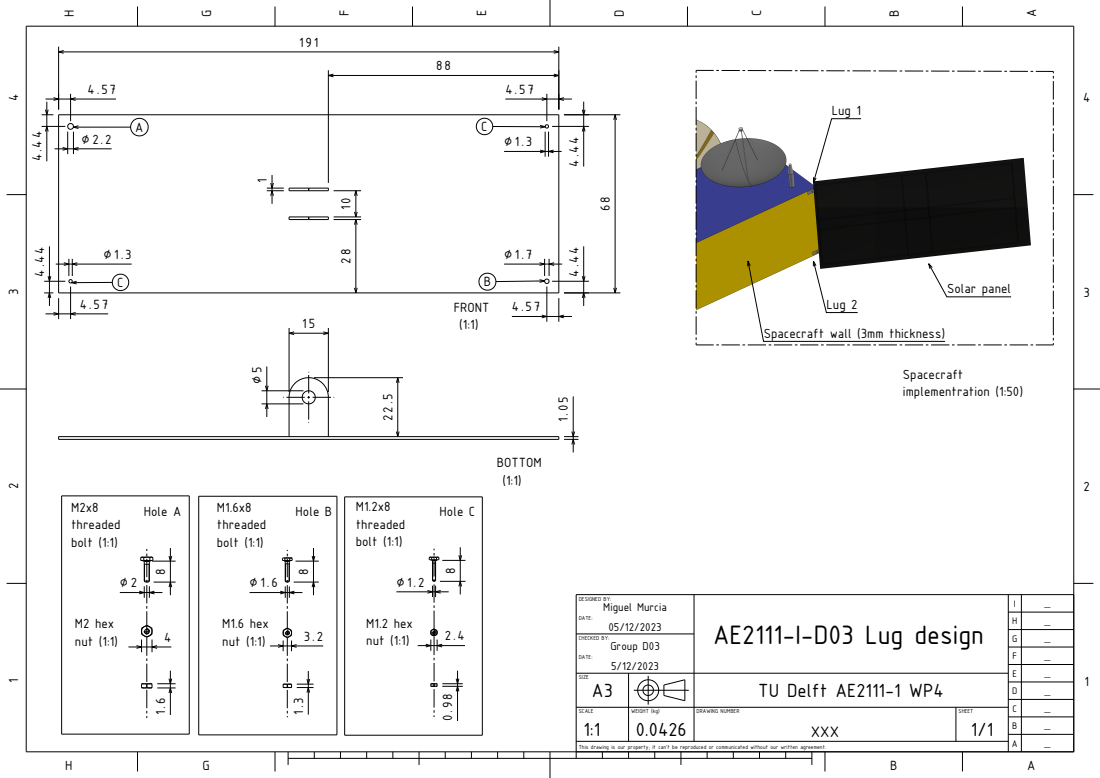
[picture p16: page 66]
CHECKED BY:; Group D03; DATE:; Hole A; Hole B; Hole C; FRONT (1:1); BOTTOM (1:1); M2x8 threaded bolt (1:1); M1.6x8 threaded bolt (1:1); M1.2x8 threaded bolt (1:1); M2 hex nut (1:1); M1.2 hex nut (1:1); M1.6 hex nut (1:1); Lug 1; Lug 2; Solar panel; Spacecraft implementration (1:50)

Spacecraft wall (3mm thickness)

DESIGNED BY: Miguel Murcia DATE: 05/12/2023 | AE2111-I-D03 Lug design | I | _

SIZE A3 | | | | TU Delft AE2111-1 WP4

SCALE 1:1 | WEIGHT (kg) 0.0426 | DRAWING NUMBER XXX | SHEET 1/1

This drawing is our property; it can't be reproduced or communicated without our written agreement.

C

# Task Distribution

### Table C.1: Task Distribution

Chapter | Task | Who
Load Analysis | Launch Load | V. Fossa, G.Ruiz, A.Bilbao
| Operational Load | M.Murcia, A.Bilbao
Lug Configuration | Selection of lug configuration | A.Orban, L. Huirne, M.Murcia
| Design of the flange | V. Fossa, A. Bilbao, A.Orban, L. Huirne
| Optimization of the flange design | A.Orban
Fastener Configuration | Select fastener pattern | G.Ruiz
| Bearing check | J. Qi , M. Özözgür
| Pull through check | V. Fossa, G.Ruiz, M.Murcia
| Selection of fastener | J. Qi, M. Özözgür, L. Huirne
Thermal Stress and Material Selection | Thermal stress check | V. Fossa, G.Ruiz
| Fastener material selection | M. Özözgür
| Lug material selection | A.Bilbao, A.Orban
| Final Design | A.Bilbao
Post Processing and Visualisation | Post Processing and Visualisation | L. Huirne
CAD Drawing | CAD Drawing | M.Murcia
Miscellaneous | Introduction | V. Fossa
| Conclusion | G.Ruiz
| Summary and preface | V. Fossa
| Nomenclature | G.Ruiz
| Main Optimizer | L. Huirne
| Set-up of Code repository | L. Huirne

58
