HuiLucas/LugDesign/result.step

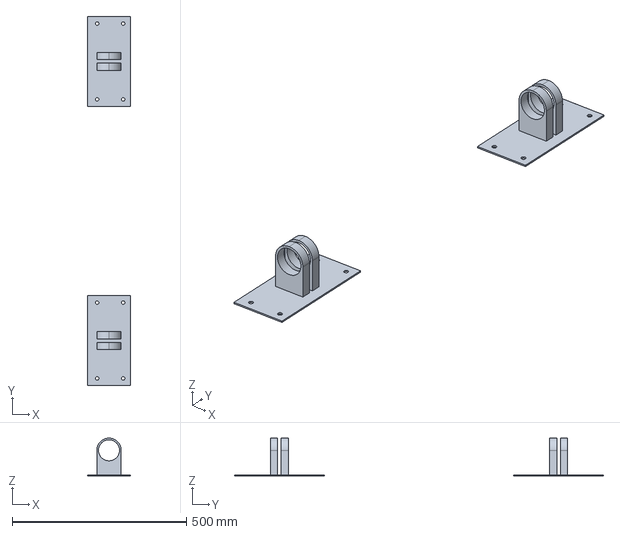
[picture p17: CAD file, 2023-12-03]
result.step
123.2 x 1058.0 x 108.5 mm
