HuiLucas/LugDesign/results/High Accuracy Best Material 1 lug 1 flange/resulthighaccuracy1flange1lug.step

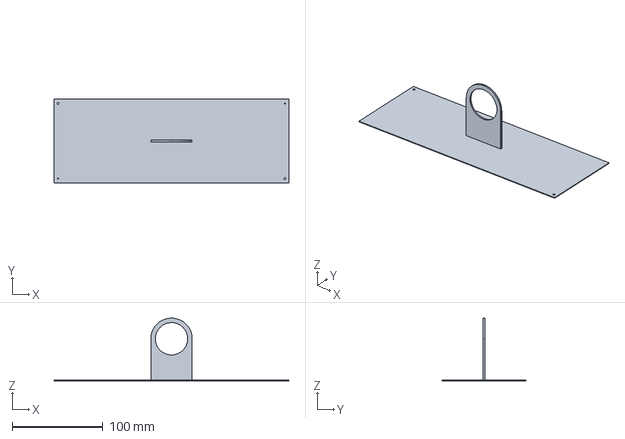
[picture p18: CAD file, 2023-12-04]
results/High Accuracy Best Material 1 lug 1 flange/resulthighaccuracy1flange1lug.step
258.5 x 92.0 x 69.1 mm
