HuiLucas/LugDesign/results/High Accuracy Best Material 2 lugs 2 flanges/resulthighaccuracy2flanges2lugs.step

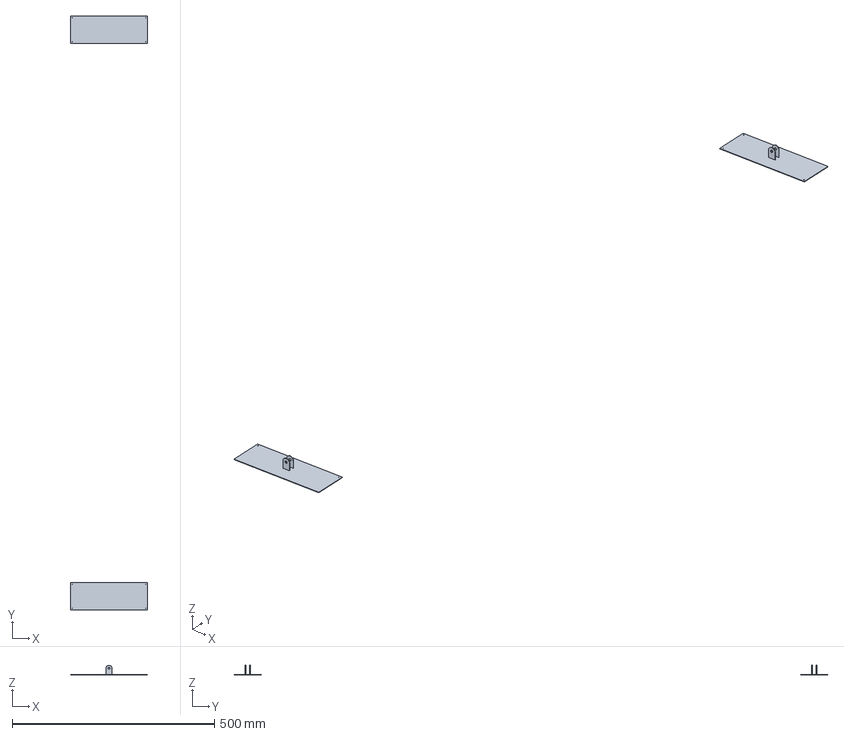
[picture p19: CAD file, 2023-12-04]
results/High Accuracy Best Material 2 lugs 2 flanges/resulthighaccuracy2flanges2lugs.step
191.0 x 1468.0 x 23.5 mm
