HuiLucas/LugDesign/results/Low Accuracy All materials 1 lug 1 flange/result7with1lug1flange.step

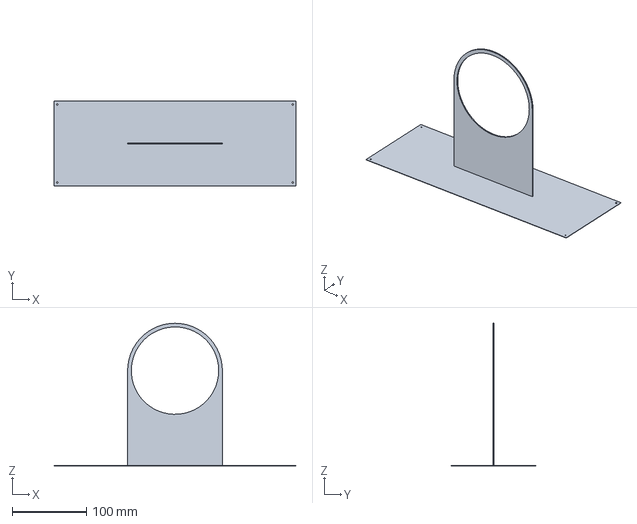
[picture p20: CAD file, 2023-12-04]
results/Low Accuracy All materials 1 lug 1 flange/result7with1lug1flange.step
325.5 x 114.0 x 191.7 mm
