HuiLucas/LugDesign/results/Low Accuracy All Materials 2 lugs 2 Flanges/result5.step

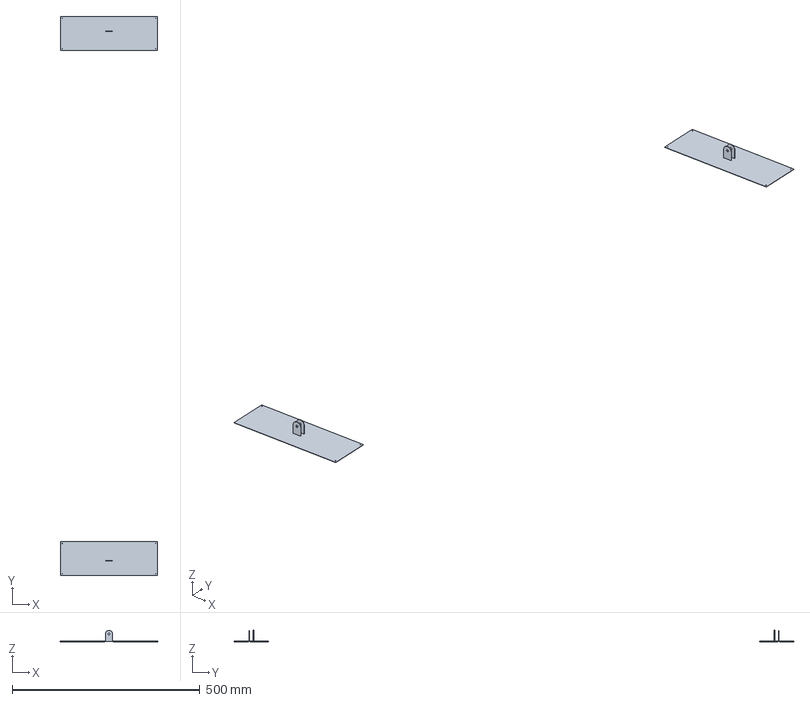
[picture p21: CAD file, 2023-12-04]
results/Low Accuracy All Materials 2 lugs 2 Flanges/result5.step
258.6 x 1490.0 x 30.1 mm
