HuiLucas/LugDesign/results/Low Accuracy All materials 1 lug 1 flange/result2with1lug1flange.step

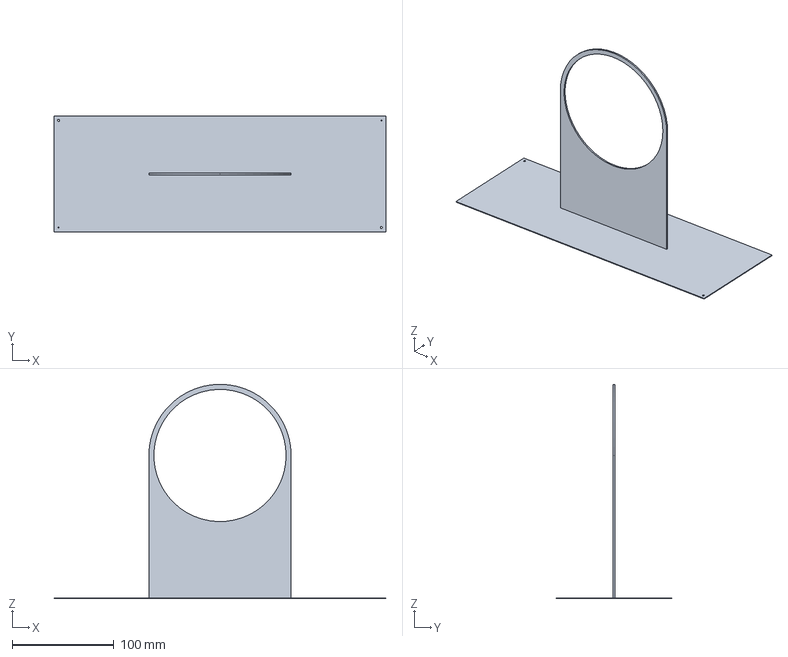
[picture p22: CAD file, 2023-12-04]
results/Low Accuracy All materials 1 lug 1 flange/result2with1lug1flange.step
325.6 x 114.0 x 210.3 mm
