HuiLucas/LugDesign/results/Low Accuracy All materials 1 lug 1 flange/result9with1lug1flange.step

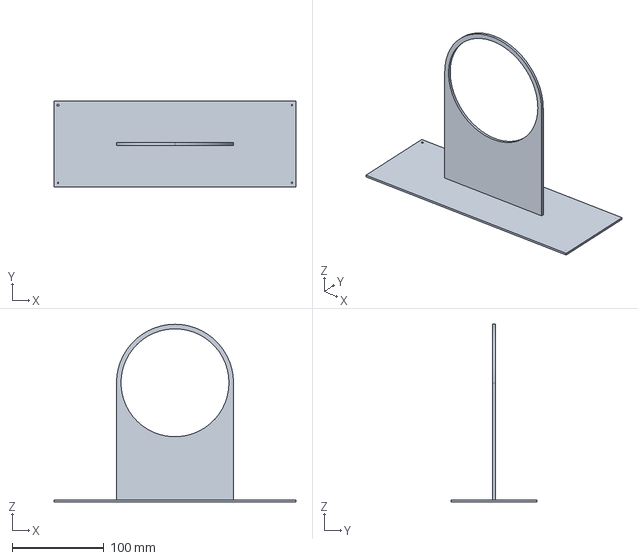
[picture p23: CAD file, 2023-12-04]
results/Low Accuracy All materials 1 lug 1 flange/result9with1lug1flange.step
263.5 x 94.0 x 193.3 mm
