HuiLucas/LugDesign/results/Low Accuracy All Materials 2 lugs 2 Flanges/result10.step

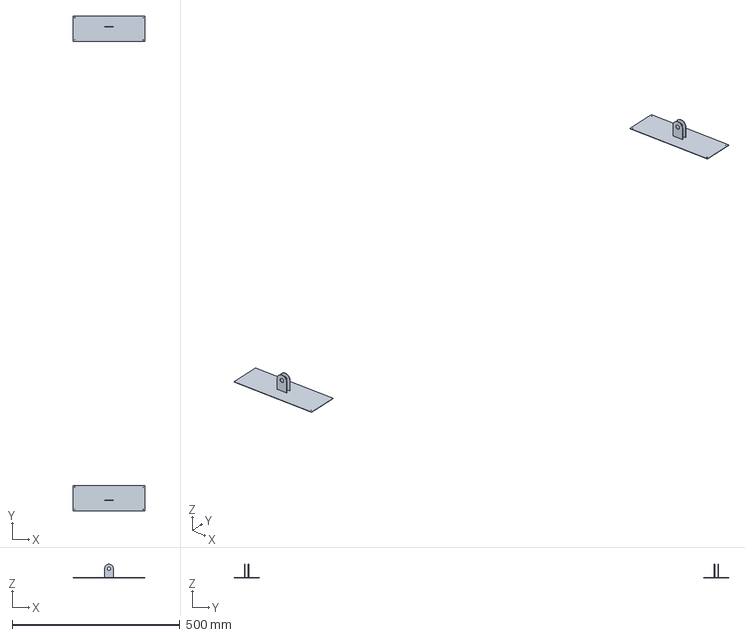
[picture p24: CAD file, 2023-12-04]
results/Low Accuracy All Materials 2 lugs 2 Flanges/result10.step
214.6 x 1476.0 x 40.8 mm
