HuiLucas/LugDesign/results/Low Accuracy All materials 1 lug 1 flange/result5with1lug1flange.step

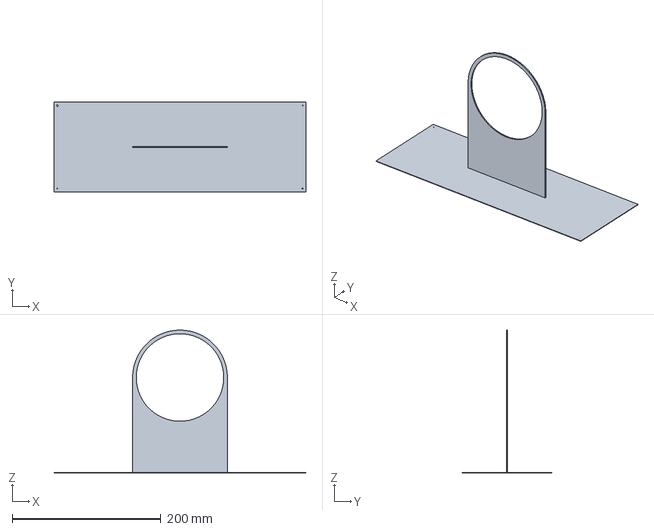
[picture p25: CAD file, 2023-12-04]
results/Low Accuracy All materials 1 lug 1 flange/result5with1lug1flange.step
338.5 x 121.0 x 192.0 mm
