HuiLucas/LugDesign/results/Low Accuracy All Materials 2 lugs 2 Flanges/result8.step

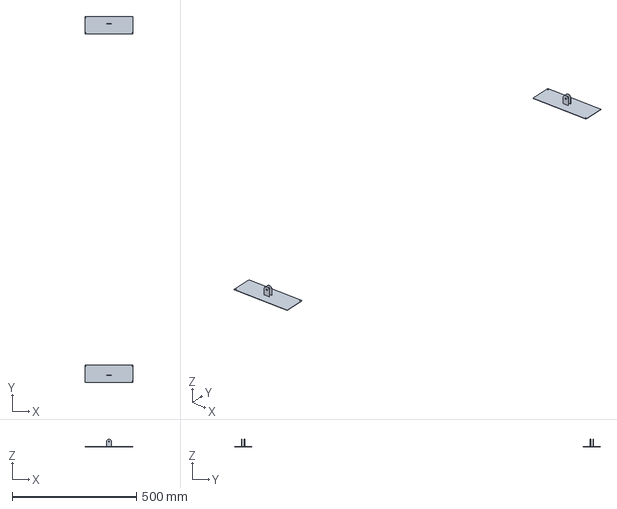
[picture p26: CAD file, 2023-12-04]
results/Low Accuracy All Materials 2 lugs 2 Flanges/result8.step
194.6 x 1470.0 x 30.4 mm
