HuiLucas/LugDesign/results/Low Accuracy All materials 1 lug 1 flange/result10with1lug1flange.step

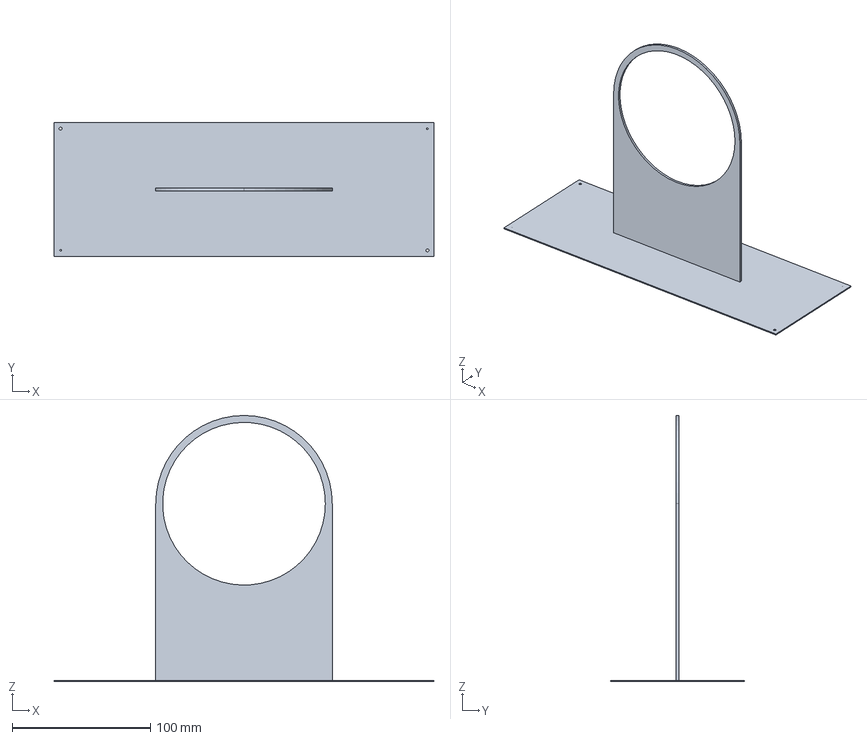
[picture p27: CAD file, 2023-12-04]
results/Low Accuracy All materials 1 lug 1 flange/result10with1lug1flange.step
274.5 x 97.0 x 192.2 mm
