HuiLucas/LugDesign/results/Low Accuracy All materials 1 lug 1 flange/result6with1lug1flange.step

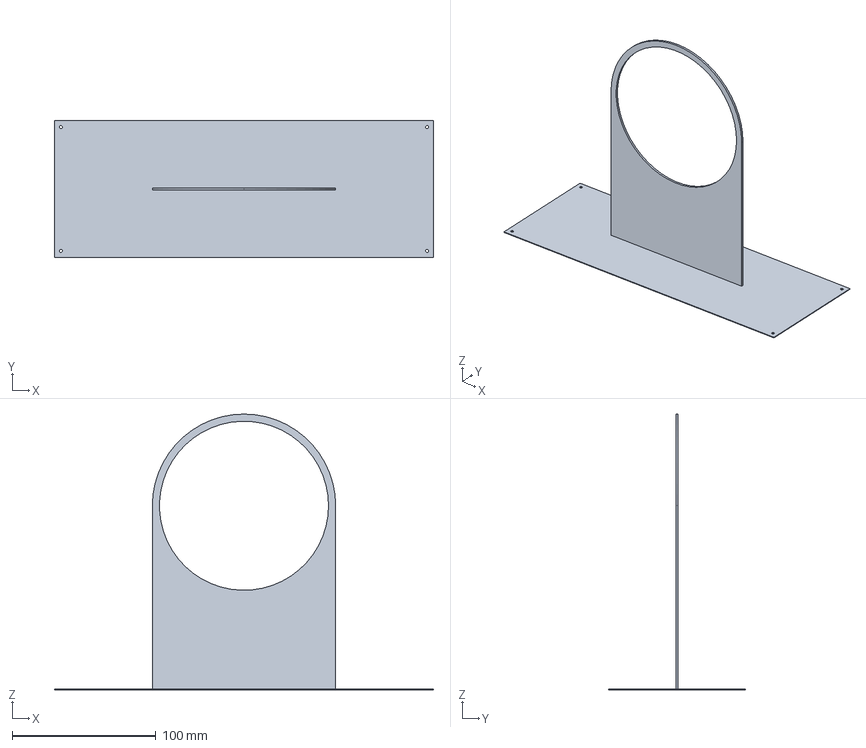
[picture p28: CAD file, 2023-12-04]
results/Low Accuracy All materials 1 lug 1 flange/result6with1lug1flange.step
263.5 x 95.0 x 191.8 mm
