HuiLucas/LugDesign/results/Low Accuracy All Materials 2 lugs 2 Flanges/result7.step

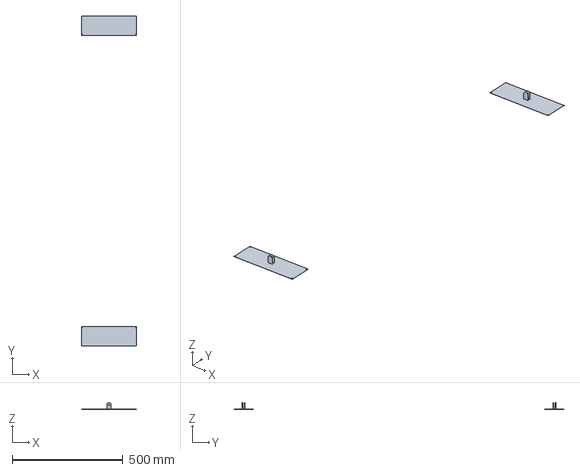
[picture p29: CAD file, 2023-12-04]
results/Low Accuracy All Materials 2 lugs 2 Flanges/result7.step
249.6 x 1487.0 x 29.8 mm
