HuiLucas/LugDesign/results/Low Accuracy All Materials 2 lugs 2 Flanges/result0.step

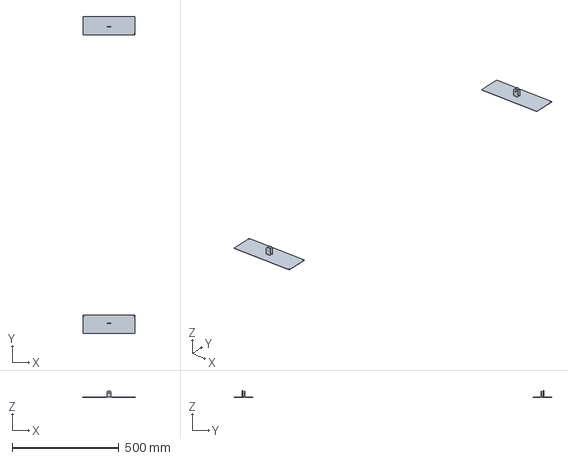
[picture p30: CAD file, 2023-12-04]
results/Low Accuracy All Materials 2 lugs 2 Flanges/result0.step
244.6 x 1486.0 x 30.2 mm
