HuiLucas/LugDesign/results/Low Accuracy All materials 1 lug 1 flange/result0with1lug1flange.step

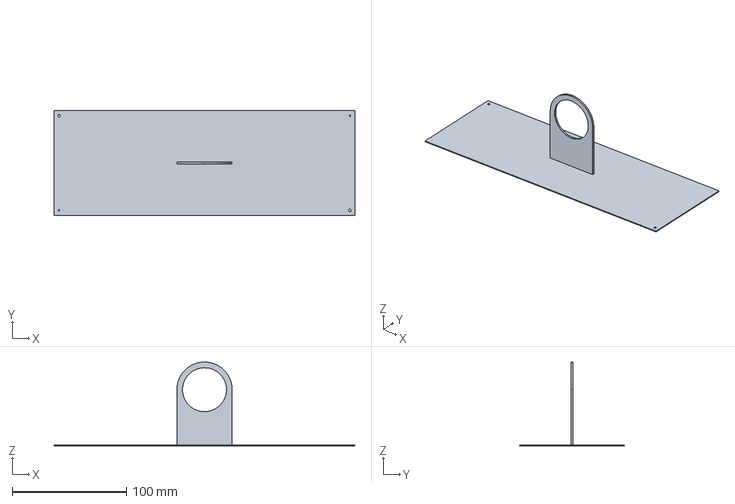
[picture p31: CAD file, 2023-12-04]
results/Low Accuracy All materials 1 lug 1 flange/result0with1lug1flange.step
263.5 x 92.0 x 73.5 mm
