HuiLucas/LugDesign/results/Low Accuracy All materials 1 lug 1 flange/result8with1lug1flange.step

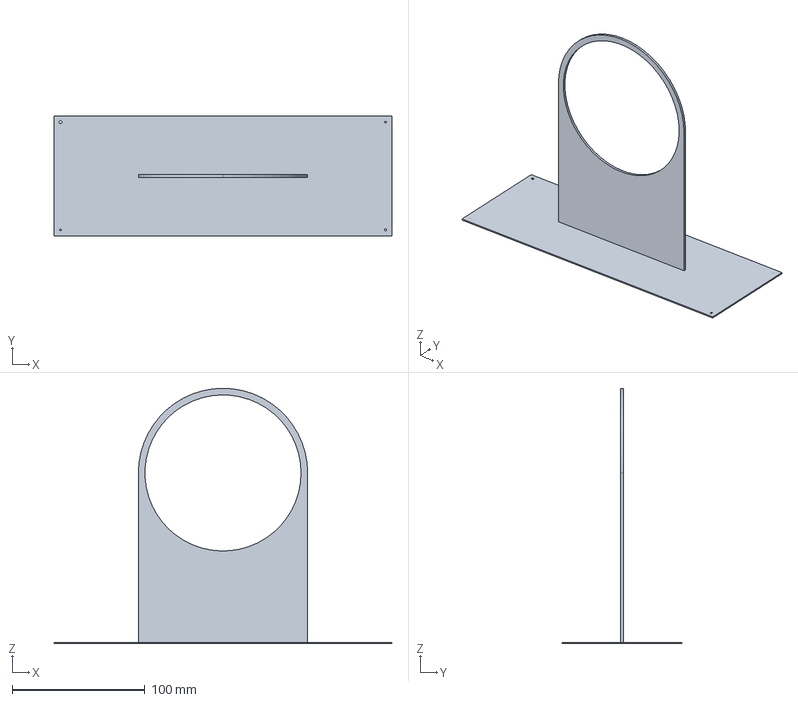
[picture p32: CAD file, 2023-12-04]
results/Low Accuracy All materials 1 lug 1 flange/result8with1lug1flange.step
254.5 x 90.0 x 192.3 mm
