HuiLucas/LugDesign/results/Low Accuracy All Materials 2 lugs 2 Flanges/result9.step

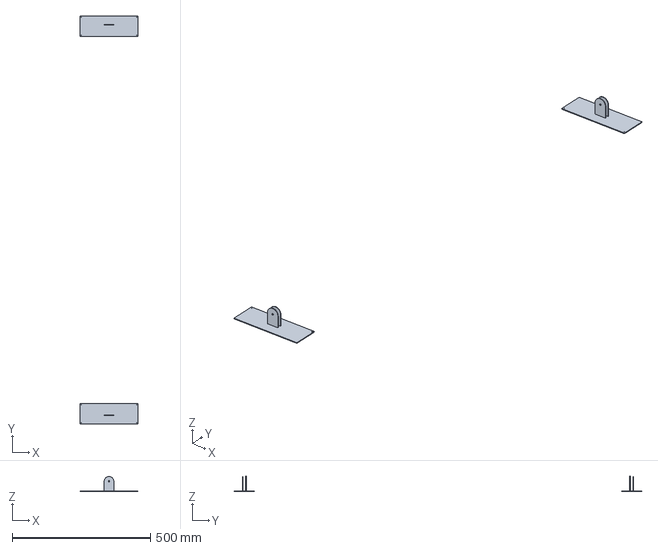
[picture p33: CAD file, 2023-12-04]
results/Low Accuracy All Materials 2 lugs 2 Flanges/result9.step
209.9 x 1475.0 x 54.4 mm
