HuiLucas/LugDesign/results/Low Accuracy All Materials 2 lugs 2 Flanges/result6.step

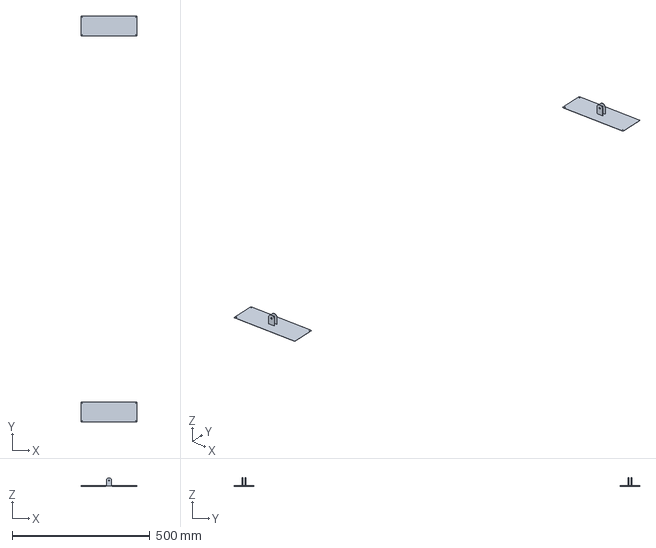
[picture p34: CAD file, 2023-12-04]
results/Low Accuracy All Materials 2 lugs 2 Flanges/result6.step
202.6 x 1472.0 x 29.9 mm
