HuiLucas/LugDesign/(list of files, cad)

Other CAD files:
results/Low Accuracy All Materials 2 lugs 2 Flanges/result3.step
results/Low Accuracy All Materials 2 lugs 2 Flanges/result4.step
results/Low Accuracy All materials 1 lug 1 flange/result3with1lug1flange.step
results/Low Accuracy All Materials 2 lugs 2 Flanges/result1.step
results/Low Accuracy All materials 1 lug 1 flange/result1with1lug1flange.step
results/Low Accuracy All Materials 2 lugs 2 Flanges/result2.step
results/Low Accuracy All materials 1 lug 1 flange/result4with1lug1flange.step
result.dxf
results/High Accuracy Best Material 1 lug 1 flange/resulthighaccuracy1flange1lug.dxf
results/High Accuracy Best Material 1 lug 1 flange/resulthighaccuracy1flange1lug.stl
results/High Accuracy Best Material 2 lugs 2 flanges/resulthighaccuracy2flanges2lugs.dxf
results/High Accuracy Best Material 2 lugs 2 flanges/resulthighaccuracy2flanges2lugs.stl
results/Low Accuracy All Materials 2 lugs 2 Flanges/result0.dxf
results/Low Accuracy All Materials 2 lugs 2 Flanges/result0.stl
results/Low Accuracy All Materials 2 lugs 2 Flanges/result1.dxf
results/Low Accuracy All Materials 2 lugs 2 Flanges/result1.stl
results/Low Accuracy All Materials 2 lugs 2 Flanges/result10.dxf
results/Low Accuracy All Materials 2 lugs 2 Flanges/result10.stl
results/Low Accuracy All Materials 2 lugs 2 Flanges/result2.dxf
results/Low Accuracy All Materials 2 lugs 2 Flanges/result2.stl
results/Low Accuracy All Materials 2 lugs 2 Flanges/result3.dxf
results/Low Accuracy All Materials 2 lugs 2 Flanges/result3.stl
results/Low Accuracy All Materials 2 lugs 2 Flanges/result4.dxf
results/Low Accuracy All Materials 2 lugs 2 Flanges/result4.stl
results/Low Accuracy All Materials 2 lugs 2 Flanges/result5.dxf
results/Low Accuracy All Materials 2 lugs 2 Flanges/result5.stl
results/Low Accuracy All Materials 2 lugs 2 Flanges/result6.dxf
results/Low Accuracy All Materials 2 lugs 2 Flanges/result6.stl
results/Low Accuracy All Materials 2 lugs 2 Flanges/result7.dxf
results/Low Accuracy All Materials 2 lugs 2 Flanges/result7.stl
results/Low Accuracy All Materials 2 lugs 2 Flanges/result8.dxf
results/Low Accuracy All Materials 2 lugs 2 Flanges/result8.stl
results/Low Accuracy All Materials 2 lugs 2 Flanges/result9.dxf
results/Low Accuracy All Materials 2 lugs 2 Flanges/result9.stl
results/Low Accuracy All materials 1 lug 1 flange/result0with1lug1flange.dxf
results/Low Accuracy All materials 1 lug 1 flange/result0with1lug1flange.stl
results/Low Accuracy All materials 1 lug 1 flange/result10with1lug1flange.dxf
results/Low Accuracy All materials 1 lug 1 flange/result10with1lug1flange.stl
results/Low Accuracy All materials 1 lug 1 flange/result1with1lug1flange.dxf
results/Low Accuracy All materials 1 lug 1 flange/result1with1lug1flange.stl
results/Low Accuracy All materials 1 lug 1 flange/result2with1lug1flange.dxf
results/Low Accuracy All materials 1 lug 1 flange/result2with1lug1flange.stl
results/Low Accuracy All materials 1 lug 1 flange/result3with1lug1flange.dxf
results/Low Accuracy All materials 1 lug 1 flange/result3with1lug1flange.stl
results/Low Accuracy All materials 1 lug 1 flange/result4with1lug1flange.dxf
results/Low Accuracy All materials 1 lug 1 flange/result4with1lug1flange.stl
results/Low Accuracy All materials 1 lug 1 flange/result5with1lug1flange.dxf
results/Low Accuracy All materials 1 lug 1 flange/result5with1lug1flange.stl
results/Low Accuracy All materials 1 lug 1 flange/result6with1lug1flange.dxf
results/Low Accuracy All materials 1 lug 1 flange/result6with1lug1flange.stl
results/Low Accuracy All materials 1 lug 1 flange/result7with1lug1flange.dxf
results/Low Accuracy All materials 1 lug 1 flange/result7with1lug1flange.stl
results/Low Accuracy All materials 1 lug 1 flange/result8with1lug1flange.dxf
results/Low Accuracy All materials 1 lug 1 flange/result8with1lug1flange.stl
results/Low Accuracy All materials 1 lug 1 flange/result9with1lug1flange.dxf
results/Low Accuracy All materials 1 lug 1 flange/result9with1lug1flange.stl
