HuiLucas/LugDesign/(commit log)

2023-11-21 Added Plotting Possibilities
    [result.dxf, result.step, result.stl]
2023-11-21 Made it work again
    [result.dxf, result.step]
2023-11-21 made package requirements file
    [result.dxf, result.step]
2023-11-22 restructure code
    [result.dxf, result.step, result.stl]
2023-11-23 proposed change in structure for hole coordinates
    [result.dxf, result.step]
2023-11-23 Changed structure in class
    [result.dxf, result.step, result.stl]
2023-11-23 added yield stress to class
    [result.dxf, result.step]
2023-11-23 added realistic laod case
2023-11-29 finished integrating lug optimizer
    [result.dxf, result.step, result.stl]
2023-11-29 improved structure
    [result.dxf, result.step]
2023-11-30 made visualizer suitable for different amount of flanges/lugs
    [result.dxf, result.step, result.stl]
2023-11-30 added numba to make it faster
    [result.dxf, result.step, result.stl]
2023-11-30 Final Optimization
    [result.dxf, result.step, result.stl]
2023-11-30 made better
    [result.dxf, result.step, result.stl]
2023-11-30 fixed units for bearing check
2023-12-02 optimizer step 1
    [result.dxf, result.step, result.stl]
2023-12-02 changed SelectFastener.py
    [result.dxf, result.step]
2023-12-03 working code
    [result.dxf, result.step, result.stl]
2023-12-03 incorporated thermal loads and fastener selection
    [result.dxf, result.step, result.stl]
2023-12-03 made localloadcalculator and lug designer better
    [result.dxf, result.step]
2023-12-03 major update mainoptimizer
    [result.dxf, result.step, result.stl]
2023-12-03 it works now?!
    [result.dxf, result.step, result.stl]
2023-12-03 make design for every material
    [result0.dxf, result0.step, result0.stl]
2023-12-03 test 1
    [result0.step, result1.dxf, result1.step, result1.stl]
2023-12-03 test 2
    [result0.dxf, result0.step, result1.dxf, result1.step, result1.stl]
2023-12-03 test 3
    [result0.stl, result1.dxf, result1.step, result1.stl, result10.dxf, result10.step, result10.stl, result2.dxf]
2023-12-03 test 4
    [result0.dxf, result0.step, result0.stl, result1.dxf, result1.step, result1.stl, result2.dxf, result2.step]
2023-12-04 mass calculations added
    [result0.dxf, result0.step, result0.stl, result1.dxf, result1.step, result1.stl, result2.dxf, result2.step]
2023-12-04 added dockerfile
    [result0.dxf, result0.step, result0.stl]
2023-12-04 added reduce fastener size
    [result0.dxf, result0.step, result0.stl]
2023-12-04 added bolt selector
    [result0.dxf, result0.step, result0.stl]
2023-12-04 added bolt become-small-inator
    [result0.dxf, result0.step, result0.stl]
2023-12-04 some corrections
    [result0.dxf, result0.step, result0.stl]
2023-12-04 final version (hopefully)
    [result0.dxf, result0.step, result0.stl, result1.dxf, result1.step, result1.stl, result10.dxf, result10.step]
2023-12-05 Upload results file
    [result0.dxf, result0.step, result0.stl, result0with1lug1flange.dxf, result0with1lug1flange.step, result0with1lug1flange.stl, result1.dxf, result1.step]
